2BitwiseBard/rocky/README.md

# PROJECT ROCKY — Pebble

A 1:3-scale, radially symmetric **pentapod walking robot** (five legs, three
servos each, transforming hands) built from parametric 3D-printed parts and
Feetech bus servos, with a MuJoCo simulation that walks, gestures and gets
itself back up, and a tool harness that lets a person or a language model
drive it by text, voice or MCP.

<p align="center">
  shove → tumble → self-right → walk away (MuJoCo)<br>
  <em>The D048 shove: 40 N at the shell rim (10 N·s, 1.5× bodyweight), a tumble, the <code>recover1</code> righter and the planted ramp stand it up, and the analytic gait walks away.</em>
</p>
<p align="center">
  the wave gait<br>
  <em>The five-phase wave gait, closed-form IK, no learning: 2.0 s cycle, 24 mm step, and since D063 a soft-landing swing: walking at up to 34.2 mm/s and turning at 0.185 rad/s, both inside the servo's budget.</em>
</p>

The physical robot is not assembled yet. Everything "green" below is green
in simulation or in CAD checks, which this project treats as a different
claim from "it works on hardware".

## Status (2026-10-09)

| area | state | evidence |
|---|---|---|
| **CAD** | print-clean, rebuilt around a **measured STEP of the real ST3215** (D047). The body layout is **built** from the owner's 15 picks (D064, 2026-10-07/08): a keel tub 8 mm under the deck holds the 380 g battery sled, with the XT60 mate and the loop key in its nose and a door on one I3 latch; the hub shelf under the deck's north half carries the bus adapter, buck and UBEC face-down beside the 12 V node and the star board; the tray holds the Pi on 11 mm standoffs and comes out only with the carapace off; the stand is a cradle for the tub; the I1 leg port docks on cone seats (`check_dock.py`). A FreeCAD / CalculiX stress check loads the leg parts with what the servos can push (D061): 4 of 5 pass, and **`coxa_yaw_base` fails at SF 1.10** in the servo-stall case on the real I1 support, an owner decision still to come (B139) | `cad/run_all_checks.py` **31/31** (29 modules, `check_printability` 61 parts 0 hard, `check_sim_mirror`), [docs/PRINT_PLAN.md](docs/PRINT_PLAN.md) |
| **Physical build** | nothing printed, nothing ordered, nothing assembled; the first prints (pre-D047) did not fit and are retired. The order of buying and printing is [docs/BUY_AND_PRINT_ORDER.md](docs/BUY_AND_PRINT_ORDER.md): the port coupons (the deck patch and four plates) print first; print one `coxa_yaw_base` for the bench, not five, until B139 is decided. The assembly guide walks the build step by step from the CAD. The bench kit (one leg: 4 × ST3215, bus adapter, adjustable supply, fasteners) is ~$282, the core robot ~$1,265 (`bom/totals.py`, 2026-10-08) | [docs/ASSEMBLY_GUIDE.md](docs/ASSEMBLY_GUIDE.md), [bom/BOM.csv](bom/BOM.csv), [bom/README.md](bom/README.md), `media/2026-09-22_first_prints.jpg` |
| **Sim + control** | the sim stops flattering the servo (D052/D052a): a peak-torque clip plus a thermal budget, every motion through one feasibility checker and the gait envelope (34.2 mm/s, 0.185 rad/s). Since D064 it carries the **belly** (the keel tub, the hub shelf's plate and posts as contact geoms) and the torso's real mass, CoM and inertia from a CAD pose table: torso 1555.0 g, robot 2843.0 g, fingerprint `965f4f70e5d1`. Wave gait: 189 of ~198 mm in 6 s, 0.42° max tilt; standing shove floor 30 N (1.08 BW). An always-on void guard stops walks at an edge; in a lip band of approach angles (8 of 364) the robot no longer falls off but tips 20–24° onto the keel and hangs there. A **body leveler** (D065) raises feet from the IMU tilt (standing on 8° 8.06 → 2.96–3.22°, on a 20 mm stone 3.88 → 0.36°), but lands **off**: its terrain bench (`sim/terrain_bench.py`) first failed on the plane a noisy IMU or a turn, a stop or a shove leaves on flat ground, the 5 % slower walk on a levelled slope (the derate alone is 94.97 % of the bare envelope), belly clearance on rubble and two false voids that are the probe's (B161); after B162 wip 1 (a 1.0 s tilt filter, a rough-ground sink cap, three rules restated where they measured something else) it failed on R1 alone, but a review found that cap's belly clearance in-sample (21.7 mm on held-out rubble); re-picked on train seeds and checked on held-out ones (a 3 mm sink, latched, failing closed without the probe), the rubble clears (≥ 25.1 mm) and the stairs fail instead: one row 24.4 mm under the belly, two walk under 95 % of the shipped stack, and the stairs keep little of their levelling (B162) | [docs/SIM_GUIDE.md](docs/SIM_GUIDE.md) |
| **RL / self-righting** | a **hybrid**: RL rights the body, an analytic ramp stands it, and since D064 the supervisor holds the righter's hip command on legs 1–4 at ≥ −51.05° so no leg folds under the keel. The first retrain on the D064 model, `recover8_d064` (2026-10-08, 12 M steps, the `recover7` recipe), is the first policy to earn hand-offs under the supervisor: 3 of 12 falls with the latency-carrying servo model (12/20 raw; `recover1` 0), none with the latency-free nominal servo (it stands up tilted and the 3 s stall ramp finishes), 0 belly contacts; it is the shipped righter (`sim/righter.py`, `recover1` the fallback). The system (supervisor + righter + stall ramp) stands 20/20 vs 12/20 with no righter on the nominal servo, 18/20 vs 8/20 randomised. The walkers predate D052 and are zeroed. The walkers predate D052 and are zeroed | [docs/RL_GUIDE.md](docs/RL_GUIDE.md) |
| **Tests** | 1,190 fast tests pass (`./rocky.sh test`: `sim/tests` 854, driver + gait + harness 336; `sim/tests` gives the same counts with the leveler forced on, `ROCKY_LEVEL=1`, though only 17 of its tests ever raise a foot) + 2 strict xfail (the void guard's lip band; 5 with the slow tests); `sim/tests` takes about 5 min since D065 stopped a per-step deep copy of params (about 10 before), with 8 skipped on the reference setup (the brain-install checks, which need local model files); URDF ≡ MJCF ≡ analytic FK; CI also runs `ruff check .`, the slow tests and `run_sim`, and fails if the regenerated MJCF / URDF or `docs/TOOLS.md` differ from the committed ones | `.github/workflows/ci.yml`, `./rocky.sh test` |
| **Harness** | one tool registry (`harness/capabilities.py`, 23 tools, D056) generates every surface: the MCP server's live list (8 tools on the mock or in-process sim, 15 over a running cockpit, 19 with place recognition), the local brains' schema and the tools page; any OpenAI-compatible model server or Claude drives it | `harness/`, [docs/TOOLS.md](docs/TOOLS.md) |
| **Cockpit** | one running sim in the browser (D049–D057): cameras, map, switchable brains behind a stop gate (installed and benched, D055), ~1 s speech, `look` / `find_object` and a scene memory (D054), world editor, recordings, RL panel, gesture studio; the phone over HTTPS. Place recognition (D057, off by default): 21/21 verdicts, changes 3/6 | [docs/COCKPIT_GUIDE.md](docs/COCKPIT_GUIDE.md), [docs/BRAINS.md](docs/BRAINS.md), [docs/PLACES.md](docs/PLACES.md) |
| **Hardware bridge** | `rocky_driver` + the cockpit's bridge, made safe before any servo touched it (D052): standstill-only mirror, a soft first move (parked goal, 40 % torque, 200 c/s), then a per-servo goal speed every tick (D063), whole-leg fault cuts, EEPROM angle limits. **Mock-verified only: no real servo has been on the bus** | `sim/hw_bridge.py`, [bench/BENCH_RUNBOOK.md](bench/BENCH_RUNBOOK.md), B32 |
| **Design changes** | `cad/params.yaml` is the one source of truth and the robot's shape is data (D053): params `robot:` is validated by `rocky_model.robot()`, and the MJCF / URDF read their stations and actuator order from it; servo, length, foot, material and body-part changes follow one documented loop; a 4th joint or a 6th leg validates but does not run yet (B36) | [docs/DESIGN_CHANGE_GUIDE.md](docs/DESIGN_CHANGE_GUIDE.md) |

## Layout

```
rocky/
├── README.md, BUILD_LOG.md, NOTES_INBOX.md   this file · the notebook (newest first) · the raw inbox
├── rocky.sh             launcher: `./rocky.sh help` lists every command
├── rocky.env.example    every machine setting (ROCKY_*) with its default; copy to rocky.env (git-ignored)
├── pyproject.toml       pip-installable core (gait modules + bus driver) and the extras
├── cad/                 build123d parametric parts; params.yaml is the single source of truth
│   ├── run_all_checks.py   the CAD CI: 29 modules (the joint suite, the I1 dock path) + printability + the
│   │                    sim-mirror check (--derived: +6 generators, --fem: the stress check)
│   ├── fem_check.py     will a leg part break? CalculiX stress check under servo-limited loads (D061)
│   ├── ref/             the measured ST3215 STEP every leg part is derived from (+ its Apache-2.0 license);
│   │                    rpi5_envelope.json, the Pi 5's boxes from the official STEP (+ its MIT license)
│   ├── out/             exported STL/STEP/PNG (git-lfs) and PRINT_PREP_PACK.pdf, the print pack;
│   │                    fem/FEM_REPORT.md + a stress picture per leg part; drawings/ (A4 sheet per leg part)
│   ├── pebble_viewer.html  self-contained WebGL viewer (git-lfs)
│   └── leg_frame.py, servo_st3215.py, servo_mount.py, iface.py (the interfaces), part_*.py
│                        (part_bay.py: the keel tub, lid and door; part_busboard.py: the hub shelf;
│                        part_stand.py: the cradle), check_*.py (check_dock.py: the I1 dock path;
│                        check_sim_mirror.py: the sim's copies of the CAD, held to the parts)
├── gait/                pure-numpy control: params loader (rocky_model.py), wave gait + IK, feasibility
│                        checker, reflex supervisor, watchdog, gestures + keyframe player (gestures/*.json)
├── sim/                 MuJoCo: build_mjcf.py (from params + mass_audit.py's CAD pose table), playground.py,
│   │                    cockpit.py + cockpit_ui.html, world_builder.py, scenes.py (shared scene helpers),
│   │                    envfile.py (reads rocky.env), rocky_env.py + rocky_recover_env.py (gymnasium), train_ppo.py,
│   │                    eval_*.py, runs/ (checkpoints), brain_install.py + brain_bench.py,
│   │                    place_memory.py + place_bench.py, run_sim.py (the CI smoke run)
│   └── experiments/     one-off experiments, run from the repo root; results/ (pre_d052/ = older records)
├── harness/             tool registry (capabilities.py → docs/TOOLS.md), MCP server, mock / sim / cockpit
│                        backends, local_brain.py (LLM), intent.py (regex brain + voice pipe)
├── driver/              rocky_driver: dual-protocol Feetech bus driver + a byte-faithful mock
├── bench/               bench-day scripts (all runnable --mock) + BENCH_RUNBOOK.md
├── perception/          legged-odometry EKF, ICP scan matching, cliff detector, foot contacts
├── ros2/                ROS 2 packages (scaffold; URDF generated from params, parity-checked)
├── audio/               chord-speak voice + samples
├── bom/                 BOM.csv, the one bill of materials, + README.md + totals.py
├── docs/                guides, decisions, backlog, interfaces, the code map, the buy-and-print order;
│                        archive/ = superseded plans and proposals, old logs, dated reviews
└── media/               photos, GIFs
```

## Setup

Python ≥ 3.10 (the reference venv runs 3.12) on Linux or WSL2. Everything runs
from the repo root, and `rocky.sh` expects the venv at `.venv`.

```bash
git clone https://github.com/2BitwiseBard/rocky && cd rocky
python3 -m venv .venv && . .venv/bin/activate        # or: uv venv && . .venv/bin/activate
pip install -e ".[sim,harness,cockpit,rl,dev]"       # editable: the core reads ../cad and ../sim
cp rocky.env.example rocky.env                       # this machine's settings: uncomment what differs
./rocky.sh help                                      # every launcher command and the env it reads
```

- **Extras:** `sim` (MuJoCo, gymnasium, video), `harness` (MCP server, the
  OpenAI-compatible client), `cockpit` (the browser playground; `anthropic` for
  the Claude brain), `rl` (torch), `dev` (pytest, ruff); on demand `cad`
  (build123d, pinned, and the print pack), `hw` (pyserial, for a real servo bus),
  `ollama` (`harness.local_brain` without `--base-url`), `viewer` (playwright,
  for `cad/test_viewer.py`).
- **GPU torch:** install torch from pytorch.org's index for your CUDA *before*
  the `rl` extra so pip keeps it; CPU torch is fine for evaluation.
- **Sound and video:** chord-speak plays through `aplay` (alsa-utils) or
  `ffplay`; videos need ffmpeg.
- **Brains and voice:** any OpenAI-compatible model server (llama-swap,
  llama-server, Ollama, LM Studio, vLLM) and a whisper server with
  `/v1/audio/transcriptions`. Endpoints and model ids are `ROCKY_*` settings in
  `rocky.env`; the defaults are the reference setup measured in D055 (one 16 GB
  GPU running llama-swap), see [docs/BRAINS.md](docs/BRAINS.md).
- **Phone:** `./rocky.sh tailnet` publishes the cockpit over HTTPS on your
  tailnet (`https://<machine>.<tailnet>.ts.net:9445`); the cockpit itself binds
  127.0.0.1.
- **Claude Code over MCP:** `cp .mcp.json.example .mcp.json`, then
  `./rocky.sh chat` (the example documents `ROCKY_BACKEND`).
- **Windows:** WSL2 + Ubuntu runs everything verbatim (`wsl --install`; WSLg
  shows the MuJoCo window on Windows 11). Native Windows runs the sim with the
  same pip line, but `rocky.sh` is bash, so call the Python entry points the
  guides name; chord-speak then needs `ffplay` (ffmpeg).

## Quickstart

```bash
./rocky.sh test                                      # the fast ladder: driver, harness, gait, sim/tests (~9 min)
MUJOCO_GL=egl python sim/run_sim.py                  # the wave gait walks, headless; video in sim/out/run_sim/; exits 1 on a fall
MUJOCO_GL=glfw python sim/playground.py --viewer     # live window + REPL + arrow-key teleop (or ./rocky.sh play)
./rocky.sh cockpit                                   # browser playground: http://127.0.0.1:8765
./rocky.sh cad-check                                 # the CAD CI (needs the cad extra)
./rocky.sh cad-check --fem                           # + the leg stress check (needs gmsh + CalculiX: FreeCAD has both)
./rocky.sh cad-open coxa_fork                        # a part (or --fem PART, its stress result) in FreeCAD
./rocky.sh cad-drawings                              # A4 TechDraw sheets of the leg parts (FreeCAD, no window)
```

## Driving it

- **Simulation** — [docs/SIM_GUIDE.md](docs/SIM_GUIDE.md): how the sim is built
  from the CAD, the playground, the experiments, worlds, videos, and the MCP /
  LLM driving loop.
- **Cockpit** — [docs/COCKPIT_GUIDE.md](docs/COCKPIT_GUIDE.md): tabs, brains,
  saying stop, remote mode, the phone.
- **Tools** — [docs/TOOLS.md](docs/TOOLS.md) (generated from
  `harness/capabilities.py`): every tool a brain or an MCP client can call.
- **Brains** — [docs/BRAINS.md](docs/BRAINS.md): which models drive the robot,
  how to install and bench one.
- **Places** — [docs/PLACES.md](docs/PLACES.md): place recognition from the
  senses (D057, off by default).
- **Perception on the robot** — not built yet: the plan is
  [docs/SIM_GUIDE.md](docs/SIM_GUIDE.md) §9.
- **Reinforcement learning** — [docs/RL_GUIDE.md](docs/RL_GUIDE.md): the two
  environments, training and evaluation step by step, the honest results table.
- **Servos** — [docs/SERVO_NOTES.md](docs/SERVO_NOTES.md): is the ST3215
  good enough, what limits fluid motion, and the upgrade ladder.
- **Design changes** — [docs/DESIGN_CHANGE_GUIDE.md](docs/DESIGN_CHANGE_GUIDE.md):
  a part, a fit, a servo, a size; the robot-as-data steps and their status;
  what survives a scale-up to full Rocky.
- **The code** — [docs/CODE_MAP.md](docs/CODE_MAP.md): where each piece lives
  and what calls what.
- **Hardware** — [docs/BUY_AND_PRINT_ORDER.md](docs/BUY_AND_PRINT_ORDER.md) (what
  to buy and print, in order), [docs/ASSEMBLY_GUIDE.md](docs/ASSEMBLY_GUIDE.md) (the
  build, step by step, with pictures), [bench/BENCH_RUNBOOK.md](bench/BENCH_RUNBOOK.md)
  (bench day), [docs/WIRING_HARNESS.md](docs/WIRING_HARNESS.md),
  [docs/INTERFACES.md](docs/INTERFACES.md), [docs/PRINT_PLAN.md](docs/PRINT_PLAN.md),
  [bom/BOM.csv](bom/BOM.csv).

## Ground rules

These are the ones that have actually cost something when broken.

- **`cad/params.yaml` is the single source of truth** for dimensions. Parts,
  the MJCF and the URDF are regenerated from it, never edited downstream.
- **Checks green before anything ships.** `cad/run_all_checks.py` 31/31 and
  the fast test suites; CI runs them on every push.
- **Sim honesty.** A negative result is a result and gets written down.
  Seven recovery retrains (`recover2` → `recover7_d063_curriculum`) failed to
  beat the policy they were meant to replace, and every one is recorded
  rather than buried. Shoves are quoted in N·s and bodyweights, and the demo
  shove is a shove, not a strike (D048).
- **The SCS0009 hand servo never sees 12 V.** It has its own 6 V rail (D016).

## Where the record lives

- [BUILD_LOG.md](BUILD_LOG.md) — the engineering notebook, newest entry first.
- [docs/decisions.md](docs/decisions.md) — numbered decisions D001–D064 (with
  the amendments D052a and D055a), cited everywhere.
- [docs/DESIGN_BACKLOG.md](docs/DESIGN_BACKLOG.md) — ideas and follow-ups with
  verdicts (B1–B155).
- Reviews: [docs/archive/REVIEW_2026-09-22.md](docs/archive/REVIEW_2026-09-22.md)
  (mechanical, electronics, repo), BUILD_LOG sessions 9f (2026-09-24, sim
  honesty, D052) and 9i (2026-09-26, the whole-repo audit; both archived), and
  the two 9q reviews of the D064 build.
- [NOTES_INBOX.md](NOTES_INBOX.md) — raw measurements and results, filed later.
- [docs/archive/](docs/archive/README.md) — the founding plan, the build log
  before session 9l, full-length decision text, the body-layout proposal, the
  perception plan and superseded reports.

## License

MIT (see `LICENSE`). The ST3215 reference STEP in `cad/ref/` is from
TheRobotStudio/SO-ARM100, Apache-2.0 (license text in
`cad/ref/LICENSE-Apache-2.0.txt`); the Pi 5 envelope `cad/ref/rpi5_envelope.json`
is derived from Raspberry Pi Ltd's STEP, MIT (`cad/ref/LICENSE-MIT-RaspberryPi.txt`).
