2BitwiseBard/rocky/docs/DESIGN_BACKLOG.md

# Design backlog

*Ideas and follow-ups with verdicts (B1–B163, started 2026-07-30). Each got a bounded look: a sim
test where physics could answer, CAD where the part was cheap, spec-and-defer where it depends on
hardware not yet in hand. Statuses: work to do — OPEN, PROPOSED, PROPOSAL (measured, the owner
picks), BLOCKING, RECOMMENDED, OPTION, MEASURED (an option measured, the owner decides), COUPON (a print answers it), QUEUED, RERUN PENDING; waiting on
hardware — SPEC'D, DEFERRED; partly done — HALF / MOSTLY / MECHANICAL / STEP 1 / PARTLY SHIPPED;
done — SHIPPED, NEGATIVE (tested, don't build), MERGED.
B42–B65 are the follow-ups of the 2026-09-26 review (BUILD_LOG 9i), B66–B73 those of its final pass (2026-09-27), B74–B75 from the first FEM run (D061), B76–B79 from the servo research ([SERVO_NOTES.md](SERVO_NOTES.md)), B80–B96 from the assembly-guide geometry check ([ASSEMBLY_GUIDE.md](ASSEMBLY_GUIDE.md), 2026-09-28), B97–B115 from D063's reviews, regen and follow-ups (BUILD_LOG 9m), B116 from the 2026-09-30 batch (BUILD_LOG 9n), B117–B138 from the two read-only prep rounds ahead of the body-layout build (2026-10-01/02, BUILD_LOG 9p; records in [archive/prep-2026-10-01/](archive/prep-2026-10-01/)), B139–B155 from the body-layout build (D064, 2026-10-07/08, BUILD_LOG 9q), B156–B162 from the body leveler and its terrain bench (D065, 2026-10-09, BUILD_LOG 9r), B163 from its review.*

## Open

| # | idea | verdict | evidence / where |
|---|---|---|---|
| B6 | Palm magnets + shell tool docks | **HALF-SHIPPED (session 5)** | Shell side DONE: vertical I6 male bars at ±27° on every carapace sector (`part_shell.py`) — any dovetail shoe (B11 whisker, future docks) slides on today. Palm side still waits for hand v0.3. |
| B7 | Fingernail lip + TPU tip caps | **DEFERRED to hand v0.3** | Fingertip geometry changes ride the post-caliper rebuild; TPU foot pad (shipped, `part_footpad.py`) covers the walking-wear case meanwhile. |
| B12 | Lidar mount on the hatch cap | **SPEC'D, unblocked (D058: the LDRobot D500)** | Cap variant with a puck seat + bolt-circle bosses + a wire drop into the cavity; build it from calipered dimensions of the unit in hand. The D500's numbers and the params block: B46. |
| B14 | Charging dock | **MECHANICAL SHIPPED (5c); electrical OPEN (phase B)** | `part_dock.py`: walk-on plate + funnel rails (±8 mm capture → ±0.8, the XT60 float's own tolerance), shin bumper, plug tower with a VERIFY-height XT60 carrier. The robot-side port waits for the harness (`bom/BOM.csv` B-12: XT60E-M panel mounts). Since D064 it reads the keel tub (`iface.bay_tub_extent()`): the belly is 62.6 mm over the ground at stance and 42.6 in the 20 mm crouch, so the plug face came down (`PLUG_H` 52 → 39.6, 1.0 over the crouched belly, VERIFY against the printed tub). The funnel rails still top out 30 mm over the ground, 12.6 under the crouched belly: the funnel never touches the tub. |
| B15 | Fingertip grip serrations (hand v0.3) | **QUEUED with the caliper rebuild** | Transverse V-grooves on the inner cone faces; zero-cost boolean once hand v0.3 regenerates. Deliberately NOT sculpted against nominal geometry — that would be printing guesses. |
| B16 | Camera-behind-gill bracket | **SPEC'D (`docs/archive/PERCEPTION_PLAN_2026-09-30.md`)** | Camera Module 3 Wide (`bom/BOM.csv` C-04), fixed on an internal bracket, lens through a gill-slot aperture: vision without breaking the eyeless canon face; no pan turret. Prints with the shell regen once a camera is in hand (dims VERIFY). The sim eye vs the real lens: B45. |
| B22 | Servo swap without pulling the femur | **DEFERRED** | The knee cup's two horn-face rim screws sit under plate A's beam; a knee/hip servo swap = plate B (4) + coupler clamps (4) + plate A off, then the cup's 4 screws. `check_assembly` models the screws as driven before the femur goes on. Revisit only if swaps turn out frequent. |
| B23 | Horn hole radius + thread | **COUPON (batch 1)** | The STEP reads 14.0–15.6 BCD and RobotShop's kit list says M3 × 6; SO-ARM100 lore says M2. `coupon_yaw_hub` + `horn_coupler` carry radial slots and M3/M2+washer counterbores; one screw on the real horn settles `params.servo_st3215.horn_bcd` / `horn_screw_m`. |
| B25 | Plain foot before the iris hand | **RECOMMENDED** | The hand-as-foot (D005) is the most complex, least-tested subsystem and takes every ground strike. The I2 bayonet already accepts a plain TPU foot on the SEA stub; walk on that first, fit the hand as a tool later. |
| B26 | Heat-set inserts where screws are opened often | **OPTION** | D047 uses thread-forming M3 in PETG for plate B's four bosses and the tube pinch bolt. If plate B comes off more than twice, the Ø8 bosses take the Ø4.6 × 5.7 insert pocket already in `params.print`. |
| B27 | `deck_t` 4.0 in params vs 6.0 hard-coded in `iface.py` / `part_deck.py` | **OPEN** | One number, two values; the params one is dead (a note in params since 2026-09-26, value unchanged). Deck v0.5 (D064) leans on the 6 in two more places, the blind shelf-post holes (5 deep from below, 1.0 of skin) and the tray strike (`latch_strike` wants a frame ≥ 6.0), besides `iface.hook_geometry`'s hook gaps. Unify before the deck reprint. |
| B28 | Fit ladder → params | **BLOCKING** | The ladder was printed weeks ago and nothing consumes it: `params.print` still holds the initial guesses. First item of `docs/PRINT_PLAN.md`. |
| B31 | Cockpit follow-ups | **MOSTLY SHIPPED** (D050) | Shipped: contact-seeking stance, the map, recording / replay, saved + random worlds, the walker, voice, the phone layout. Open: a websocket transport (only if the LAN case matters; the phone over the tailnet works as is), climbing a step taller than the swing height. |
| B32 | Bench bring-up through the cockpit | **OPEN** (D051 shipped the tooling, mock-verified only) | First real servo on the bus: `rocky.sh cockpit` → Hardware → connect the adapter port → scan → set ID one servo at a time → center each joint at the jig → dir test with jog → `robot → sim` to confirm the IK frame → `sim → robot` with the stream cap at 200 c/s for the first stance. Then: does the real leg track a gesture at the servo model's numbers (turn the model on, compare)? Record the measured no-load slew and latency into `servo_model.DEFAULTS`. The driver's VERIFY-ON-BENCH list (D060): the STS `PRESENT_LOAD` sign bit (10 per LeRobot vs 15: push one servo by hand both ways while `register_dump` runs), the `POSITION_OFFSET` sign bit (11 vs 15: run `pose_check` after any `--burn`), baud codes 5–7, the SCS0009 model number (1284 vs the mock's 1285), `PRESENT_CURRENT`'s sign; from D052: GOAL_SPEED 0, torque-enable toward the last goal, behaviour at an EEPROM angle limit. Later: hands (SCS0009) in the bridge, a per-leg contact switch feeding `Playground._probe` so the real foot probes like the sim foot. From D063: read 85/86, the return delay and Lock off a real servo with `bench/register_dump.py` and pick 85/86 (the bench half of B79); the goal-speed sag test (B98) before the robot stands on the per-tick goal speed; turn a printed latch (B99). |
| B33 | CAD-derived CoM / inertia, an SEA slide joint, ToF floor sensors | **PROPOSED** | Three things the D052 model still guesses. (a) Masses come from CAD volumes, but each link's CoM and inertia are primitive stand-ins (torso = two cylinders split 0.75 / 0.25, shin CoM at 0.46·L3); build123d gives each part's centroid and inertia tensor, so `mass_audit` could write them and `build_mjcf` / `generate_urdf` / the feasibility CoM model (which mirrors `build_mjcf.leg_xml`) read them. Matters most for `manip_adjacent`, whose CoM margin is 17.4 mm. (b) The SEA cartridge (D010: 7 mm travel) is rigid in the sim: a slide joint with the spring rate would make landings, shoves and the foot switch (which closes on spring compression) physical, instead of a force threshold on a rigid sphere. (c) A downward ToF sensor per leg (or on the shell) would see a void *before* a foot probes into it — the lidar plane (~0.18 m) is blind below, and the probe-based void guard, even with the D052 touchdown gate, still falls in a lip band of approach angles (7 of 310 on a 1° grid, D052a; on the D063 model 8 of 364, all at 9–15°, none of them firing the guard, after a held late foot's probe went to a 7 mm lead: 11 before it; on the same grid offset by 0.5°, 9 of 360, and one, 15 mm/s at 15.5°, fires the guard 0.62 s into the hold and still tips, to 22°: measured 2026-09-30 for B103): a foot centred 0–9 mm past the edge sits on the corner, closes its switch and slides off — nothing a foot switch can see, which a look-ahead sensor would. On the D064 model (`deae868522cc`) those approaches stop falling: the keel tub lands on the edge at 20–24° and the robot hangs there (8 of 364 and 16 of 724 tip past 10°, 0 after a fire); a real keel may slide off instead (B140). (a) is software only; (b) needs the spring rate from the bench; (c) needs a mount and pins on the harness; candidates (`bom/BOM.csv` X-02): VL53L4CD (single zone, 1–1200 mm, 18°, 0.5 g, fixed address 0x29, so XSHUT or the mux) or VL53L8CX for an 8 × 8 grid. The spring for (b): B44. |
| B34 | A righter that earns a handoff (was B30 + B34) | **PARTLY MET (2026-10-08): `recover8_d064` earns 3 hand-offs in 12 falls under the supervisor with the randomised (latency-carrying) servo, 0 with the nominal one; shipped as the default righter** | No policy earns a handoff in the system on the D052 contract: `recover1` 0/20 `handoff_ok` (the system stands 20/20 vs 11/20 with no righter, every exit on the stall ramp). Tried: reward v3 with a smoothness cost at 3 rad/s (`recover5_v3` 2/20, `recover5_v3_warm` 4/20 vs `recover1`'s 7/20 then; smoother, 58 % of tick moves pinned vs 73 %) and the first obs-v2 retrain (`recover6_d052`, 3 M steps: 0/20 `handoff_ok`, supervisor 11/20 = no-righter 11/20). **2026-09-30, shipped:** the side → back curriculum (`train_ppo.py --curriculum side-back`, `RecoverEnv(curriculum=...)`): a drop that lands more than 110° from upright is kept with probability *reach* and otherwise drawn again, and reach ramps 0 → 1 between 15 % and 75 % of the run, so landings past 110° go 0 → 46 % (measured, 120 seeds); evaluation never uses it, and at reach 1 the env is the default one draw for draw. `CommandSlew` is in the gait RL env (`cmd_slew`, flag `unslewed cmd` on older walkers; the recover env has no velocity command). **Result, `recover7_d063_curriculum`** = the `recover6_d052` recipe (v2, 4.0 rad/s, servo random, EMA 0.4, `--log-std-max -0.5`, 8 envs) + the curriculum, 12 M steps on CPU on fingerprint `87215110e9c4` (unit `rocky-train-recover7`, CPU quota 8, 2026-09-30 10:46 → 12:28, 1.96 k steps/s averaged; reach 1 from 9.0 M steps, last training return 330). Evaluated as [RL_GUIDE.md §5](RL_GUIDE.md#5-the-experiment-ladder) rung 0 says (header `robot fingerprint match`, `[D052 contract]`): **hw 3/20 `handoff_ok`** (side 3/7, back 0/6, tumble 0/7; end tilt median 0.5°; hold-pose 1/20, random 0/20), the first handoffs on the D052 contract; `--randomize` 4/20 (back 0/9, side 2/9, tumble 2/2); **`--supervisor` 11/20 = no-righter 11/20 with 0 `handoff` exits** (all 9 declared falls exit on the stall ramp; back 0/6, side 5/7, tumble 6/7), where `recover1` stands 20/20; `audit_righter.py --servo nominal` beside `recover5_v3_warm` (40 N, 5 seeds): ctrl 1.9 against 4.5 rev/s and 5 % pinned, but it lands on its back every time and never stands (0/5 upright, FALLEN entered 6× each; `recover5_v3_warm` 5/5 upright, all by the ramp). Against the bar (≥ 1/20 `handoff_ok` with at least one handoff exit, ctrl rev/s no worse than `recover5_v3_warm`'s in the same audit, 4.5 on `87215110e9c4`; 4.4 on a pre-D063 model): the handoffs and the ctrl rate pass, the handoff exit fails, and the back, the curriculum's target, is still 0. All 15 log σ sat at the `--log-std-max -0.5` cap from 6 M steps to the end (entropy 13.78, the cap; `recover6_d052` ended at −0.80 … −0.94). **NEGATIVE; `recover1` stays shipped.** Why the plain eval's side handoffs never become a supervisor `handoff` exit is not diagnosed (a first look: when the policy reaches `handoff_ok` against the 3 s stall rule). Next in order: v3 at 10 M; `thermal_heat0` warm starts (an env argument, no trainer flag yet). Same night if the GPU is free: a D052 walker on the slewed gait env (every walker on disk is pre-D052 and has no envelope). **Re-evaluated on `deae868522cc` (D064, every checkpoint legacy):** `recover7` hw 5/20 (side 4/7, tumble 1/7), `--supervisor` 11/20 with 0 handoff exits; `recover1` system 20/20 (11/20 without), hw 0/20. The next retrain: B146. |
| B35 | The onboard loop | **OPEN** (sim side ready; nothing on the Pi) | What stands between the sim's control loop and the real robot: an **IMU driver** (BNO085 → the same gravity / gyro `sim_imu.SimIMU` produces); **foot switches** (the SEA microswitches → `perception/contacts` semantics, 2.0 / 1.0 N hysteresis to be re-read as switch states); a **50 Hz loop on the Pi** running WaveGait + `budget` + ReflexSupervisor (with `q_meas`, `probe_dz`, `handoff_ok`) + the Playground's guards, writing through `SoftStream`; a **host watchdog** (laptop ↔ Pi heartbeat; loss → planted stop, then limp) — the bridge's 2 s sim heartbeat is the laptop-side half; a **HardwareBackend** (`harness/hw_backend.py`: the registry's tools (D056) on `PebbleRobot`, so `rocky.sh chat` / the brains drive the robot); **`cockpit --remote`** (the cockpit as the UI for the robot's loop, not a second controller — the mirror today streams sim targets, which is the bench tool, not the runtime). Also a numpy / ONNX path for the righter (torch on the Pi is not wanted). **D065 (2026-10-09):** the body leveler is Pi-ready (`gait/pebble_level.py`, numpy, ticks on time inside `ReflexSupervisor.step`), but the stance probe, the touchdown gate and the void guard it holds for still live in `sim/playground.py`, so the Pi loop would get the leveler without them: their move into `gait/` is B157; the IMU it needs calibrated first, B159. The rough-ground sink cap (B162) reads the probe's `probe_dz`; without it a walking leveler fails closed (its sink capped at `sink_max_mm`, 3 mm: a 3° slope then levels only to ~2°). |
| B36 | The robot as data | **STEP 1 SHIPPED (D053), steps 2-10 OPEN** | `docs/DESIGN_CHANGE_GUIDE.md` §9 (the design and the step status) and §0–§8 (how to change the design today). Step 1: params `robot:` + `rocky_model.robot()` / `validate()` / `actuator_order()` / `id_table()` / `topology_hash()`; stations, leg count and actuator order in `build_mjcf` and `generate_urdf`; `pebble.xml` byte-identical, fingerprint unchanged. Remaining, in order, each its own commit with the suite green: **(2)** generators build the chain (bodies / joints / axes / offsets, kp / kv / armature / protocol into `actuators:`, a generated `rocky.ros2_control.xacro`); **(3)** close the fail-open paths (feasibility codes from joint names, `check_urdf_parity` n_lim, mock ids from `id_table()`, the driver's broad `except` into 3-joint limits, a bridge that refuses an uncovered id, no silent hand-budget fallback); **(4)** actuators by name (`sim/model_index.py`) instead of `ctrl[:15]` / `ctrl[15:20]` in the playground, both RL envs, `rl_common`, `sim_lidar`, `servo_model` — BEFORE any topology change; the cockpit / harness slices are handed to that workflow; **(5)** checkpoint safety: topology hash stamped, refuse on mismatch, `ROCKY_STRICT_FP`, `eval_recover --accept-robot`, fingerprint extended (a D-number); **(6)** `gait/leg_kin.py`: generic FK / IK, analytic fast path by chain shape, numeric IK with a redundancy rule and a measured Pi budget, replacing four FK copies; **(7)** materials / part_material / part_fill in params + one `sim/body_layout.py` (a D-number: fixes the PETG parts weighed as PLA); **(8)** `cad/check_params_parity.py` (tibia stack + tube cut length BEFORE the first leg is assembled, foot literals, deck station count, sweeps from `joints.pos_deg`); **(9)** `rocky.sh regen` + SIM_GUIDE / RL_GUIDE; **(10)** only with an actual topology change: driver / bridge per-joint table, reflex / gestures / keyframes beyond (N, 3), duty = 1 - 1/n, a generated RL obs builder, per-leg overrides, the deck and shell as an n-gon. |
| B38 | Place recognition: "basement at home" / "somewhere new" / "the bedroom has a new chair" | **STEP 1 SHIPPED (D057), OPEN beyond it** | Shipped: `sim/place_memory.py` recognises a place from the senses (a scan signature, a look-description embedding, a radio slot), one confidence per place, known / new / ambiguous, no single sense says known, a change needs two looks; the cockpit runs it behind `--recognize` with four place tools; `sim/place_bench.py` scores the three verdicts (both runs in `docs/PLACES.md`; second run 21/21 verdicts, changes 3/6). Remaining, in order: **(a)** the hierarchy home → room → spot (`parent` is reserved; a spot is a scan sample, a home a radio cluster); **(b)** the radio fingerprint on the real robot (its Wi-Fi scan; the sim never makes one); **(c)** a recognition switch and the place on the cockpit page (`sim/cockpit_ui.html` has neither); **(d)** the real camera and puck (every number so far is clean MuJoCo, an upper bound), with a translation between session map frames (`scan_align` gives the yaw only); **(h)** an ADDED object is never confirmed: the eye names the planted chair a box and, asked again from the same spot after the 30° turn, denies it; fix = the confirming look from a sidestep and name folding (chair ~ box ~ cube) in `checked_objects`; **(i)** the never-seen room is new by only 0.01–0.06 over its runner-up: widen the margin (a second description model, or the radio); **(j)** a room that shares another's walls is ambiguous until named: say so on the situation line. See also B59. |
| B39 | Who is speaking: speaker embedding, people memory, trusted-voice rule | **OPEN** | A speaker-embedding model (~20 MB, ~50 ms CPU) on the same clip whisper-fast gets; enrol from the cockpit; each utterance gets a name + confidence; known operators may command motion, unknown voices get chords and conversation (stop works for anyone); a people collection in the memory (name, voice vector, preferences, last seen, a bounded chat summary) and a situation-line clause ("Sam is here; last time they asked me to find the ball"); everything local, explicit enrolment, `forget` applies. |
| B40 | Sensors as data: lidar / ToF / depth camera in params `sensing`, an occupancy + height map in the memory | **OPEN** | `sim/sim_lidar.py` already fakes a 360° 2D puck with mj_ray fans, a legged-odom EKF and the LaserScan contract. Promote it to a first-class sensor in `cad/params.yaml` (mount height, rays, rate, range, min range, noise, the legs' occlusion), add a downward ToF per foot (VL53L4CD, or a VL53L8CX 8 × 8 grid: sees the edge before the foot does; B33c) and a depth-camera model on the eye (a depth render, free in MuJoCo); feed all three into a per-place occupancy/height map. The lidar block is B46. Real-robot order: 2D lidar on top + ToF at the feet, a depth camera with onboard compute, 3D lidar only on a bigger platform. |
| B42 | ESP32 Servo Driver: a robot role? | **OPEN** (decide at B35) | A bench tool today (D058): its web UI scans the bus, sets IDs and moves a servo with no code. A robot role needs firmware that does not exist: a Feetech passthrough for `rocky_driver` plus a heartbeat watchdog that turns torque off. Its input is rated 6–12 V against a full 3S at 12.6 V: check the regulator first. Until then the Pi + adapter is the bus path. |
| B43 | Pi 5 pin map | **OPEN** (goes in `docs/WIRING_HARNESS.md`) | BNO085 on SPI0 (GPIO 8/9/10/11 + INT + RST; P0/P1 set for SPI, VERIFY in the Adafruit guide); I²S out on GPIO 18/19/21 for the MAX98357A; I²C1 on GPIO 2/3 (INA228 0x40, TCA9548A 0x70, ToF behind the mux); five foot switches + two whiskers on GPIOs with internal pull-ups; UART0 (14/15) carries the bus adapter since D064 (B128: H2 RXD → pin 10, TXD → pin 8, GND pin 9 or 14; the D500 has its own USB adapter); 5 V into the header pins with EEPROM `PSU_MAX_CURRENT=5000` or `usb_max_current_enable=1`. Conflicts: the Pi has one I²S; the ReSpeaker HAT also takes SPI0 MOSI/SCLK (its APA102 LEDs, which an SPI0 IMU would clock), GPIO17 and the whole header; trig/echo sonar needs 10 GPIO with ~20 of 26 already spoken for. |
| B44 | SEA spring spec | **OPEN** (feeds B33b) | Work out installed and solid length from the SEA stack (13.2 mm bore, ~12 mm beside the slider flange, 7 mm travel) and write `leg.sea_spring {od_max 12.5, free_len, rate, preload}`. Stance load ~7.0 N per foot (2.84 kg on 4 feet, D064): a 1 N/mm spring bottoms out standing, ≥ 2 N/mm keeps half the travel for landings. Reconcile the preload with `foot_switch.close_n` 2.0 N. |
| B45 | The sim eye = the real camera | **OPEN** | The sim eye is fovy 70 at 4:3 (~86° wide); the Camera Module 3 Wide is 120° diagonal (~102 × 67°) at 16:9. Put the camera in `sensing.camera` (B40), then re-run `sim/vision_bench.py` and the `find_object` floor geometry. |
| B46 | D500 lidar block + mount | **OPEN** (B12 unblocked) | The part: 54.0 × 46.3 × 35.0 mm by the STL-19P datasheet (VERIFY with calipers; an earlier 38.6 × 38.6 × 33.5 was wrong), 45 g, 0.03–12 m, 10 Hz (6–13), ≤ 0.72°, UART 230400 on ZH1.5T-4P, 5 V 0.29 A. Make `sim_lidar.py` / `laserscan_spec.json` read a `sensing.lidar` block (today: 360 rays at 8 Hz over 0.12–6 m); build the hatch-cap mount from calipered dimensions; once it is weighed, lower `mass_hw.electronics_pod` and re-run the mass and torque audits. The sim's scan plane sits 60 mm over the torso origin (`sim_lidar.PUCK_DZ`) while `mass_audit` (D064) seats the D500 on the cap top (z 63–98): one of them moves when B12's mount exists. |
| B47 | INA228 on the servo feed | **OPTION** (`bom/BOM.csv` X-01) | Pack voltage under load, a coulomb-counting battery gauge, and a check on the servos' own `PRESENT_CURRENT` that the thermal model rests on. Needs a mount, I²C wiring and a read in B35; the onboard shunt reads to ~10.9 A. |
| B48 | Remote kill + Wi-Fi inside the shell | **OPTION** (`bom/BOM.csv` X-03, X-04) | (a) A latching 433 MHz 12 V 30 A relay after the fuse: a remote off switch, not a dead-man; check its DC rating; ~25 g, needs a mount. (b) Measure the Pi's RSSI with the shell closed (the Pi 5 has a PCB antenna, no u.FL); if it drops, a USB adapter with an external antenna (MT7921AU class). |
| B49 | Harness channel flex | **OPEN** (first bench torque test) | D059's channel leaves the −Y cup side wall bridging the 11 mm channel over 10 of its 24.5 mm footing. Watch that wall for flex in the first bench torque test (`bench/torque_step.py`). |
| B54 | Retry ladder vs terrain | **OPEN** | D060 derives the watchdog's stages inside the D052 envelope (24 → 34.8 → 42 mm step, slower cycles); D063's soft swing re-derived them: 34.8 mm at T 2.5 s / 21.4 mm/s and 42 mm at T 3.5 s / 28.1 mm/s (were T 3.0 / 40.6 and T 4.0 / 30.4). `run_stuck` on them (2026-09-30, B111: 34.2 mm/s for 32.9 s) with the watchdog: 4/4, 4/4, 2/4, 1/4 at 30/35/40/45 mm (bare 2/4, 2/4, 1/4, 1/4); on the D060 model: 4/4, 4/4, 2/4, 2/4; the old over-budget ladder did 3/4 at 40 and 45 mm. Redesign the ladder against the terrain (`run_stuck_voiced` defaults to rubble seed 1, which crosses 40 mm at 32.5 s; seed 0 does not). On `deae868522cc` (D064; the mass, not the belly: byte-identical with its contacts off): with the watchdog 4/4, 4/4, 3/4, 1/4 (bare 3/4, 1/4, 1/4, 1/4), 0 falls. |
| B55 | Gait stance flags at phase boundaries | **OPEN** | With a shifted phase, a floating-point knife edge can flag two legs as swinging at one sample instant; `gait/test_watchdog.py` checks each stage on a fresh gait instead. Make the stance flags robust at the boundaries. |
| B56 | ROS 2 plugin serial I/O | **OPEN** | `ros2/rocky_driver/src/rocky_system.cpp` takes servo ids from joint names and exports the xacro's interfaces, but is a skeleton: open / soft-enable, SYNC_READ and SYNC_WRITE are TODOs (the Python bridge node is the working path). |
| B57 | `gait_node` body lean / roll / pitch / yaw | **OPEN** | `BodyPoseCommand` applies `height_m` only; lean, roll, pitch and yaw are reserved fields, not applied yet. |
| B58 | `hw_bridge_node` claw state | **OPEN** | `ros2/rocky_driver/scripts/hw_bridge_node.py` sends claw commands and publishes real fault bits, but reports the five claw positions as zeros (a TODO): read the SCS0009 positions back. |
| B59 | `where_am_i`: bound place vs best candidate | **OPEN** (a decision) | On an ambiguous verdict the answer's `place_id` / name is the place the memory is bound to, while `confidence` belongs to the best candidate: they can name different places. |
| B60 | `SimBackend` on the Playground loop | **OPEN** | The harness's in-process sim backend still runs its own loop. Plan: wrap a headless `CockpitSim` running `run_forever` in a thread at speed 8 and delegate each tool to its `tool_*`; the viewer needs a sync hook. Touches the MCP, local-brain and intent paths and their tests. |
| B61 | Two private foot-contact copies | **OPEN** | `sim_lidar.py` and `run_push_reflex_v2.py` still sum self-contacts instead of `sim/scenes.foot_contacts`; changing them moves the lidar fixture and historical numbers, so do it with a rerun. |
| B65 | A non-editable install | **OPEN** | `rocky_model` reads `../cad/params.yaml` and `pebble_feasibility` `../sim/mass_budget.json`, so only `pip install -e .` works (documented in `pyproject.toml`). Package the data or pass the paths. |
| B67 | The tray's bus trunk: route and length | **OPEN** (the length) | Built in D064 (B51, B122): the bulkhead faces north (outer face y 35.0), the trunk and the tray XT30 run 11.25 mm over the deck to the (0, 50) slot and drop to the hub shelf, where `part_busboard` models the bundle (Ø9.42) round the plate's NW notch to the bus adapter's west plug side (0.25 to the node). No cut length is computed from it; the proposal's option A figures (trunk 129 mm, tray XT30 143, 14 AWG 159; [the proposal](archive/BODY_LAYOUT_PROPOSAL_2026-09-28.md) §6) predate the built shelf (the 14 AWG is 145 mm from the tub's exit, B133). Measure on the printed parts ([WIRING_HARNESS](WIRING_HARNESS.md#cut-lengths)). |
| B68 | Evaluations not rerun on the current model | **RERUN PENDING** | The 2026-09-26 rerun did not repeat `recover5_v3_warm`'s servo-nominal, randomised and pure-RL cells (still labelled `5a32f772ca99` in RL_GUIDE §4) or the `robust_fwd2` / `cmd_sample3` walker evaluations (pre-D052 walkers with no envelope, zeroed in the cockpit). Rerun them with `eval_recover` / `eval_ppo`, or retire the checkpoints. |
| B75 | Allowables from your own printer | **COUPON** | `params.fem.petg` holds datasheet-derived allowables with a knock-down (35 MPa von Mises, 20 MPa across layers, VERIFY). Pull one dog-bone printed flat and one printed standing, same settings as the leg parts, and file the two breaking stresses; every SF in `cad/out/fem/FEM_REPORT.md` scales with them. |
| B76 | Fluid motion on position servos | **PARTLY SHIPPED (D063: fixes 1, 2, 3, 8; 4–7, 9, 10 OPEN)** | The ranked fixes are in [SERVO_NOTES.md](SERVO_NOTES.md#fluid-motion-what-limits-it). Shipped in D063, measured in the sim and on the mock servo: **(1)** a command slew (`pebble_gait.CommandSlew`: 25 mm/s² on the fastest foot, then a 0.2 s lag) in the supervisor's normal and recover states, the playground, the harness sim and `gait_node`: a start moves a joint 3.38° per 20 ms tick (was up to 28.4°), standing → 34.2 mm/s takes 2.36 s, a stop still lands in the same tick; the gait RL env slews too since B34 (`cmd_slew`), no walker retrained on it yet. **(2)** A soft-landing swing (`pebble_gait.swing_profile`): the lift-off / touchdown velocity step 3.05 → 0.003 rad/s, and the checker's `KINK` verdict fails a step over 0.5. **(3)** A per-tick goal speed (`bus.goal_speeds`: 1.3 × the goal step, floor 50 counts/s, cap 3063): on the mock the servo moves 63–77 % of each tick instead of 21 %; the sag under load is B98. **(8)** A minimum-jerk keyframe ease (peak 1.875× the mean, so hand-timed moves need ~25 % more time). **The cost:** the soft swing lifts fastest 12 mm up, inside the 15 mm band held to the loaded 3.0 rad/s, so at `cycle_time` 2.0 the walking envelope fell 45.5 → 34.2 mm/s and the turn 0.246 → 0.185 rad/s (`run_sim` walk 247 → 189 mm); T 2.2 buys back 39.8 mm/s (B103). Open: (4) splined keyframes with per-joint offsets, (5) an idle layer, (6) 100 Hz, (7) runtime P/D, (9) ACC for gestures only, (10) a 12 V servo-model fit. 4 and 5 need no hardware. Found on the way: B101, B102. |
| B77 | The servo's sustained budget is a guess twice the datasheet | **OPEN** (bench) | `actuators.st3215.continuous_frac: 0.65` vs the C018 datasheet's rated 10 kg·cm (0.33 × stall); the 3.0 rad/s loaded speed budget (and so the walking envelope, 34.2 mm/s since D063) derives from it. The firmware's overload rule is 80 % for 2 s → 20 % output, not the model's 85 % for 180 s; the torque audit is at 12 V only (the knee push is ~62 % of stall at the 9.9 V floor if stall scales with voltage). Runbook §7 thermal soak + §8 torque step settle `continuous_frac`, the trip model and the voltage scaling; then re-derive `joints.vel_rad_s` and the envelope. |
| B78 | Feetech HL-series constant-current servo as a drop-in | **OPTION** | HL-3930 / HL-3950: same 45.2 × 24.7 × 35 body, 25T spline, bus and 9–12.6 V, plus a constant-current mode (soft holds, torque ceilings). Evidence is thin (one datasheet line, no HLS memory table, torque units undocumented), so buy ONE and bench it first. **Driver trap:** `bus.py` writes 0 to addr 44 in every goal block (goal time on STS); on an HL servo addr 44 is goal torque, so an HL needs its own register family before it goes on the bus. HL-3930's rated torque (8.7 kg·cm) is below the ST3215's; +15.5–19.5 g each. |
| B91 | The hand's leg lead: length and mating half | **OPEN** | The hand's 6 V exists only on XH-5 pin 3 at the deck cutout (WIRING_HARNESS, INTERFACES I1), so it runs the whole leg: coxa channel 132 mm (`part_coxa.harness_path` centreline) + yaw → hip ~90 + hip → knee ~125 (plug span 82–105 mm over the sweeps) + knee → hand ~110 on the shortest tube, about 0.45 m (0.55 m on a 120 mm tube). BOM B-17 is a 100 mm board-to-board cable (JST SH plug on both ends, Adafruit 6404): too short, and two plugs do not mate. Its red wire is the middle pin, against red = 12 V in the harness colours. On the 29 mm tube none of the tube is exposed for the lead or a `tube_clip` to follow. Decide the construction (where data and GND join: with the 6 V from XH-5 pins 1-2, or from the knee's spare port with its V+ pin pulled, D016; which SH header or wire-to-wire pair the hand carries), list the run in B-15 and the mating half in the BOM, and replace the estimate in WIRING_HARNESS in-leg routing with the length measured on the first leg. |
| B95 | The hand-as-foot overshoots l3 | **OPEN** (before cutting five tubes) | Knee axis → sole = tube + 136.2 mm with the hand (16.7 carrier + tube − 11 + 45.6 SEA at the slider's lowest pose + 81.9 stub face → cone tip + 3.0 pad; build123d), so `l3_tibia` 135 needs a −1.2 mm tube; the shortest tube (29 mm, none exposed) gives 165.2 (+30.2). The old rule's `HUB_H` + `CONE_LEN` was 12.5 mm short (the closed finger spans hub z 13.3–82.5, `part_hand.py:24-32`, `:188-196`) and its carrier term (`BOSS_H` + `SOCKET_DEPTH` = 40) is really 16.7; DESIGN_CHANGE_GUIDE §6 and §9 (CAD sync rules) carry the corrected stack (2026-09-28). Either raise l3 for the hand (params: gait, MJCF, URDF, feasibility), shorten the SEA / hand stack, or size B25's plain foot for 135 and treat the hand as a tool. Cut one tube first and log its length and the measured knee-to-sole in BUILD_LOG. The check itself is B36 step 8. |
| B96 | Pi 5 bring-up doc | **OPEN** (with B35) | Nothing in the repo takes the Pi from a blank microSD (B-04) to running the driver: the image (`ros2/README.md` implies Ubuntu 24.04 for Jazzy), flashing, headless Wi-Fi + SSH, the 5 A setting (EEPROM `PSU_MAX_CURRENT=5000` via `rpi-eeprom-config`, or `usb_max_current_enable=1` in `config.txt`; the B43 pin map), SPI enabled for the BNO085, `dialout` for `/dev/ttyACM0`, `pip install -e ".[hw]"`, and ROS 2 Jazzy. Only fragments exist today (`ros2/README.md`, `bench/BENCH_RUNBOOK.md` §0, `driver/README.md`), all written for a bench host. Write it as a section of `bench/BENCH_RUNBOOK.md` or a `docs/PI_SETUP.md` before B-03 is bought. |
| B97 | The belly in the sim and the feasibility checker | **MOSTLY SHIPPED (D064)** | The MJCF carries the belly, massless, from params (`rocky_model.belly_boxes()` / `belly_posts()`): the tub box x −97.5 … 99.9, y −47.4 … 7.4, z −55.4 … −18.0; the shelf plate box x −56.2 … 53.95, y 12.2 … 64.3, z −54.4 … −10; three Ø14 post columns; and the torso `<inertial>` from `sim/mass_budget.json`. `pebble_feasibility` reports a leg in the belly as `SELF_CONTACT` naming the box, so the gesture audit, the studio and keyframe saves refuse it unchanged (`sim/tests/test_belly.py`); the gesture audit has 0 self-contact samples. Leg 0 against the plate: its census fold (hip −65, knee −100) is clean, at hip −70 it enters by 9.1 mm. Still open: legs 1–4 still fold into the tub inside their soft limits (the 9p census), the live probes and the supervisor are not gated by the checker (B132), the tub's protrusions are not in the sim (B142), and every verdict assumes the 135 mm foot (B131). |
| B98 | Goal speed under load: the sag test | **OPEN** (bench, before the robot stands on it) | D063's per-tick goal speed (`driver/rocky_driver/bus.py` `goal_speeds`, `TRACK_K` 1.3, floor 50 counts/s) is set from how far the goal moves each tick, not from how far the servo still is from it. A servo that falls behind (under load, or at the cap) catches up only at the next ticks' speed, 50 counts/s once the target stops; firmware that replans each goal from the present position may let a loaded joint sag again every tick at slow speeds. The mock has no sag, so it cannot show this. Test one servo with a hanging load on a slow ramp, per-tick speed against speed 0, before trusting `TRACK_K` (VERIFY-ON-BENCH notes in `bus.py` and `sim/hw_bridge.py`). |
| B99 | The latch's 0.2 mm cam bite in PLA | **COUPON** (`frame_coupon` + one cartridge) | `iface.LATCH_BITE` 0.2 preloads the lugs at LOCKED. Hand calc (D063 panels review): the stack is ~860 N/mm, so the bite puts ~170 N through the lugs and ~108 MPa at their roots, against PLA's ~50 MPa yield: expect the first turn to set the lugs. The cam ceiling is a bridge printed on the underside; sag and 0.2 mm layers will turn its 0.8 mm ramp into steps. `LATCH_BITE` cannot drop alone: `LATCH_REACH` depends on it, and `latch_strike` asserts a frame ≥ `LATCH_REACH` + 0.2 (6.0 mm, the deck's thickness, B27); retune it with `LATCH_LAND`. Print `frame_coupon`, the demo and a cartridge, turn it, and try the I6 wedge (B83) on the same night. D064's tray strike is slotted along the slide (bite 2.63 mm³); its slot end (the 16.5 stop, on a 3 × 2 lug face), its 5.51 mm web to `sector_strike_2` and the housing's bearing on the two crescents beside the 6.6 slot at LOCKED are not stress-checked: try them the same night on a deck strike patch. |
| B101 | Stance feet scrub during a command ramp | **OPEN** | The gait has no memory: while D063's slew ramps a command, each tick places the planted feet for that tick's command, so they disagree by up to 20 mm/s (the ramp adds up to accel × T_stance / 2). The total slide is what an unslewed change did at once, spread over the ramp (D063 gait review). Not fixed. |
| B102 | Slow walking lifts less | **OPEN** | D063's lift fades in with the command (`pebble_gait.LIFT_FULL_MM_S` 15), so a zero command is exactly the standing pose (it used to march in place) and a slewed start does not pop the swing foot up. Below 15 mm/s the foot lifts less: 6 mm at 5 mm/s. A stub risk on rubble when walking slowly. |
| B103 | `cycle_time` 2.2: buy back walking speed | **MEASURED (2026-09-30), the owner's call; recommended: keep 2.0** | D063 kept the verified cadence (T 2.0 s). T 2.2 / h 26 gives 35.2 mm/s and T 2.4 / h 28 35.7 (the `params.yaml` gait comments). **Measured T 2.0 → T 2.2** (same 24 mm lift) on `87215110e9c4`, `cycle_time` set at run time (params still 2.0), both cadences on the same tree with D063's tools; the T 2.0 column reproduced every D063 number. **Envelope** 34.2 → 39.8 mm/s, 0.185 → 0.215 rad/s (+16 %; stride 55 → 70 mm; the lift ceiling still binds: coxa 60.9 → 55.3, tangential 44.8). **Kinematics** (`pebble_feasibility`): the walk / strafe demo passes at both, KINK 0.00; the steady gait at the envelope (24 headings and both turns) peaks 2.978 → 2.954 rad/s loaded and **2.96 → 3.44 free** (the swing yaw, 86 % of the 4.0 budget), CoM margin 41.4 → 37.0 mm. **Slew ramps against the loaded 3.0** (`check_ramp`; a 1440 grid of start, stop, reversal, 90° turn of heading and walk ↔ turn over 24 headings × 10 gait phases, 2400 finely phased at the grid's 4 worst, 280 retargets mid-ramp): 0 of 4120 fail at either, worst 2.992 → 2.972. **Gesture audit:** 19 rows, 0 FAIL at both; gait rows peak 2.91–2.98 → 3.38–3.44 rad/s, **tracking p95 12.9–14.8 → 15.5–17.5°** (warn 10, fail 20; `beckon`, not a gait, is 17.6 at both), RMS load 0.10–0.12 × stall at both; the gestures that are not gaits are identical. **`run_sim`:** walk 189 of ~198 → 221 of ~231 mm; turn 41.8° of ~40 → 38.6° of ~47, a phase artifact of its unslewed strafe → turn switch (over 8 start phases 33.7–42.0 → 38.5–49.7°; turning from standing 37.1–37.5 → 43.2–44.0°, +17 %). **Shove** (`shove_envelope`): standing 30 N min, 1.18 BW mean, at both; walking, shoved at its 5.0 s, 30 N in every direction → **20–35 N (min 0.75 BW)**; over 5 gait phases × 6 directions **min 25 → 20 N (0.93 → 0.75 BW)**, mean 30.2 → 30.8 N. **Cliff lip band** (D063's 364 approaches, whole degrees): **8 → 12 falls, 0 → 2 after a fired void guard** (25 @ 17°, 35 @ 20°: the void fired 0.56 s into the hold, then the robot tipped to ~27°); the band moved to 15 @ 10, 12; 25 @ 17–18; 35 @ 17–20, 60; 45 @ 2–4, so the five strict-xfail cases no longer fall. At T 2.0, `walk 35` and `walk 45` both clip to 34.2 mm/s, so each fall at those speeds is one run counted twice. **The same grid offset by 0.5°** (360 approaches, re-measured in review): **9 → 10 falls, 1 → 3 after a fire**. At T 2.0 too, 15 @ 15.5° fires 0.62 s into the hold and tips to 22°, so "no fall after a fire" held only on D063's whole-degree grid. **Both grids, 724 approaches: 17 → 22 falls, 1 → 5 after a fire**; the worst tilt after a fire that stopped safely is 5.3 → 6.4° (whole degrees) and 5.0 → 5.5° (offset). Walks at 15 mm/s from 47–48° up never reach the edge in the 20 s window at either cadence: not counted, as in D063. `recover1` system 20/20 at both (no righter 11/20 at both: a zero command, so T does not enter). Knee self-right 1.397 N·m since B106 (1.496 before; the audit had counted the hands twice): a static audit, independent of T. Derived: the ease-in 2.36 → 2.58 s, goto's cap 55 → 48 s (a 1.5 m goto ~46 → ~40 s), the scan turn 10.6 → 12.3°/s. **Recommendation: keep T 2.0.** Walking gets 16 % faster, but no safety number improves and three get worse: at the cliff, more falls after a fired void guard (1 → 5 of 724) and more falls overall (17 → 22); the lowest walking shove drops 25 → 20 N; the gait's tracking p95 rises to 2.5° from its fail line. Worth measuring again once the lip band has its own fix (B33 c). Adopting it is the params line, then a cliff-hold re-tune for the new band first, and re-pinning the envelope, `run_sim` and lip-band tests and the harness literals (`backend.SPEED`, `capabilities.GOTO_*`, TOOLS.md). **D064 (`deae868522cc`, the belly) at T 2.0:** CoM margin 41.4 → 38.5 mm; the 724-approach cliff grid 17 → 0 falls (16 tips onto the keel), 1 → 0 after a fire; walking over 5 phases min 25 N, 0.93 → 0.90 BW (mean 31.2 N). T 2.2 is not re-measured on it. |
| B109 | The leg drops meet the body under the deck | **OPEN** (the lengths) | Measured for the D063 proposal: the coxa plate covers the I1 cable cutout (leg x −29, body r 75.5–86.5). A loom arriving on the deck top meets 697 mm³ of plate; the column under the cutout is clear (0 mm³). So every leg drop is reached from under the deck, and WIRING_HARNESS's ring lane (r ≈ 62) cannot be on the deck top (the plates start at r 60.5). Built in D064: `part_busboard` runs the five Ø7 looms (7 conductors, 14.17 mm², 9p) from each drop in params' lanes (`hub_shelf.lanes`, 8 × 7, z −17 … −10, routes A / B / C) to the star board, 0 mm³ against hooks, bases, tub and node (tightest 1.20, leg 1 to the node); ties: B135. Still to do: the cut lengths (the proposal's 113 / 116 / 191 / 235 / 166 mm predate the built shelf) on the printed parts; the routes are written up in [WIRING_HARNESS](WIRING_HARNESS.md#leg-looms). |
| B118 | Stance load runs through the thumbscrews, not the hook | **OPEN (COUPON: insert pull-out + hand preload; the fix is B139)** | In stance the foot lifts the plate's outboard end (sim My +241.5 N·mm per leg); the plate pivots on its most inboard deck contact, so the hook carries 0. The two thumbscrews and their heat-set inserts carried 972 N per pair before the seats fix (3 legs × 3, μ 0.5 ESTIMATE; 660 without friction) on a 4.9 mm lever, 568 with it (built in D064). INTERFACES I1's "the thumbscrews only clamp" is false. **D064's FEM on the real support agrees** (`fem_check`: the inboard pads, the seat flanks and the screw heads in tension, each case holding what bears in it): in the stall push-up V the seats lift +0.04 … +0.36 mm and the pads and the two screws carry it, SF 1.10 (B139). Insert pull-out (ESTIMATE 400–900 N) and hand preload are still unmeasured. Go: ≥ 300 N per insert and ≥ 285 N preload; otherwise an outboard hold-down (B139). |
| B119 | The coxa plate is over-stressed at the screw line | **OPEN (not fixed at servo stall: B139)** | Section of the pre-D064 `coxa_yaw_base` at x −41 (two M3 holes): A 146.4 mm², I 195.2 mm⁴, 47.4 MPa at M 4629 N·mm (3 legs × 3 + foot friction), SF 0.74 against 35 MPa. The seats fix's spine rib (x −46 … −38, \|y\| ≤ 8, z 0 … 6, built in D064) takes the section to A 235.1 mm², I 1819 mm⁴, 15.0 MPa, SF 2.33 at that moment. But the servo-stall push-up (`fem_check` case V, 60.3 N at the foot) is 6994 N·mm at the screw line, and the FEM on the real support reads **SF 1.10** (30.4 MPa p99.9 at the vee socket's flank): the rib covers the 3 × 3 design case only. |
| B120 | The documented leg-plug sequence cannot pass the deck cutout | **PROPOSAL: a cross arm 7 × 16 r1 on the 11 × 11 cutout** | INTERFACES I1 / ASSEMBLY_GUIDE 2.9 mate the XT30 + XH-5 at the cutout with the plate hooked, then the mated pairs go down the cutout. The mated XH pair needs ≥ 13.63 rigid (end-on 14.60) in an 11 × 11: no motion passes it; an inline B5B-XH-A needs 11.65. The XT30 (either half or mated) passes at 0.40/side. The XHP-5 crimp housing alone passes long side first with the 5 leads folded in one layer in a set order (0.65/side at 26 AWG, 0.42 at 22; a two-layer stack fails at 22). Smallest fix: an arm 7.0 radial × 16 tangential, r 1, on the cutout: every half and both mated pairs pass at ≥ 0.41/side; 10.49 to other deck cuts, 7.69 to the pentagon edge, inside the ±10.5 drop keep-out. Without it: mate under the deck with the XHP-5 on the leg side, the single-layer fold written into the guide. The coxa channel is open below with the leg off the deck, so it is never threaded. Wire ODs ESTIMATE. |
| B121 | Leg-side XH-5 pins 1–2 carry two or three wires each | **OPEN (unverified, one agent)** | ASSEMBLY_GUIDE 2.7 steps 3, 5, 6 put the entry lead's data + GND, the hand's data + GND and the foot-switch return on pins 1–2. One SXH-001T-P0.6 contact takes one insulation Ø0.9–1.9, AWG 28–22; three 26 AWG wires are about 0.39 mm². A splice before the housing is needed and undocumented. Seven d1.3 leads still fold through 11 × 11 (+0.64/side); seven d1.6 do not. |
| B123 | The tray bulkhead has no connector for the foot-switch lines | **OPEN** (confirmed in D064's `part_avionics`) | The five J6 lines (star board XH-6 → Pi GPIO) cross the deck at (0, 50) and end on the tray. The rear bulkhead (`part_avionics`: XT30, XH-5, 2 × SH, Qwiic, USB-C) has nothing for them, so "one latch, one pull, everything out" tray removal is blocked. Add a bulkhead connector or move the lines into the trunk. D064: they pass the deck's (0, 50) slot (B122); `part_avionics` prints that the tray does not come out with them on. |
| B125 | A leg swap needs its carapace sector off, which needs a tool | **OPEN (design; the docs say so since D064)** | With its own sector on, the leg module meets the sector by 634–1011 mm³ along any dock path (all three I1 designs, both verifiers); the docked base already overlaps by 42.8 (B124). The I3 sector latch is turned with a flat screwdriver from under the deck, so "no tools, under two minutes" fails on an assembled robot. The four other sectors and the cap can stay on. ASSEMBLY_GUIDE 6.1 and INTERFACES I1 describe the swap with its own sector off (D064); a tool-free sector release is the open design. |
| B129 | The cliff guard sets a ceiling on any hip limit | **OPEN** | `playground.py` declares `probe_out` only when the measured foot is 26.5 deep (PROBE_MAX − PROBE_LEAD). At h 118 that needs the measured hip ≤ −47.91; it moves 0.9° per mm of body height (−49.74 at h 120). Any hip stop at −47.5 or higher: 0/12 voids, the robot walks off the table. With a driver clamp at −48 the reading clears the threshold by 0.11–0.18 mm. A hip limit or clamp in NORMAL must stay below the ceiling, or the probe depth must change (PROBE_MAX 28 → −46.14). The live probe is not gated by `pebble_feasibility`. D064's righter clamp acts only in FALLEN and at the RIGHTED ramp's start (NORMAL, BRACE and the probes keep −70, `gait/test_reflex_fallen.py`), so it stays clear of this ceiling. |
| B131 | Every leg-reach verdict assumes a 135 mm foot | **OPEN (with B95; unverified, one agent)** | With the hand as `part_hand` builds it on the shortest tube (sole 165.2 below the knee axis): at hip −51.05 legs 1–4 pass 17.5–18.7 through the tub, leg 0 is 6.3 into the shelf PDB, leg 1 7.5 into the adapter. Clearing needs ≥ −24 … −20 (legs 1/4), ≥ −32 (legs 2/3) for the tub and ≥ −40 for the shelf. The tub, the shelf and the clamp value depend on B95's outcome; `pebble_feasibility` and the limits must know which end effector is fitted. D064 built the clamp at −51.05 and the shelf as a plate box with post columns: with the 135 mm foot leg 0's zero-margin hip against the plate and pads is −62.5 (−57.55 against the first hull box), and a −62.5 floor clears the shove demo (B141). |
| B132 | The supervisor and playground ignore the params joint limits | **OPEN** | BRACE (hip to −58.6), the stance probe (−60.84) and the cliff probe (−51.58) command poses that are stopped only by the MJCF range in the sim or the driver clamp on hardware; neither clamps to `joints.pos_deg`. Any limit change in params does not reach them. |
| B135 | The loom lanes have no retention and a fixed turn | **PARTLY SHIPPED (D064)** | Built: the lanes are params (`hub_shelf.lanes`: 8 × 7, z −17 … −10, routes A / B / C; `part_busboard` models Ø7 looms in them) and every loom has a tie: legs 1 / 4 at the shelf posts (1.50 off), leg 0 at the deck's (12, 50) anchor, legs 2 / 3 at two tie bars on the lid beside the (±40, 0) bosses (lane A keeps 1.00 to the bosses; +2 × 3.6 mm ties). Leg 2's cross run is 0.16 from the tub's north return (0 mm³, tight). Still as 9p measured: the leg 2 / 3 lanes keep 1.45–1.75 to the docking-hook sweep and 0.60 to the Ø8 bosses, and the A → C jog must sit north of y −38 (south of it: 10.9 mm³ into the hook envelope, 4.2 into the coxa base; about 2 mm of slack). |
| B136 | Legs reach their own drop keep-out box even with the hip cut | **OPEN** | Sim capsules on a 2.5° grid: legs 2/3 enter their own drop box (the mated XT30 + XH-5 under the cutout) in 828 poses at −10.28 with hip ≥ −51.05 (3828 at about −20 uncut); contacts up to hip −42.5. Not counted by round 1's census. 176–198 of the lane-contact poses are covered only by it. Gate or model it. |
| B137 | The port coupon and fit-ladder row D cannot rehearse a dock | **COUPON (unblocked in D064): the first print** | `part_port_coupon` cuts the plate coupons to the real plate (x −46 … −11): four plates, `relief46` (the repo value), `relief42` (the designer's), `fit10` and `fit20` (the sockets 0.1 / 0.2 bigger radially: the seat-fit test, which also checks for light under the pads), each docking on `port_coupon_deck` at 0.000 mm³ with the pads bearing (`check_dock`). Fit-ladder row D is 5.8 / 6.2 / 6.6 at the slot's 24.6 length; the ladder has no seat row (the deck coupon's second post lands on the ladder at any angle). Print the deck patch and the four plates first, file the fit in `print.seat_fit` (0.0 now), then row D. |
| B139 | `coxa_yaw_base` fails at servo stall on the real I1 support | **OPEN (the owner decides, after a measured option round)** | `fem_check` with the docked support (D064: the inboard pads, the seat flanks and the thumbscrew heads in tension, each case holding only what bears in it): **SF 1.10 in V** (the foot pushed up at knee stall, 60.3 N; 6994 N·mm at the screw line), von Mises 30.4 MPa p99.9 at the vee socket's flank (−33.1, −16.1, −1.4), the cup deflecting 2.29 mm; R+ 5.75, R− 4.90, L+ 2.41, L− 2.40. The seats lift +0.04 … +0.36 mm, so the pads and the two screws carry it. For comparison 3.32 on the old whole-underside grip (2.93 recorded at D061), 1.59 with the seats pinned as well. B119's rib covers the 3 × 3 design moment (4629 N·mm) only. Options to measure, each with `check_dock` and the FEM re-run: an outboard hold-down, a deeper or wider rib past the sockets, a thicker plate, screw preload as a design load (B118). Until then print ONE `coxa_yaw_base` for the bench if wanted, not five. The model's limits: B148. |
| B140 | `run_cliff`'s control hangs on the tub | **OPEN** | On `deae868522cc` the no-guard control walks off the edge, tips 22.1° onto `belly_tub` at 8.78 s and hangs there (torso 239 mm), so the script's fall test (tilt > 50° or the torso under the platform − 0.02) never fires and the verdict reads CLIFF DETECTION INCONCLUSIVE (exit 0); with the belly's contacts off it falls at 9.04 s and passes. Give it the guard tests' tip criterion (tilt > 10° or a belly geom on the platform, `test_playground_guards._approach_falls`). Whether a real keel catches on a table edge or slides off (the sim's friction 0.8 at the corner) is unmeasured (B33 c). |
| B141 | Leg 0 touches the shelf plate in the shove demo | **OPEN (the owner's call: pick 13 named legs 1–4)** | `audit_righter`, `recover1`, 200 seeds on `deae868522cc`: leg 0 lies on the shelf plate in 2/200 falls, in FALLEN, at most 1.40 mm (hip −67.4°, knee −101.5°). A separate leg-0 hip floor of −62.5 (or −66) gives 0/200 with every outcome identical; leg 0 in `reflex.righter_clamp_legs` at −51.05 is unmeasured. `recover7` lies on it in 4/5 shove episodes (≤ 2.12 mm). |
| B142 | The tub's protrusions are not in the sim belly | **OPEN** | `belly_tub` is `iface.bay_tub_extent()`'s box; the latch boss and door ear (to y −64.45), the pilasters at (±70, −50.6), the keeper, the north return (to z −17) and the riser clip (x 55.5 … 62.8, y to 13.29) stand outside it (`iface.BAY_TUB_OUTSIDE`, checked against the STL by `check_sim_mirror`; the shelf's corner fillets pass the plate box by 0.60, gate 1.0). Model them if righting or rubble runs show contacts there, then re-run mass audit → MJCF → URDF → parity → fingerprint. |
| B143 | The tray comes out only with the carapace off | **OPEN (docs + design)** | With the carapace on, the slide south meets sector 2's latch pad from 14 mm (4.04 mm³) and its I3 cartridge at 16 (5.34), and the lift at 16 meets sector 3 from 10 mm (0.34), sector 4 by 14, the cap by 18 and sector 1 by 42 (`part_avionics`' reported row; the gated row is carapace off). With the robot off the stand and the sled out (the strike's column runs through it, B100), the order is: carapace off, unplug the bulkhead, latch to OPEN, slide 16 south (the slot stops it at 16.5), lift. D020's "tray out with one latch" holds only that way. Moving sector 2's pad out of the slide path, or a sideways exit with only sectors 2–4 and the cap off, is unmeasured. |
| B144 | The door latch is turned from +x with a long driver | **OPEN** | The door's I3 slot faces +x at x −85.7, so a flat driver (blade ≤ 5) is worked along the south wall: free for 260 mm on the stand (2.65 to the cradle's south wall, 0.55 under legs 2 / 3's drops), but it has to clear the carapace skirt at x 87.3, so the shaft must be ≥ 183 mm (200 recommended). A slot in the rotor's head (`iface.latch_insert_rotor`) would let it turn from the door side. |
| B145 | Pick 4 gave 2 mm, not ~10 | **OPEN (the owner)** | Printing the carrier into the nose saved 2.0 mm (`bay_l` 194 → 192, nose x 101.9 → 99.9), not the ~10 the proposal estimated: the mated XT60 pair is about 25 mm long and the carrier (22) only 4 shorter than `dock_block` (26). So pick 10's chamfer does not bring the nose inside the carapace skirt: its south corner goes r 110.57 → 106.67, still 7.76 outside. About 184 would need the female XT60 to stand out of the carrier into the sled's nose pocket, with the lead-in moved onto the sled (ESTIMATE, not built). |
| B146 | Retrain the righter on the D064 model | **DONE (2026-10-08): `recover8_d064`, 12 M steps, the `recover7` recipe; RL_GUIDE §4; shipped (`righter.default_ckpt`); the nominal-servo tilt and the back landings stay open under B34** | Every RL checkpoint is legacy on `965f4f70e5d1`: none has `hip_floor_deg`, so each replays the uncut action map and the supervisor clamps it. A new run (`recover6_d052`'s recipe) gets the hips of legs 1–4 over [−51.05, 90] (`train_ppo --hip-clamp params`, the default), drop poses clear of the belly (`RecoverEnv(drop_clear_of_belly=True)`, the default: the old stream started 15 of 400 seeds inside it, 3.75 %; `--belly-drops` keeps it for an A/B) and the torso inertial in the randomiser's bases; `--resume` refuses a changed hip map (`rl_common.action_map_mismatch`; `--hip-clamp none` continues a legacy run). Eval belly-contact counts should skip the drop fixture (t < 0.2 s). The bar: B34. |
| B147 | The lid-to-tub joint before the lid is on | **OPEN (not analysed)** | The tub hangs by its north wall's top return over the lid's edge and two M3 × 10 from below through the south pilasters; no north screw fits (the shelf, the hook envelopes and the drops leave room only at the wall's very ends). The open U's torsion before the lid is screwed on, and the return's hold in a fall, are not analysed. |
| B148 | What the FEM's I1 support leaves out | **OPEN (notes for B139)** | `fem_check`'s docked support is linear, with no screw preload, and a held node is pinned both ways: R+ pins the seats in every direction (mildly unconservative). The real joint has preload (unmeasured, B118), contact and friction. The option round should say which of these its verdict depends on. |
| B149 | The fuse holder's room in the tub's nose | **SPEC'D (VERIFY with the part)** | No fuse holder is modelled: the nose compartment leaves 16.30 mm over the XT60 carrier (13.85 over its stop window, x 76.5 … 79.5) and 16.90 each side of the loop key's body (x 83.9 … 97.5, y −28.10 … −11.90). Check the holder bought against it. |
| B150 | The XT60 mate's numbers | **SPEC'D (ESTIMATE)** | The tub's carrier assumes the male and female telescope 7.0 mm (`XT60_ENGAGE`), the sled's male glued 8.0 proud of its nose, the sled face 0.50 from the carrier's mouth, 6.0 of lead room behind the female, and an undrawn loop-key flange and screw holes. Caliper the mated pair, then file the door's 0.50 press boss. |
| B151 | The bus adapter's H2 header and connectors | **SPEC'D (VERIFY on the board)** | No Waveshare STEP or layout gives the adapter's connector positions; the shelf reserves 15 mm off both 33 mm ends at full height. Face-down, a straight Dupont on a vertical H2 header would hang to z −59.9, 4.5 under the tub's bottom and into the stand's crown plate: solder the three UART leads to H2, or use a right-angle housing inside the 11.0 parts envelope. |
| B152 | The 12 V PDB's height | **SPEC'D (VERIFY with the part)** | `NODE_LEADS` 6.0 over the 1.6 board is an ESTIMATE for the PDB's parts plus flat-soldered 14 / 16 AWG; leg 1's loom passes 1.20 over it and the tray bundle 0.25. A UBEC tie band runs on the plate under the PDB's footprint, 3.8 below its underside (33.70 mm³ into the board's envelope): fine unless the PDB has bottom-side parts or tails. A taller PDB needs lower node standoffs (`standoff_h` is shared with the star) or the routes re-run. |
| B153 | The bulkhead connectors' rear bodies | **SPEC'D (VERIFY with the parts)** | `part_avionics` cuts the tray bulkhead's openings but models no XT30 / XH-5 panel part behind them: the z 8 row (tray z 7.6 … 14.4) has 4.6 mm from the bulkhead's inner face to the Pi's board edge before it runs under the PCB. Check with the real parts, or lower that row. |
| B154 | The adapter's 2.5 mm spacers | **SPEC'D** | The bus adapter stands on four Ø5 × 2.5 spacers (ID ≥ 2.6) with M2.5 × 8; 2.5 may not be a stock length. Fallback: a DIN 934 M2.5 nut (2.0) + a DIN 125 washer (0.5). A 3.0 spacer would put the adapter 0.5 under the shelf's `bottom_z`, below what the stand margins were measured at. |
| B155 | The tray rails' north tab screws have nothing to bite | **SHIPPED (D064, 2026-10-08)** | `part_deck.DECK_HOLES` `tray_tab_±40_20` were Ø3.4 clearance holes (were 2.8 tapped grid holes), and since correction 10 no shelf hanger, lid boss or insert sits under them, so each rail's north tab (tab 2 + deck 6) had nothing to thread into. A nut under the deck (2.4 tall) would have left about 1.5 over the star board's envelope at (40, 20), 3.9 under the deck. **Done:** the tapped hole. The two are Ø2.8 thread-forming again (`m3_top`, `print.screw_m3_tap`), an ISO 7380 M3 × 10 through each tab, no nut; its tip comes out 2.0 under the deck, 1.90 over the star board at (40, 20) (`part_busboard` measures both tips against the loaded shelf and the tub, ≥ 1.0). BOM B-27 and [ASSEMBLY_GUIDE](ASSEMBLY_GUIDE.md) 4.3 say so; the 8.4 item is gone. |
| B156 | A height loop on FK, and the probe's HOLD re-arming to SEEK | **OPEN (D065: the classical rival to the terrain residual)** | The leveler takes out tilt, not a foot left hanging: D050's probe goes SEEK → HOLD and never seeks again in that stance (`sim/playground.py` `_probe_tick`), so a foot that steps off a stone stays unloaded while the others carry it. A height loop on FK of the measured joints (the body's height over the loaded-foot plane against `stance_torso_z_m`) and a HOLD → SEEK re-arm rule when a held foot's switch opens in stance would close it. D052a's re-seek on an opened switch was rejected for false voids on stairs, rough ground and ice, so the re-arm needs the terrain bench's P6 (no new false void) as its gate. The terrain residual (B160) must beat this to ship. |
| B157 | The probe, the gate and the void guard into `gait/` for the Pi | **OPEN (the B35 gap D065 exposed)** | The leveler holds still for the touchdown gate, the void phase, `probe_out` and a late seek (`Playground._level_holds`), but all four live in `sim/playground.py`; the Pi's loop would run the leveler (it is in `gait/`) without them. Move them behind an API on the supervisor (the gate already reads its private `_last_t`, SIM_GUIDE §8), then add terrain-bench rows with the supervisor called at 50 Hz (a `sup_decimate` option, not built), the rate the Pi runs it at; today the sim calls it at 500 Hz. The leveler's rough-ground sink cap (B162) depends on the probe too: it reads `probe_dz` through the supervisor, and with none (probe off, or a Pi loop before this item) it fails closed, capping the body's sink at `sink_max_mm` while walking (B162 review round; before it a missing probe read as smooth ground and the full 16.6 mm sink came back: 14.8 mm of belly clearance on 30 mm rubble). No Pi loop builds a supervisor yet (`ros2/rocky_gait/gait_node.py` runs WaveGait + `budget`); when one runs it, it passes `grav=None` (the leveler releases and stays at zero) until `calibration.yaml` has an `imu:` block (B159), and builds the leveler before the loop starts: an enabled `BodyLeveler` primes its derated envelope then (`prime()`, 2.8 s on the workstation, unmeasured on the Pi), since a ceiling computed in the 20 ms tick took 30–77 ms (review 9r). The leveler's tick is on a schedule (one law tick per call on a 50 Hz loop with jitter: 350 of 350 at σ 0.3 ms, where the first rule ticked 62 % of them). |
| B158 | B129's hip ceiling against `probe_out`'s depth | **OPEN** | By IK at the nominal stance (h 118, leg 0) the hip reads −47.89° at 22.2 mm of lowering and −51.0° at 26.5 mm; B129's −47.91° is the hip at which a foot whose knee still follows the 30 mm probe target reads 26.5 mm deep. Which of the two a hip clamp in NORMAL would bind, and whether a seeking foot can reach `probe_out`'s 26.5 mm at the leveled poses (feet raised 0–30 mm, the body down by up to 17.1 mm on the slope stands), is not measured. Reconcile them before any hip clamp outside FALLEN. |
| B159 | IMU calibration before the leveler runs on hardware | **OPEN (blocks `level on` on the robot)** | The leveler levels the body to the sensor: with a 1.5° mount error (`SimIMU(mount_deg=1.5)`) the flat stand ends 1.045° off true and the flat walk's tilt RMS goes 0.33 → 1.31° at D065's 0.2 s filter (`sim/out/terrain_bench_d065_off.json`, mount1.5; the 20 mm stone 1.34 / 1.78° under foot 0 / 3, the 5° slope 1.46–1.87°); at B162's 1.0 s filter (`sim/out/terrain_bench.json`) the stand ends 1.34° off, the flat walks 1.40° (rows 1.43 / 1.50 / 1.27), the 20 mm stone 1.31 / 1.38°, the 5° slope 1.00–1.43°, and 30 mm held-out rubble's belly clearance falls to 20.6 mm. Build `bench/calibrate_imu.py`: two planted readings 180° apart in yaw on a level surface give the mount trim (half the difference), written as `imu:` in `calibration.yaml`. The rule for the Pi loop (B157, not built): until that block is there it passes `grav=None`, and the leveler releases to zero. |
| B160 | The terrain residual, and one switch filter for the probe and RL | **PLANNED (RL_GUIDE §5)** | A `contact_filter` so the probe and an RL observation see the same noisy switches; then a residual on foot z through the leveler's composer: modal (k0 common, k1 / k2 the tilt modes), inside the 0–30 mm raise-only window, seed tiers from `terrain_bench` (bench 0–4, held out 100–199, train ≥ 1000), a 1 M-step go / no-go, shipped only on a paired bootstrap over the terrain bench against S2 at τ 0.3 / 0.6 / 1.2 s and against B156. The bench's S3 column is reserved for it. |
| B161 | The shipped stack's false voids: ground deeper than the probe reaches, on worlds with no drop | **OPEN (found by the D065 bench; not the leveler's)** | `W6.stairs20.walk.p2`, S1, ideal IMU: the void guard fires at 5.74 s with ground 4.3 mm under the void foot, 35.1 mm under its un-probed target (6.7 / 37.7 under mount1.5), and the robot stops 51 mm in; S2 is bit-identical up to the fire. Under the noisy IMU S1 walks it (440 mm) and S2 false-voids (11.8 mm under the foot, 42.8 under the target, the void foot raised 0.3 mm by the leveler; 51 mm in): the probe's timing decides it. S1's other two phases tip to 10.2° and 12.4°. On rubble: S1 `W4.rubble20.s0` noisy (9.5 / 37.8 mm) and, since the review round, S2 `W4.rubble30.s1` noisy (2.9 / 38.3 mm, the void foot raised 0.1 mm). Every one has the ground 35–43 mm under the un-probed target: a step down deeper than `PROBE_MAX` (30) on a world with no cliff, so by the probe's own rule a void. B162 classes them `probe_reach` (reported, not gated). In wip 1's record S2 walked noisy `stairs20.p2` to 508 mm and tipped; in the review round's (`sim/out/terrain_bench.json`) it stops there at 203 mm on a `probe_reach` void with no ground found under the foot (P4's 46.5 %), and on the held-out rubble seeds S2 adds four S1 did not have (`W4.rubble20.s100` noisy, `s101` both modes, `W4.rubble30.s104` noisy; ground 33–46 mm under the target), S1 has its own (`W4.rubble20.s0` noisy, `s100` ideal, `s106` both, `W4.rubble30.s105` ideal, where it stops at 51.7 mm). Decide what a 35–43 mm step down should be (a void, or a deeper seek where the body is low over the loaded feet), then find what the probe reads on the stair's riser. |
| B162 | Flipping `level.enabled`: what failed and the next round | **OPEN (the D065 verdict: fail; after wip 1, 10-09: fail on R1 alone; after its review round, 10-09: fail on the stairs, P4 and P7; `level.enabled` stays false)** | The bench failed five rules (decisions D065; the record after the review fixes, `sim/out/terrain_bench.json`). (a) **P1:** OBS_NOISE drifts the plane on a straight flat walk (max offset 1.19 / 1.68 / 1.38 mm against 0.5; tilt RMS +0.016…+0.037°, progress −0.3 %), and the review's flat-motion rows fail in the ideal IMU too: a turn in place leaves 0.47 mm, a rim shove 0.92 / 0.36 mm, and a walk + turn's stop 11.65 mm (the leveler cancelling the probe's HOLD, B163), none bit-identical to S1 because the transient passes the deadband and the deadband never unwinds the plane. A scratch probe on `e174f22` with `level.filter_s` 1.0 read 0.00 mm on the three noisy flat walks and the flat stand and kept P2 / P3 (the 20 mm stone 0.23° noisy / 0.425 ideal, 5° 0.21 / 0.19, 8° 3.21), at a slower settle (the stone's tilt RMS 0.37 → 0.88°): re-bench it, the flat-motion rows included. (b) **P7:** raising only sinks the body (13.4–16.6 mm on a full window by the slope's heading; the slope stands' height error −14.3 to −17.1 mm), so on rubble the belly came within 23.5 mm (`W4.rubble20.s1`, ideal) and 24.2 mm (`W4.rubble30.s3`, noisy) against 25 (S1 ≥ 31.3), and the stairs clear it by 0.3–1.3 mm (25.3 noisy, 26.3 ideal): a window that knows the belly clearance (cap the sink on rough ground) is unmeasured. (c) **P4:** the derate alone puts a saturated plane under the line: 32.48 / 34.20 mm/s = 94.97 % (94.86 % for a slope along y), so the rule as written cannot pass a saturated slope row before creep is counted. MuJoCo's stance creep (SIM_GUIDE §8) then skews W2: S1 walks 689–691 / 544–545 mm down / up a 5° slope and 766–769 / 449–450 on 10°, 618–620 on flat; per row (ideal and noisy) S2 is 91.6–92.3 % downhill, 99.3–102.7 % uphill, 94.2–95.8 % across (the phase-1 across rows, 94.2 at 5° and 94.4–94.5 at 10°, miss). Five rubble rows miss 95 % in some gated mode while the family is 100.6 % (ideal) and 100.9 % (noisy); rubble rows are chaotic (S2 per row 59.6–149.2 % of S1, and S1 itself 341–398 mm across IMU modes on one seed). Judge W2 against S1 × the derate ratio, by its up + down mean or against flat, and rubble by the family, if the owner agrees. (d) **P6 and R1, noisy:** B161 (two false voids, the stairs and `W4.rubble30.s1`, whose stop is R1's +0.42°). **wip 1 (BUILD_LOG 9s, D065's amendment; the first record kept as `sim/out/terrain_bench_d065_off.json`):** (a) `filter_s` 1.0: every noisy flat row 0.00 mm (0.6 left 0.33, 0.8 0.03), +0.4 s to settle a stone, +0.16–0.32 s a slope stand, an underdamped loop (0.24–0.28° past level on a 3° kinematic plant, inside the deadband), more tilt on rough ground; the turn and the shoves stay inside the deadband now, the walk + turn's 14.71 mm is B163's. (b) a walking-gated sink cap on the probe's roughness (r0 12 mm, 6 mm): rubble clearance 25.3 / 25.8 mm, stairs 26.2 / 25.2 (thin), slopes and stones bit-identical to no cap; costs the 10° ramp (3.62 → 4.13°) and the stairs (2.08 → 2.49°), one noisy stairs tip (S1 tips it too). (c) P4 judged against S1 × the row's derate, rubble by family, stairs per row with the trade reported; (d) P6's `probe_reach` voids reported, not gated; P1's flat-motion rows gated on tilt and the walk's progress at `stop`. Left: **R1 on two ideal rubble rows** (`W4.rubble10.s0` 0.84 → 1.02°, the slower filter's; `W4.rubble20.s3` 2.12 → 2.25°, the cap's; the family 2.20 → 1.73°). Next: the owner's word on R1 per row on chaotic rubble seeds (P4 is judged by family for the same reason; this round left R1 unchanged), or a filter that lags less on rubble while it holds the noisy flat rows at zero; the ramp's kinks read as rough (a twist / plane-residual signal would tell them from rubble, unmeasured); the thin stairs and rubble clearance margins (0.2–1.2 mm). **wip 2, the review round (BUILD_LOG 9t, D065's second amendment):** a reviewer found wip 1's P7 in-sample (held-out rubble 100–111: 21.7 mm, 3 of 12 rows under 25), the cap failing open without a probe, its stairs cost under-reported and its rubble gain half gone out of sample. Done: the cap fails closed (walking blind it caps at `sink_max_mm`); it latches (`rough_off_mm`, ≤ 2 engages per row, was up to 20); it was re-picked on train seeds ≥ 1000 (12 candidates; `rough_r0_mm` 8, `sink_max_mm` 3, `rough_off_mm` 4, `rough_hold_s` 4: worst-case clearance 26.6 mm over train rubble and stairs) and checked once on held-out seeds (25.1 / 25.7 mm, none under 25); the bench now carries 12 held-out rubble seeds per height (`heldout_rows`, `--heldout`), judges P4's rubble per height and R1's rubble by family (S1 against S1 with only the IMU noise stream changed moves 23 of 51 rubble rows past 0.1°); stands are signed (the 20 mm stone overshoots 0.72°, 0.96 noisy). Held-out rubble tilt RMS: S1 2.07 / 1.97, D065's S2 1.60 / 1.57, wip 1 1.82 / 1.70, wip 2 1.90 / 1.75. **Verdict: fail** on the stairs: P4 (`W6.stairs15.p1` ideal 92.2 %; `W6.stairs20.p2` noisy 46.5 %, a `probe_reach` stop, B161) and P7 (`W6.stairs20.p1` noisy 24.4 mm). Stairs at the same filter, tilt RMS / tips / min clearance (ideal; noisy): S1 4.72 / 2 / 45.1; 5.83 / 3 / 45.5 — no cap 2.08 / 0 / 27.0; 2.48 / 0 / **23.0** — wip 1's cap 2.49 / 0 / 26.2; 3.05 / 1 / 25.2 — wip 2's 3.77 / 2 / 28.0; 4.16 / 1 / **24.4**. **What it would take:** (a) a roughness signal that tells rubble from stairs and ramps (the residual of a plane through the loaded feet's ground points, or the probe's history along the walk): unmeasured; (b) levelling without the sink on rough ground, i.e. lowering the low side's feet, which spends the probe's 30 mm of reach and moves the void verdict (a design change against D065's raise-only rule, with B158's hip ceiling); or (c) the owner's word on P7's 25 mm line on stairs, where the body is level over a rising step rather than sunk onto a stone. Then, before any flip: regenerate the level-on lip grid (`sim/experiments/run_lip_grid.py --level`; its record carries D065's parameters; the review's re-run at wip 1's found no outcome change), update the default-off asserts (`gait/test_level.py` `test_level_defaults_come_from_params_with_their_types`, `sim/tests/test_playground_guards.py` `test_level_is_off_by_default_and_a_flat_walk_never_levels`), run the brain, place and vision benches with it on (they build a Playground and none has run levelled), and fix or accept B163's mirror block after a turning stop. |
| B163 | A turning walk's stop leaves the shipped stack tilted on flat ground | **OPEN (found by the D065 review; S1's, not the leveler's)** | `W1.flat.walkturn` (walk 45 mm/s with wz 0.2 for 8 s, `stop`, 3 s), S1, ideal IMU: after the stop's BRACE / RECOVER the body ends at 2.44° with leg 4's probe HOLDing 15.0 mm down and feet 0 and 3 off their switches (the same in a copy of main, `6044c5e`, before D065). D050's HOLD never re-seeks (B156), so nothing undoes it. With the leveler on (S2) the plane raises feet up to 11.65 mm against the probe's push and the body ends at 0.75°, feet 0 and 3 still unloaded, and the offsets keep `level_held_reason` from letting sim → robot start until `level off` (14.71 mm at B162's 1.0 s filter; a flip cost, listed in D065: with the leveler on by default every turning stop would block the mirror until `level off`). The deadband never unwinds a plane it integrated during a transient, so P1's flat rows include this one. Fix the residue at the probe (B156's re-arm, or release a HOLD on a stop), not by leaking the leveler's plane: a leak inside the deadband would walk a levelled slope's residual out to the deadband's edge. |

## Closed

| # | idea | verdict | where |
|---|---|---|---|
| B138 | `pebble_feasibility` and `mass_budget` miss the belly's mass | **SHIPPED (D064)** | `sim/mass_audit.py` weighs every torso item from its STL in a body-frame pose table: `sim/mass_budget.json` holds the torso at 1555.0 g, CoM (−2.21, −4.63, −3.18) mm, with its full inertia, not provisional; `build_mjcf` writes it as the torso `<inertial>`, `pebble_feasibility` reads `M_TORSO` / `TORSO_COM` from it (a WARNING fallback to the old literals), and RecoverEnv's randomiser bases carry it (read back after reset). The CoM margin at the envelope 41.4 → 38.5 mm. `cad/check_sim_mirror.py` checks the pose table's copies of part geometry against the part modules (review 9q). |
| B134 | The hub on the stand: thin margins, no service | **SHIPPED (D064): margins measured; hub service is off the stand** | The cradle's crown plate is lowered 3 mm outside its floor: the shelf's boards keep 4.00 to it (3.00 at +1.0 of either plate). The cradle walls stop every roll before the shelf meets the crown: 1.25° in place, 2.37° slid by the x-stop pin's 0.45 of play, 2.49° with no pin, against 6.06° north and 2.04° south for the shelf; the nearest stand margin is the north wall, 1.30 (0.85 slid, 0.77 after a knock). 3 of the bus adapter's 4 screws are still blocked from below on the stand, so the hub is serviced with the robot off it. `part_busboard` and `part_stand` check the real shelf against the real crown. |
| B133 | The 14 AWG feed from the tub nose has no route at bay_w 53 | **SHIPPED (D064, at bay_w 50)** | Pick 8 (b) keeps bay_w 50, where a route exists. As built (`part_bay`, `part_busboard.awg_route`): out of a Ø5.5 exit through the middle of the tub's NE nose chamfer (centre (94.90, 2.40, −50.50), 1.2 of wall round it), west under leg 4's drop at z −52.7, up a riser snapped into a clip on the tub's north wall at (59.15, 10.3), west at z −23.7 to the 12 V node: 145 mm, 0.20 to the floor of leg 4's drop + 5 box, 5.34 to drops + 0, 0.40 off the north wall. It spans 26.5 mm unsupported under the drop (the 5.4 mm window has no room for a tie); a real bend of about R 8 may come within 0–0.3 of the drop + 5 floor (ESTIMATE); the clip's snap (1.0 jaws, 1.8 % strain) is VERIFY on a print. |
| B130 | The righter folds legs under the keel | **SHIPPED (D064, pick 13)** | `ReflexSupervisor` clamps the hip of legs 1–4 at −51.05 in FALLEN, and the RIGHTED ramp starts from the clamped pose (params `reflex.righter_hip_min_deg`, `righter_clamp_legs` [1, 2, 3, 4], the one copy); NORMAL, BRACE and the probes keep −70 (B129). RecoverEnv maps those hips over [−51.05, 90] for new runs (`hip_floor_deg` in the contract); the checkpoints on disk replay their uncut map and the supervisor clamps it. Measured on `deae868522cc`, 200 seeds: system 198/200 (197 before), the clamp clips 41.3 % of FALLEN ticks, every drop-eval belly contact is in NORMAL at t ≤ 0.18 s (the drop fixture, the same with no righter); the shove demo: no tub contact, leg 0 on the shelf plate in 2/200 (B141). The value still assumes the 135 mm foot (B131). |
| B128 | One usable USB-A port for four loads | **SHIPPED (D064, pick 14): the bus adapter on UART** | The adapter sits face-down on the hub shelf and talks over its H2 UART: H2 RXD → Pi pin 10, TXD → pin 8 (crossed), GND from pin 9 or 14 (pin 6 is the buck's), jumper H4 to A, its logic powered only from its 12 V input in UART mode; `SerialTransport` needs only the port path. The one usable USB-A, the lower middle port (USB end +x, Pi on 11 mm), takes the D500 lidar's adapter: a right-angle plug ≤ 20 long from the port face, overmold ≤ 14 × 7, cable down or south (21.59 mm of room at the worst float, gate 20). The optional mic (D-02) and Wi-Fi (X-04) still have no port. |
| B127 | The Pi's part height is missing from the carapace check | **SHIPPED (D064)** | `cad/ref/rpi5_envelope.json`: 33 boxes in 13 groups from the official Pi 5 STEP (MIT, `cad/ref/LICENSE-MIT-RaspberryPi.txt`; the 77.6 MB STEP is not committed, the JSON regenerates from it exactly). `part_avionics` gates the 3D gap to the carapace with the tray's ±0.3 float: USB end +x 6.82 centred, 6.54–7.10 (gate 3.0); −x, record only, 3.31 (2.99–3.65). The Active Cooler, HATs and the GPIO Dupont housings (ESTIMATE, 10.52 to the carapace) are unmodelled. |
| B126 | Two more under-deck turn points sit inside the tub's plan | **SHIPPED (D064), with B100** | The tub carries a driver column for each (B100). |
| B124 | Each docked coxa base meets its carapace sector | **SHIPPED (review 9q)** | `part_shell.cup_back_relief()`: a box over the yaw cup's back wall (body x 71.2 … 73, \|y\| ≤ 9.8, z −0.3 … 45.5) relieves each sector: 42.80 → 0.00 mm³ at all five stations, the sector 0.30 off the docked base and 2.8 off the yaw servo, −69.3 mm³ a sector. `part_shell.keepouts()` now poses the real `coxa_yaw_base` and yaw servo at the stations, gated at 1e-6 mm³ (the unrelieved sector fails it). The reviewer's local choice; moving the arch to x 71.2 (it would also cut the latch pad and the feet) or trimming the cup wall's top (a leg part, FEM-checked) stay the owner's alternatives. The 0.2 g it removed moved the fingerprint `deae868522cc` → `c3e82f13b671`. |
| B122 | The Ø10 deck grommet at (0, 50) passes no plug | **SHIPPED (D064, deck v0.5)** | The grommet is a 12.5 (E–W) × 7.5 r 1 slot (`part_deck.DECK_HOLES` `trunk_slot`, 92.89 mm² open, 4.05 to the nearest hole) with zip anchors at (±12, 50): the XT30 passes at 1.15 a side, an XHP-5 with 22 AWG two-layer at 0.36. The bulkhead cannot sit over it (its outer face is 11.25 south of the slot), so the mated plugs' leads run north over the deck and drop; under the deck the bundle goes round the shelf plate's NW notch (`part_busboard`, 0.25 to the node), not straight down through the PDB's halo (787.2 mm³). The J6 lines pass it too; their bulkhead connector is B123. |
| B117 | The I1 leg port cannot dock or undock | **SHIPPED (D064, decision 15): the seats fix; COUPON first** | Ported into `part_coxa`, `iface` and `part_deck`: two 30° cone posts at (−32, ±17.3) (`seat_xy`, was `dowel_xy`), a cone and a V socket, slot 6.2 at x −50.1 … −43.9 (`hook_slot_x` −47, `hook_slot_w` 6.2), the spine rib (B119), the 0.2 relief outboard of x −46; the dowels are gone (D020's I1 revised 2026-10-07). `cad/check_dock.py`, a CI module, proves it on the real solids: docked 0.0000 mm³ with the pads bearing and the cones at zero play; four stored hand paths walked in 145 sections at 0.305 (HAND) … 0.469 mm (WIDE) and replayed in 3D at 0 mm³ (0.30 at the lip ends); the hook sweeps z −13.30 on the paths and −13.76 at any free pose (`iface.HOOK_ENVELOPE`, r 56.88–66.61); a 4.2 slot fails it. A second agent re-measured every grade. The coupons (B137) are the first print; `print.seat_fit` takes their result. The plate's stall case: B139. |
| B108 | Tray boards with no envelope | **SHIPPED (D064, pick 14)** | The three boards sit face-down on the hub shelf (`part_busboard`), not on the tray: the bus adapter at (−20.2, 28.8) on four 2.5 mm spacers with M2.5 × 8 (B154), the 5 V buck at (35.8, 26.2) turned 90°, the 6 V UBEC at (−1.8, 55.8), the last two zip-tied; pairwise 1.85–3.00 mm, 0 mm³ to the deck, tub, posts, hooks and drops. The tray carries the Pi on 11 mm standoffs and the IMU only; `part_avionics.BOARDS` keeps the envelopes (holes 37 × 28, the buck's capacitor `cap_l` 10 ESTIMATE) for the shelf to import. VERIFY with the parts bought: the buck's 1000 µF can, the adapter's H2 (B151). |
| B100 | One carapace latch sits over the battery bay | **SHIPPED (D064), with B126** | The tub leaves a Ø6 driver column through floor and lid at each of the three under-deck turn points inside its plan: carapace latches 162 (−73.48, −12.30) and 306 (66.67, −33.24) and the tray strike (0, −43) (a notch in the south wall's inner face, 1.40 of wall left). With the sled OUT a Ø5 driver from z −60 to −10 meets 0 mm³ at all three (0.50 radial to tub and lid); with it in, the sled and pack block them. On the stand, 162 and 306 turn once the sled is out; the tray strike's column is closed by the cradle floor and crown plate (117.81 / 61.62 mm³), so the tray latch is turned off the stand. |
| B93 | Sled strap slots take only ~5 mm straps | **SHIPPED (D064, pick 8 b): no strap** | No strap inside the robot: `bay_w` stays 50 (the sled's 48.8 keeps 0.60 a side), a 2 mm foam pad over the pack (stack 2.10 + 3.0 + 25.0 + 2.0 = 32.10 of bay_h 33), the door's boss presses the sled's tail lip by 0.50, and the sled's strap slots are gone (`part_battery`). |
| B92 | The 12 V power node: no BOM part, no mount | **SHIPPED (D064, pick 9)** | A 30.5 × 30.5 FPV-style PDB, face-up on the hub shelf at (−20.8, 36.2) on 5 mm printed standoffs (M3 × 6 thread-forming), fed by the 14 AWG from the tub's nose (B133); the deck's (52, −6) grommet is gone. Its part height is VERIFY (B152). |
| B86 | `dock_block` cannot be bolted down | **SHIPPED (D064, pick 4): retired** | No `dock_block`: the female XT60's carrier is printed into the tub's nose wall on four 14 × 1.2 × 1.2 flexure webs inside a stop window (0 mm³ at ±0.8 float in y and z, the stop at ±0.85; 23.4 MPa at the stop against 35, gated), its pocket at dz 0.000 / dy 0.000 against the sled's male. The mate's own numbers are ESTIMATE (B150). |
| B85 | The stand crown fills the belly | **SHIPPED (D064, pick 1)** | `part_stand.stand_crown` is a U-cradle that holds the robot by its tub: a 6 mm floor at x ±45 under the tub bottom, two 25 mm walls 0.5 off the tub's sides (2 mm lead-ins; the south wall x ±40.5 to clear legs 2 / 3's drops), a Ø5.4 pin into the tub's Ø6.3 × 1.5 hole at (0, −20) (0.45 of play), the crown plate lowered 3 mm outside the floor (B134). 0 mm³ against everything but the tub (nearest 0.516, the drops + 5), carapace on (29.8 clear), deck-bottom heights 89.4 / 169.4 / 249.4 (the old crown had no seat and sat 3 mm low: its 47 / 127 / 207 were 44 / 124 / 204); checked against the real tub and shelf. The robot goes in one way (door end −x); print the stand after `part_bay`. |
| B84 | The battery bay is not a part | **SHIPPED (D064, picks 1–8, 10, 12)** | `cad/part_bay.py`, PETG: `bay_tub` (76.8 g: an open-top U, the sled rails printed into its floor, the nose chamfered 10, the XT60 carrier (B86) and the loop key's XT60 pocket in the nose, the driver columns (B100), the stand's x-stop hole, the 14 AWG exit and riser clip (B133)), `bay_lid` (24.4 g: six hanger bosses on deck holes, two pilaster inserts, the leg 2 / 3 loom tie bars) and `bay_door` (6.7 g: a spigot, a 0.50 press boss on the sled's tail lip, one I3 latch in a south-wall boss at x −91.5 … −85.5, a north snap hook tab). Interior 192 × 50 × 33 (`bay_l` 194 → 192: the nose came in 2.0, not ~10, B145), hung 8 mm under the deck (roof z −18); the tub slides south under the lid's north return and takes two M3 × 10 from below. 0 mm³ against the hooks (closest 3.22), the drops + 0 (3.46), the bases, the deck, the carapace, the cradle and the stance legs; the sled, pack and male XT60 slide out at 0 mm³, on the stand too with leg 1 at yaw ≤ +20 (at +30 / +40 it meets the sled 130 / 110 mm out). Open: B142, B144, B145, B147, B149, B150. History: [the proposal](archive/BODY_LAYOUT_PROPOSAL_2026-09-28.md), BUILD_LOG 9l / 9p. |
| B66 | The I5 dock's spare taps sit ahead of the main fuse | **SHIPPED (D064): no tap ahead of the fuse** | `dock_block` and its bus-bar cavity are retired (B86): the pack's only way out is the nose's XT60, the fuse (B149) and the loop key, then the 14 AWG to the 12 V node, so any spare tap is a pad pair on the node, after both. |
| B51 | I4 tray position | **SHIPPED (D064, picks 7, 11, 14)** | Built at (0, 0) turned 180° (params `avionics_tray`): rails at x ±47.3, six tabs inboard on the deck's (±40, −20 / 0 / 20) holes (0.00 off; ISO 7380 button heads), three 10 mm lugs a side under windowed lips (slide 16 south, then lift), the tongue-end corners cut square to stations 234 / 306 (`corner_cuts`, 0.87 to bases 2 / 3 at slide 16), the Pi + IMU only (B108). Two cross-part fixes: the tongue stood over the strike, so a glued `tray_latch_boss` (5.1 = `TRAY_Z`, wall 1.6) puts the latch's seat on the deck top; the round strike pinned the slide (2.20 mm³ at 0.5), so `iface.latch_strike(frame, slide)` draws the deck's (0, −43) strike into a slot (frame 225, slide 16.5; the five sector strikes byte-identical): bite 2.63 mm³ at LOCKED, free along the slide and the lift at OPEN, south only (slid north the plate covers the trunk slot). Release path 0 mm³ with the carapace off (B143); 6.82 mm to the carapace (B127). |
| B50 | Star-board bracket vs the fallback battery strap | **SHIPPED (D064): both gone** | Deck v0.5 has no strap slots (no strap, pick 8 b) and the bracket is retired: the star board sits on the hub shelf. |
| B116 | A plain goto that detoured ran out of time at 1.2–1.5 m | **SHIPPED** (2026-09-30, BUILD_LOG 9o) | Measured 2026-09-30 on `87215110e9c4` with `sim/experiments/run_goto_detour_cap.py` (record: `sim/experiments/results/goto_detour_cap_results.json`): one goto per headless CockpitSim (the cockpit's own controller, righter off), from standing on the flat floor, straight into a 0.25 m wall or a 25 cm box (both above the lidar plane), seeded jitter (±3 cm along, ±8 cm across, ±15°), bearings 0° and 36°: 136 gotos of 1.0–2.0 m with it 0.45 m out, half way or 0.6 m short of the target, and (added in review) 64 of 1.2 and 1.5 m with the target 0.4 / 0.45 / 0.5 / 0.55 m behind it. Uncapped, 1.0 / 1.2 / 1.5 / 2.0 m detour gotos arrive in 44.5–55.9 / 50.2–68.9 / 57.1–75.0 / 67.5–85.7 s against 30.9 / 36.9 / 46.1 / 61.3 s with nothing in the way; 11 of 200 end `blocked` (10) or `stuck` (1) by themselves at 27.9–51.1 s, 10 of them with the target 0.4–0.5 m behind the obstacle. A detour costs 11.0–32.0 s up to 1.5 m (median 18.0, 174 arrivals): about one `GOTO_DETOUR_S` (15.5 s) for the 120 of the first placements (11.0–25.0 s, median 17.0), up to about two with the target 0.4–0.5 m behind (to 28.9 s at 1.5 m, 32.0 s at 1.2 m); a detour interval can hold both detours (31.0 s measured). Arrived, of 16 / 84 / 84 / 16 at 1.0 / 1.2 / 1.5 / 2.0 m: at the old 55 s 15 / 38 / 0 / 0 (up to 1.5 m every timeout at 55.0 s but one with a detour running, at 59.1 s: 3–45 cm short at 1.2 m, 9–50 cm at 1.5 m); at 71 s 16 / 78 / 77 / 1; at 75 s 16 / 78 / 80 / 4; at 87 s 16 / 78 / 80 / 15. The smallest cap that lands every detour goto up to the 1.5 m reach is 75.0 s: the latest arrival, 74.99 s (1.5 m, the target 0.4 m behind a box at 36°), came in at 74.95 s through `/api/tool/goto` and at 75.14 s when it started 6 ms earlier, so 75 s is a coin toss for it. The first recommendation, `goto_cap_s` with the reach grown by one detour ((1.5 + 0.45 m) × 1.2 / 0.0342 m/s + 2.36 s = 70.8 → 71 s), lands all 120 of the first placements up to 1.5 m, but misses 3 of the 1.5 m gotos with the target 0.4–0.5 m behind it (they arrive uncapped at 71.9–75.0 s; at 71 s they stop 5–16 cm short). **Chosen:** once a goto has entered a detour its cap is `goto_cap_s(speed, ease_in, GOTO_REACH_M + GOTO_DETOURS × GOTO_DETOUR_M)`, the reach grown by the most the detours walk off course before a third block ends the goto `blocked`: (1.5 + 2 × 0.45 m) × 1.2 / 0.0342 m/s + 2.36 s = 86.6 → **87 s**, 12.0 s over the latest arrival (the plain cap has 8.9 s over a clear 1.5 m goto), and it follows the envelope as 55 s does. The cap only ends a goto, so each uncapped run gives its outcome under any cap; `--verify 55 71` re-ran the 128 detour and close-target gotos with that rule (a detour running at the cap still ran out first): 128/128 ended as derived (within 0.05 s, 17 of them timeouts; that first record is in git history). Separately, 18 gotos through the real `/api/tool/goto` path with an independent hook gave the same outcomes, times within 0.3 s. Unaffected: a goto that never detours keeps 55 s (1.0 / 1.2 / 1.5 m arrive in 30.9 / 36.9 / 46.1 s; 2.0 m still times out at 55 s, 23 cm short). The stuck and blocked rules end every goto that cannot arrive long before either cap: a low box across the path `stuck` at 10.6 s; a sidestep into low boxes beside a wall `stuck` at 18.5 s (10.5 s after its first detour); a low box met after the detour cleared the wall `stuck` at 37.1 s; a long wall, a cul-de-sac and a closed pen `blocked` at 24.2 / 17.4 / 7.3 s. **Answer time:** before B116 a detour running at the cap ran out first, and one interval can hold both detours, so a goto could answer 55 + 31.0 + 1.5 = 87.5 s after the call, past the 72 s per leg `GO_BACK_TIMEOUT_S` (300 s, 4 legs) was sized for; at 87 s the same exception would have given 119.5 s, at the MCP proxy's 120 s. So the cap now ends a detoured goto even mid-detour (no arrival here comes after 85.7 s, so no count above changes). **Done:** `harness/capabilities.py` derives `goto_detour_timeout_s` = `goto_detour_cap_s(speed, ease_in)` (in the envelope and `FALLBACK_ENVELOPE`, and `GOTO_DETOUR_CAP_S` for the texts' defaults; `GOTO_DETOURS` / `GOTO_DETOUR_M` mirror the cockpit's, pinned by test), and goto's text says "55 s cap — a detour may extend it to ~87 s —" (`docs/TOOLS.md` regenerated; the tests' golden hashes and snapshot version moved on purpose); `sim/cockpit.py` keeps a sticky `detoured` flag per goto and times it out at `GOTO_DETOUR_CAP_S` (87 s) once it is set, at `GOTO_CAP_S` (55 s) if it never was, a detour running or not, so a goto answers by 88.5 s; `go_back_to` legs are ordinary gotos and get the detour cap too, so `harness/cockpit_backend.py`'s `GO_BACK_TIMEOUT_S` grew from 300 to 4 × (87 + 1.5) + 12 = 366 s, derived from the registry's cap (the proxy keeps a copy of `GO_BACK_MAX_LEGS`, pinned by test); the proxy's 120 s per call (now `TOOL_TIMEOUT_S`) keeps 31.5 s over a goto's 88.5 s, and no other wait on the goto path is shorter (the cockpit's HTTP route, the browser UI and the brains' tool loop have none; the place bench waits 180 s); `harness/sim_backend.py`'s goto has no detours and keeps 55 s. **Verified (2026-09-30):** `run_goto_detour_cap.py --verify` re-ran all 214 scenarios on the cockpit's shipped rule, untouched: 214/214 ended as derived from the uncapped runs (within 0.05 s; the uncapped runs reproduced the first record's numbers above exactly). 195 arrived (around an obstacle 16 / 78 / 80 / 15 of 16 / 84 / 84 / 16 at 1.0 / 1.2 / 1.5 / 2.0 m), 13 ended `blocked` and 4 `stuck` by themselves, and 2 timed out: the clear 2.0 m gotos, at 55.0 s, 23 cm short. No detour goto reached 87 s; the latest answer was 87.2 s (a 2.0 m arrival at 85.7 s + 1.5 s). The detour cap's own timeout, measured with the script's single runs (`--one`) and asserted through `/api/tool/goto` by two new tests in `sim/tests/test_cockpit_api.py` (within 0.05 s of the cap): a 2.9 m goto that sidestepped a 0.25 m wall at 0.45 m (detour 3.6–18.8 s) times out at 87.00 s, 58 cm short, with no detour running (the cap is sticky); with the caps shrunk to 5 / 9 s a 1.0 m goto into that wall times out at 9.00 s, its detour (from 3.6 s) still running. `go_back_to` to a ball remembered 2.0 m out behind a 0.25 m wall / box at x = 0.6: 72.6 / 72.1 s, two legs, the first arriving on the detour cap at 56.5 / 56.1 s (it was a 55 s timeout and a re-aim: 72.5 / 71.9 s); 53.2 s with nothing in the way, unchanged. **Review (2026-09-30, independent scripts, headless):** at the real caps a 2.9 m goto past that wall and a second one at x = 2.22 (uncapped, its second detour runs 72.5–88.0 s) ended `timeout` at 87.00 s with that detour still running and answered at 88.50 s; `go_back_to` reproduced 72.6 / 72.1 / 53.2 s, but where the call lands in the gait cycle moves the first leg by a few seconds: three runs behind the wall arrived at 56.5 / 56.6 / 53.0 s (back at the ball in 72.6 / 72.7 / 69.0 s), and with that leg held to 55 s it timed out twice (72.5 s, re-aimed) and arrived once (53.0 s). |
| B110 | One `cad-check --derived --fem` left a stale print pack | **SHIPPED** (2026-09-30, BUILD_LOG 9o) | `run_all_checks.py` built the derived outputs, the print pack among them, before `fem_check` ran, and the pack before `gen_drawings` too, while the pack prints each leg part's FEM verdict and merges its TechDraw sheet: after a change to a leg part one pass left the old verdict (and the old sheet) in the pack (D063 needed a second pass for the fork's SF 2.47). **Done:** with `--fem` the stress check runs right after the checks, before every derived output, and the derived order is preview, estimate, drawings, pack, viewer, assembly pictures (each reads the ones before it); a FEM FAIL still rebuilds them, so the pack shows it. `--jobs N` caps the parallel modules (this run used 6). `gen_drawings` also redraws a sheet when `td_sheet.py` changes (B105). **And a determinism bug the passes found:** pass 1 wrote a femur R+ of von Mises 3.36 MPa, SF 10.42 into `FEM_REPORT.md` / `fem_results.json`, pass 2 the true 2.94 / 11.90 (= R−, its mirror). Multi-threaded SPOOLES in the Flatpak's ccx now and then returns a wrong load step: the femur deck solved 6 times, 3 at once, with 4 solver threads gave 2 corrupt runs (step V: von Mises off by up to 74 MPa at a node, its p99.9 over all nodes 17.0 against 4.05; R+: 0.85); with 1 solver thread 6 of 6 were identical to the good runs. `fem_tools.run_ccx` now solves on one thread (assembly and stresses keep 4); `fem_check` took 66–72 s against 53–64 s. Governing SFs never moved (5/5 pass: coxa_yaw_base 2.93, coxa_fork 2.47, femur 2.18, tibia_knee_carrier 3.92, horn_coupler 7.81). **Measured:** `./rocky.sh cad-check --derived --fem --jobs 6`, five passes, 35/35 modules each (326–398 s); pass 1 rebuilt everything this round changed, fem_check before the drawings and the pack; with the one-thread solver no output moved again but for the sources edited between passes (pass 3 against 2: none; 4 against 3: the pack, for a new note), and pass 5 against pass 4 changed 0 of the 270 files under `cad/`. The FEM files are byte-identical to HEAD's, and the pack's strength table matches `fem_results.json` part for part. |
| B107 | The latch rotor had no keyway index | **SHIPPED** (2026-09-30, BUILD_LOG 9o) | B87's housing was round in a round pocket, glued at any angle, so its keyways could sit anywhere in the rotor's travel. As D063 left it (glued 45° off the entry line, as ASSEMBLY_GUIDE said) the lugs passed them at 42–48°, mid-turn, where a screwdriver pushing up can lift the rotor out; glued with them at OPEN, at −3…3°, the angle every panel comes off at. **Done:** the housing is a D (a flat 6.0 mm from its axis, square to the keyways) and every pocket the same D 0.15 bigger (`iface.latch_pocket`: the demo, the sectors' pads, the belly door, the tray tongue), so it goes in one way, keyways 135° from the entry line (`LATCH_KEYWAY_DEG`). `part_panel.latch_index` (on the demo and on the sector pad): on its index 0.00 mm³ with ±2.5° of play, turned ±10° or a half turn ≥ 1.4 mm³ (demo) / 2.4 (pad) (upside down it seats on its index: the housing is symmetric top to bottom, so either face up is the same part in the same place); the rotor lifted 1 mm into the housing meets ≥ 11.4 mm³ at every degree from −8 to 98 and drops through only at 132–138°, 42° past LOCKED and 42° back past OPEN; the door and tongue pockets seat it the same way (turned ≥ 1.8 / 1.77 mm³). Every D063 latch number unchanged (drop-in 0.00, bite 2.68 mm³ at LOCKED from 40°, stops 2.8 / 2.6, captive 13.9, the D's skin 100 %); the housing's thin-wall warning 9.4 mm². **Not a stop:** off the robot nothing holds the rotor's 3.8 mm of axial play, so turned 45° back past OPEN it still reaches its keyways; no rigid index can stop that (any turn that assembles it undoes it), only something over the head, glued after assembly (not drawn). The door and tongue take their own +x as the strike's until they have strikes (B51, B84). The D fills add 0.10 g of torso print (the five sectors 0.075, the door 0.018, the tray 0.009): regenerated in the final pass, as CI's design-pipeline check needs, `sim/mass_budget.json`'s torso 1439.7 → 1439.8 g and the URDF's 1.4397 → 1.4398 kg; the MJCF is byte-identical (it splits the torso into 1.0798 + 0.3599 kg, rounded to 0.1 g), so the fingerprint is unchanged. |
| B106 | The torque audit counted the hand twice | **SHIPPED** (2026-09-30, BUILD_LOG 9o) | `sim/torque_audit.py` weighed the robot at 2920.7 g against the MJCF's 2727.7 g: the 5 × 38.6 g of hand is already inside the tibia link (so it was at D062, 2887.6 vs 2694.6), and `cantilever_torques` put tibia + hand at mid-shin on an airborne leg. **Done:** the robot sum drops `m["hand"]`; `cantilever_torques` puts tibia − hand at mid-shin and the hand at the tip, where it hangs with the payload; `sim/tests/test_torque_audit.py` pins the audit's robot to the compiled MJCF (± 2 g), the hand to the tip, and the extended airborne leg's hip and knee to the MJCF's subtree moments (± 2 %: 0.1 and 0.2 % now; the old hip was 14 % over). **Measured** (re-run on `87215110e9c4`, `sim/out/torque_audit.json`; the scratch numbers held to the last digit): robot **2727.7 g** = the MJCF (2727.8 g since B107's 0.10 g of D fill went into `mass_budget.json`; the compiled MJCF still weighs 2727.7, its two torso pieces round to 0.1 g; no torque moved), every stance case × 0.934 (knee: stand 0.279 → 0.261 N·m, walk 0.349 → 0.326, 3-leg 0.466 → 0.435); self-right knee 1.496 → **1.397 N·m**, 50.9 → **47.5 %** of ST3215 stall, **HOT → WARM** by the audit's own flags (STS3250 30.5 → 28.5 %); carry hip 0.516 → 0.480 N·m, untucked-arm hip 0.290 → 0.254; both airborne knees unchanged (0.245, 0.112: about the knee, the hand twice at mid-shin is the hand once at the tip). Carried into SERVO_NOTES (and its 11.1 / 9.9 V knee figures, ~55 / ~62 → ~51 / ~58 %, computed), DESIGN_CHANGE_GUIDE §1, the runbook's soak loads and §8 load table (3-leg knee 0.47 → 0.43 N·m; masses at 100 mm 355 / 475 / 525 / 1525 → 330 / 445 / 490 / 1425 g; the torque-step and §8b mass 475 → 445 g), `bench/thermal_soak.py`'s docstring and D044's rerun trail. Fingerprint unchanged. |
| B105 | The fork drawing lost its pocket callouts | **SHIPPED** (2026-09-30, BUILD_LOG 9o) | D063 redrew `coxa_fork` at scale 0.5; its hole table listed only Ø2.4 × 4, because the hole finder (`cad/td_sheet.py`) counted only concave cylinders that close a circle, and the Ø6.4 relief, the Ø7 head relief and the Ø20.3 idler pocket are half circles open to the mouth, the same 180° as the ends of its Ø3.4 / Ø5.8 slots. **Done:** `td_sheet.features()` sorts the half circles: one with a partner facing it (same Ø, parallel axis, offset toward its open side, open back toward it) is a slot end, one without is an open channel, listed with its Ø and its depth along its axis in an OPEN CHANNELS table beside the hole table (the two tables moved to x 50 / 108 to clear each other and the title block), in `drawings.json`, a column of `drawings/INDEX.md` and the pack's drawing line. `gen_drawings` redraws a sheet when its STEP or `td_sheet.py` changes (`sheet_rev`), so all 10 were redrawn once. **Measured** on the 10 leg sheets: the fork lists Ø6.4 × 1.3, Ø7 × 0.6 and Ø20.3 × 1.8 along Z, one each (as the row measured), holes unchanged; the other nine list none and keep their hole tables; all 32 slot-end half circles (16 on the fork, 16 on the horn coupler) found their partners. Still not listed (re-measured in review, not new): concave arcs that are neither a full nor a half circle, i.e. holes or pockets cut into by another feature: coxa_yaw_base Ø2.4 (302°), femur_link Ø25.4 (172°), femur_plate_b Ø20.3 (319°), horn_coupler Ø14 (160°), tibia_knee_carrier Ø3.4 (299°), Ø6.5 (202°), Ø10.3 (342°): caliper those against the model. |
| B115 | `fem_check` printed 2.10 as "2.1" | **SHIPPED** (2026-09-30, BUILD_LOG 9n) | The per-part case tables printed bare floats. **Done:** `write_report` prints SF and both stresses `:.2f` and deflection `:.3f` (the summary table already did). Regenerated with `cad/fem_check.py` (the step `cad-check --fem` runs last, run alone): 5/5 parts pass with the same SF to 2 dp — coxa_yaw_base 2.93, coxa_fork 2.47 (R−), femur 2.18, tibia_knee_carrier 3.92, horn_coupler 7.81. FEM_REPORT.md changed on 12 lines, every number in them equal as a float ("2.1" → "2.10", "0.15" → "0.150"; the yaw base's R+ and R− von Mises both read 2.10); `fem_results.json` and the five pictures are byte-identical to HEAD, and a second run reproduced all seven files byte for byte. The print pack reads `fem_results.json`, so it is not stale (B110). `cad/test_fem.py` pins the row format. |
| B114 | The in-process goto stopped at 20 s | **SHIPPED** (2026-09-30, BUILD_LOG 9n) | `harness/sim_backend.py`'s goto capped at a fixed 20 s (its 1 s settle included) while the tool text it serves says 55 s. **Done:** `sim_backend.goto_cap_for(gait)` derives it the cockpit's way (`capabilities.goto_cap_s` at `V_GOTO` fitted into the gait's envelope, plus `gait_ease_in_s`): 55 s on the params gait, 57 s on `ArmedGait`'s 33.2 mm/s. It counts walking time, as the cockpit does, and a goto still walking at the cap ends `timeout` through the supervisor's stop and the 1.5 s linger (the loop used to end mid-stride and leave the mode `idle`; `safe_stop` now, as in the cockpit). Measured on the flat floor: a 1.5 m goto arrives (x 1.473 m); with a 20 s cap the same goto ends `timeout` at 0.622 m. `harness/test_harness.py`: the cap is the one the goto text quotes; a slow physics test times a 1 s cap out into a safe-stop. |
| B113 | `ArmedGait`'s envelope was above `WaveGait`'s | **SHIPPED** (2026-09-30, BUILD_LOG 9n) | It read 44.6 mm/s against `WaveGait`'s 34.2 because it inherited `WaveGait`'s ceilings, worked out at the un-leaned foothold on each leg's axis (75 mm from the coxa, strides 0–180°): 44.6 is that foothold's lift ceiling at duty 0.78 (a 0.44 s swing). No ceiling was skipped; all three were judged at the wrong foot. The 16 mm lean away from the arm puts the two legs opposite it 62.8 mm from their coxa and 8.6° off its axis, and at 44.6 the checker failed there: SPEED_LOADED (yaw 3.78 rad/s inside the 15 mm band: the lift ceiling), SPEED_FREE (4.11: the tangential one) and LIMIT_YAW (the coxa reached 42.7°, past the 40° soft limit); KINK held (0.003 rad/s). **Done:** `ArmedGait.vf_limit` takes each ceiling at every active leg's leaned foothold with the stride in any direction (the lift simulation over 24 directions; `WaveGait._swing_speeds` / `_lift_limit` take the foothold as data, `WaveGait`'s numbers unchanged): coxa 33.2 (the half-stride inside the ±33° wedge from the leaned foot, x sin 33° − \|y\| cos 33°), tangential 41.9, lift 37.3 → **33.2 mm/s, 0.174 rad/s in place** (the farthest leaned foot is 190.5 mm out). `_vf_max` and `foot_targets` use the leaned footholds too: a turn used to slide the stance feet by wz × the lean, 3.9 mm/s at the old envelope. Measured: 98 commands at the new envelope (72 headings, turns both ways, 24 arcs) pass every speed, limit and KINK check (peak 3.08 rad/s, KINK 0.003), max coxa 33.3°; the tangential-stride form of the coxa rule would have given 37.3 mm/s (lift-bound) and 36.5°. `run_sim_manip`'s 30 mm/s armed walk is inside it (unchanged); the in-process goto's cap on this gait is 57 s (B114). `gait/test_gait_motion.py`. **Found, not fixed:** (a) the checker's MARGIN fails `ArmedGait` at every command: while either leg beside the arm swings (44 % of the cycle) the CoM is outside the other three feet's triangle, −67.6 mm walking, a gait-design matter no speed budget fixes (it also reads −52.6 mm at a zero command, where no foot lifts: there only the checker's phase-based stance has 3 feet); (b) `WaveGait`'s coxa closed form, r_leg tan 33°, is the tangential stride only: a diagonal stride at its 60.9 mm/s ceiling reaches 40.9°, the any-direction rule gives 51.1. It does not bind (lift, 34.2). |
| B112 | The cliff safe-stop experiment still expected a march in place | **SHIPPED** (2026-09-30, BUILD_LOG 9n) | Since D063 a zero command is the standing pose, so the bare v = 0 halt no longer marches and the old verdict (fewer post-halt contact breaks than the bare halt) could not pass: 0 against 0, INCONCLUSIVE. **Done:** `run_cliff_safestop.judge()` checks the supervisor run on its own: the detector fires, no fall, five feet down with each foot's far side short of the edge, the stop goes through BRACE and ends in NORMAL, no foot leaves the ground after the halt, the torso < 1 mm/s over the last second; the bare halt is the reference, judged by the same checks but not required; the exit code carries the verdict. The void retreat now reaches the gait unslewed (`direct=True`), as in the harness's goto: slewed, the supervisor path stopped 43 mm nearer the edge (185.4 against 228.8 mm). Measured on `87215110e9c4`: **PASS**, stop margin 228.8 mm, the leading foot 46.2 mm short of the edge, 5/5 feet, 0 breaks, 0.0 mm/s, max tilt 0.48°, BRACE → RECOVER → NORMAL in 0.65 s; the bare halt passes the same checks (213.5 mm, foot 34.5 mm, 0 breaks). The negative control `--retreat-cycles 0` FAILS: a foot 11.5 mm over the edge, 4/5 feet down, 7 breaks, 1.34 mm/s. `sim/tests/test_experiment_limits.py`: each check can fail a clean stop; a slow test runs the pass and the control in physics. |
| B111 | The experiments' time limits were sized for 45 mm/s | **SHIPPED** (2026-09-30, BUILD_LOG 9n) | D063 moved the walks to the envelope ask (`scenes.walk_ask`, 34.2 mm/s) and left the limits at the 45 mm/s time, so many rubble trials ended at 350–390 mm, short of the 400 mm goal. **Done:** `run_stuck`'s `T_WALK` is the distance 25 s at `scenes.V_X` commanded (1125 mm) over `walk_ask`: 32.9 s today; `run_fairing` runs `run_stuck`'s trials and `run_stuck_voiced` its walk (the clip now runs 4 s past the crossing, so it still ends on amaze). `sim/sim_lidar.py`'s lap asks `scenes.V_X` on its 0.55 m ring through `WaveGait.budget` (26.6 mm/s + 0.048 rad/s, the ring kept) for the time that covers the arc 39 s at 45 mm/s covered (66.1 s), and re-recorded the `sim/lidar_scans.npz` fixture (528 scans, was 310). Measured on `87215110e9c4`: rubble 30 / 35 / 40 / 45 mm, bare → watchdog, 2/4 → 4/4, 2/4 → 4/4, 1/4 → 2/4, 1/4 → 1/4, 0 falls, tilt ≤ 12.6°, 10 of the 17 crossings after 25 s (D060 ladder, 2026-09-26: 2 → 4, 0 → 4, 0 → 2, 1 → 2); the shin fairing 1/4, 0/4, 0/4, 0/4 without the watchdog and 1/4, 0/4 with it at 40 / 45 mm: it hurts at every height; the voiced clip's seed 1 crosses at 32.5 s. SLAM-lite on the new lap: ATE 59.2 → 9.2 mm, end yaw 0.13°, map IoU 0.187 → 0.692 (the 2026-07-31 lap at a raw 45 mm/s: 55.6 → 8.2 mm, 0.06°, 0.255 → 0.716). The archived PERCEPTION_PLAN (`docs/archive/PERCEPTION_PLAN_2026-09-30.md`, the D063-model ladder), the experiments README and D023 / D027 carry the numbers; `sim/tests/test_experiment_limits.py`. |
| B104 | The walking shove floor was not like for like | **SHIPPED (D063)** | After the regen `sim/shove_envelope.py` still asked a raw 45 mm/s (`scenes.V_X`) with no budget, and with the command slew on the 3.0 s shove landed on a 43.2 mm/s command, still rising and above the 34.2 envelope, where D062 shoved a steady 45: that run's walking floor (min 30 N, mean 1.18 BW) mixed the new swing with a ramp in progress. **Done:** the walk asks the envelope-fitted speed (`scenes.walk_ask()`, 34.2 mm/s) and the shove lands at 5.0 s, 1.64 s after the 2.36 s ease-in; the script refuses a shove before the slew has settled and records the command at the shove (`t_shove_s`, `walk_ask_mm_s` in `sim/out/shove_envelope.json`). Walking at a steady 34.2 mm/s: 30 N in all six directions (min and mean 1.12 BW; at 35 N the 180 / 240 / 300° shoves tip past 60° and come back, which the criterion counts as falls); standing unchanged, 30 N (1.12 BW, mean 1.18). That walking floor is one gait phase: over 5 phases × 6 directions (measured 2026-09-30 for B103) the minimum is **25 N (0.93 BW)**, mean 30.2 N (0° shoved at 5.8 s holds 25 N and falls at 30 N); `sim/out/shove_envelope.json` records the single phase. D062's record disagreed with itself (BUILD_LOG 9k and D062 said walking 24 N; its committed JSON, min 20 N = 0.76 BW, is the record). **On `deae868522cc` (D064):** walking 30–35 N, min 1.08 BW, mean 1.14; over 5 phases min 25 N (0.90 BW), mean 31.2 N; standing 30 N (1.08 BW). |
| B79 | Dump the registers the motion depends on | **SHIPPED (D063)** | `bench/register_dump.py` archived addr 0–73 and never saw 85/86 (a hidden acceleration ramp). **Done:** it reads STS 0–87 and SCS 0–83 (0–73 with a warning when a servo refuses the long read), prints firmware, return delay, Lock, ACC, 85 and 86 per servo, and `--diff` takes pre-D063 dumps; the registers are in `registers.py` (EEPROM, VERIFY-ON-BENCH, addresses as LeRobot's tables), and a locked mock refuses EEPROM writes. Reading them off a real servo and picking 85/86 is bench work: B32. |
| B80 | Coxa fork cannot go onto the yaw servo | **SHIPPED (D063)** | The horn's centre head caught the hub's rear lip (1.0 mm) and the idler the upper plate (1.5): the slide-on path read 45.98 mm³ against the blank, 50.41 against the servo. **Done:** the idler pocket, its Ø7 head relief and a 6.4 mm horn-head channel open out through the C's mouth (`part_coxa._to_mouth`): both paths 0.00, +X is the bolted direction (the four horn screws, 47.48 mm³), new slide-on checks in `check_assembly` J1. The review found the open mouth lost the inward push (R−: SF 0.49 on the horn face alone): two 3 mm side cheeks, fork 14.07 → 19.60 g (+27.6 g a robot); `fem_check` runs R− on its own grips; SF V / R+ / R− / L+ / L− 5.71 / 8.47 / **2.47** / 5.95 / 4.85 (R− governs). |
| B81 | Yaw hub seat: the horn never sits in its pocket | **SHIPPED (D063)** | The hub rode 0.3 mm up on the horn's centre head, so the horn face never reached its Ø20.3 pocket. **Done:** option (b): no pocket (`HORN_POCKET_DEPTH` gone), the horn face bears on the flat hub top (35.76 mm³ under a 0.2 mm pull), the centre head sits clear in its Ø6.4 relief (0.3 mm of air), the four slotted screws locate it; `fem_check` holds the horn face (r ≤ 10.35, z 7.3 ± 0.35). |
| B82 | I1 thumbscrews: length (M3 × 16), hex head, not captive | **SHIPPED (D063)** | An M3 × 10 in the 8 mm knob ended 0.5 mm short of the insert, and its hex pocket was 1.5 deep. **Done:** knob 8.6 tall, hex pocket 2.1 (5.6 A/F), `THUMBSCREW_L` 16: the M3 × 16 hex head sits 0.1 below the knob top (was 0.5 proud) and engages 5.5 mm, the tip 0.5 inside the deck's underside; a turned knob keys the head (2.03 mm³ at 15°); a `thumbscrew_reach()` check. No retainer: the screw is not captive, and nothing models one. |
| B83 | The I6 set-knob bore misses the dovetail | **SHIPPED (D063)** | The bore passed 2.0 mm above the male, and the male was a key (its wide face at the root), so a shoe lifted straight off it (0 mm³ at any lift). **Done:** the I6 ring's male is an undercut dovetail (`iface.dovetail_male(undercut=True)`; `part_stand` keeps the key, byte-identical) and the shoe's tapped bore aims 45° at its flank: lifted 1 mm the shoe clashes 27.61 mm³ (held), both flanks load (1.19 F, 0.40 F); M3 × 12 is the shortest that reaches, A-19's M3 × 16 clamps with 6.1 mm of travel; the shell bars stand square to the wall chord and the knob faces the arch side. The frozen D020 widths read backwards on the ring (a params note). The wedge in PLA: B99's bench. |
| B87 | The I3 latch cartridge cannot assemble or bite | **SHIPPED (D063)** | The rotor could not enter its housing (≥ 17.8 mm³ at any angle), never reached its strike, and no coin reached its head with a sector down. **Done:** a bayonet (`iface.py`): the rotor drops through two keyways in the Ø14 housing and is captive once turned (13.9 mm³); the deck strike has entry slots, a 0.8 mm cam ramp over 0–50°, a dwell to 90° and a stop. Rotor into housing 17.78 → 0 mm³, housing skin 73 → 100 %, bite at LOCKED 0 → 2.68 mm³, a locked panel lifted 0.2 holds (5.5 mm³), stops at ±8° (2.8 / 2.6). Turned from under the deck (r 74.5) with a flat screwdriver ≤ 5 mm wide, not a coin (it gets ~0.5 of the 1.5 mm slot). `frame_coupon` (60 × 34 × 6) carries the deck's own strike. Open: the bite in PLA (B99), the latch over the bay (B100), no strike on the tray tongue or the belly door yet (the body layout, B51 / B84). The keyway index shipped as B107 (2026-09-30, BUILD_LOG 9o). |
| B88 | Hatch magnets have no seat to sit in | **SHIPPED (D063)** | The seat ledge was a 0.2 mm skin, the seat pockets had no floor, and the cap's plug pockets broke out (cap + magnets × sectors 50.96 mm³). **Done:** the pair at r 42.5 on a seat boss (2.0 walls, 1.0 floor, fused to the roof; at az 0 it reaches 7.3 mm into the opening as a tab): 0.000 mm³, seat and plug pockets walled 100 %, `hatch_magnet_checks`. The demo's pockets sit on bosses to the bed. |
| B89 | Pi standoffs are 58 × 44.1, not 58 × 49 | **SHIPPED (D063)** | A 0.9 scale on y since the first import put each Pi hole 2.45 mm off its standoff. **Done:** 58 × 49 from `PI_HOLES` unscaled, 11 mm tall (B90; an M2.5 × 6 engages 4.4 mm, an × 8 no longer bottoms), zip slots at y ±14; a pin down each hole axis 14.76 → 0.00 mm³; a check derives the holes from the Pi 5 drawing (58 × 44.1 would fail by 2.45 mm). |
| B90 | The IMU pad fits neither the BNO085 nor the space under the Pi | **SHIPPED (D063)** | The grommet holes missed the board's by 3.61 mm and the board stood 0.6 mm into the Pi. **Done:** holes 20.32 × 17.78 about the board centre (0, 13.5); the Pi raised on 11 mm standoffs rather than the pad moved; each seat lifted 1.2 mm over a Ø9 recess for the grommet's bottom flange. IMU top to the Pi's keep-out −2.60 → 1.20 mm; an M2.5 × 10 + DIN 934 nut, tail to the deck −0.30 → 0.90 mm (only × 10 works: × 12 reaches the deck); grommets vs the tray 101.52 → 0.00 mm³; a posed IMU + Pi check. Unchecked boards: B108. |
| B94 | `link_clip` on the D062 femur | **SHIPPED (D063)** | The clip met the bridge walls and couplers, and on the free span its 2.4 mm inner jaw grazed the swinging knee carrier. **Done:** inner jaw 1.2 mm, jaw depth 8.2 (the nubs clear the slot edge by the 0.3 fit), posed over plate A's slot at link x 60–68 (`link_clip_posed`): vs the carrier, knee servo and its plug keep-out 14.67 → 0.00 mm³, running clearance 1.0 mm (0.7 with the jaw's play), lifted 1 mm still hooked (2.24 mm³), and it snaps home. A light hook: the nubs reach 0.2 past the plate faces. |
| B72 | The battery sled is wider than its bay | **SHIPPED (D062)** | `part_battery.battery_sled` is the pack width plus two 2.4 mm walls: 50.8 mm (46 + 4.8, the STL measures 50.80), but `interfaces.battery_sled.bay_w` is 50, and `part_dock` sizes its funnel from `bay_w / 2` as the sled's half-width. Decide which moves (a 45.2 mm pack limit, 2.0 mm walls, or a 51 mm bay) and add the sled-in-bay check that `part_battery` only prints today; the pack itself is VERIFY on purchase (I5). **Done:** `pack_w` 46 → 44 (sled 48.8 mm; the BOM's pack is 43), and `part_battery` fails when sled + pack exceed the bay. D064: the fit check lives in `part_bay` (the sled 48.8 in bay_w 50, 0.60 a side). |
| B74 | The femur twists under a sideways foot load | **SHIPPED (D062)** | `cad/fem_check.py`: `femur` (plate A + plate B joined at the four bosses) **FAILS at SF 1.22** in the lateral cases (39 N at the foot, the yaw servo at stall; 4.9 N·m of twist about the femur's own axis) and deflects 4.5 mm at the knee; 1.16 on a 6× finer mesh, so it is the part, not the mesh. Hot spots: plate B's rails at the knee tower and the boss joints. The open twin-plate section is soft in torsion. What-ifs on the same loads: rails 6 → 9 mm SF 1.64 (+10.7 g); bridge walls 3 → 5 mm 1.29; a plate-B deck closing the box between the rails over the bridge (x 21–52, \|z\| < 11) 1.71 (+5.2 g, deflection 1.37 mm); **deck + 8 mm rails 2.16, PASS (+14.1 g, deflection 1.05 mm)**, deck + 9 mm 2.32. Found on the way (the drawings' hole table has no M3 hole for plate B): **plate B's four Ø3.4 screw holes break out of the rails' inner edge** (centre \|z\| 11.5, radius 1.7, rails from \|z\| 11: a 1.2 mm notch, 57 % of a 1 mm ring round each hole is material, the M3 head half on air); the deck puts them in solid plastic. The deck + 8 mm rails clears both servos, both plug keep-outs, the knee carrier's sweep and the fork over hip −90…90 (checked 2026-09-27); the femur-to-knee cable route is not modelled, so check it on a print. Changing the femur moves the mass and the fingerprint (B53). **Done:** deck + 8 mm rails in `part_femur` (SF 2.18 in the re-run), a hole-ring check, M3 × 12 (A-18). |
| B1 | Ramped TPU shin fairing | **NEGATIVE** (rerun 2026-09-30) | `sim/experiments/run_fairing.py` (D023) on the same rubble fields as its baseline (`run_stuck`), on the D063 model with `run_stuck`'s 32.9 s walk (B111): faired 1/4, 0/4, 0/4, 0/4 at 30/35/40/45 mm vs bare 2/4, 2/4, 1/4, 1/4; faired + watchdog 1/4 and 0/4 at 40 and 45 mm vs bare + watchdog 2/4 and 1/4. The rejection stands: it loses at every height, with and without the watchdog (the fat shin closes the gaps the high-step retry threads through). The 2026-09-26 run (D060 model, 25 s: faired 3/4, 1/4, 0/4, 0/4 vs bare 2/4, 0/4, 0/4, 1/4) showed a small gain at 30–35 mm without the watchdog; this one does not. The first A/B (helped only at 45 mm) ran on different fields: a builder bug, fixed 2026-09-26. |
| B2 | Belly skid rails | **SHIPPED, then RETIRED (D064)** | `part_smallwins.belly_skid` is retired: the keel tub's PETG floor (z −55.4, the robot's lowest point) is the skid (`part_bay`). |
| B3 | Trim-mass bosses | **SHIPPED** | `part_smallwins.trim_cup` + lid (M3-washer ballast on the deck grid) |
| B4 | IMU TPU grommets | **SHIPPED** | `part_smallwins.imu_grommet` ×4 |
| B5 | Calibration comb | **SHIPPED (as 2 gauges)** | `part_smallwins.calib_gauge_hip` + `calib_gauge_knee`; `bench/calibrate_centers.py --knee-at -90` |
| B8 | LED ring channel | **SHIPPED** | `part_shell.py` (wall-following groove, tier 2) |
| B9 | Shell vent gills | **SHIPPED** | `part_shell.py` |
| B10 | Per-leg numbering | **SHIPPED** | the deck's engraved station dots + north arrow |
| B11 | Whisker mounts | **SHIPPED** | `part_smallwins.whisker_shoe` |
| B13 | Femur / tube cable clips | **SHIPPED** | `part_clips.py` |
| B17 | Printed ST3215 servo blanks | **SHIPPED** | `part_servo_blank.py` (retire when the servos arrive) |
| B18 | Beckon gesture | **SHIPPED** | `pebble_gestures.beckon`, `sim/experiments/run_beckon.py`; D035 |
| B19 | Two-sided hip / knee brackets (rear idler) | **SHIPPED (D047)** | femur plate B rides the idler at hip and knee, the fork at the yaw |
| B20 | Case-screw servo retention | **SHIPPED (D047)** | `servo_mount.servo_cup` (four rim self-tappers) |
| B21 | Printability: cantilever rule | **SHIPPED** | `check_printability.py`; BUILD_LOG 8f |
| B24 | URDF masses from the CAD budget | **SHIPPED** | `generate_urdf.py` reads `sim/mass_budget.json` |
| B29 | Shove model: half-sine at the shell rim | **SHIPPED (D048)** | `sim/shove.py`, `sim/shove_envelope.py` |
| B30 | Righter without the staircase | **MERGED into B34** | — |
| B37 | One capability registry | **SHIPPED (D056)** | `harness/capabilities.py` → the local-brain schema, cockpit `/api/capabilities`, a live MCP list, `docs/TOOLS.md` (CI-checked) |
| B41 | Gemma as a brain (thinking on, a Gemma-style prompt) | **SHIPPED (D055a)** | per-family prompt notes: Gemma 12B 20/20, Qwen 9B 19/20; thinking on measured worse |
| B52 | Part checks that fail the exit code | **SHIPPED** (2026-09-27, D060 follow-up) | `part_panel`, `part_battery`, `part_avionics`, `part_bench_jig`, `part_footpad` and `part_smallwins` exit nonzero on a failed check, and so does `part_shell`'s bed-fit check, so `run_all_checks` enforces them (the D036 rule) |
| B53 | `params_rev` after a mass change | **SHIPPED** (2026-09-27, D060 follow-up) | a mass change bumps it: `params_rev` D052 → D059 for D059's torso change (fingerprint `7d376178fe27`); DESIGN_CHANGE_GUIDE says so |
| B62 | Benches force their own cockpit conf | **SHIPPED** (2026-09-27, D060 follow-up) | `vision_bench.start_cockpit` (also `brain_bench`'s) and `place_bench`'s own cockpit force the bench's scratch `ROCKY_COCKPIT_CONF`, `ROCKY_MEMORY_DIR` and `ROCKY_GESTURE_DIR` over the environment, never `setdefault`, so neither an exported variable nor a `rocky.env` can point a bench cockpit at the user's conf, memory or gestures |
| B63 | Tests on the reference setup | **SHIPPED** (2026-09-27, D060 follow-up) | the repo-root `conftest.py` (and `./rocky.sh test`) sets `ROCKY_ENV_FILE=/dev/null` unless it is already set, so every test, and every subprocess a test starts, runs on the reference setup whatever `rocky.env` says |
| B64 | Ruff in CI | **SHIPPED** (2026-09-27, D060 follow-up) | the pyflakes findings fixed; `[tool.ruff.lint]` in `pyproject.toml` selects F + E9 (F403 / F405 ignored for the CAD modules' `from build123d import *`), and CI runs `ruff check .` before the tests; `constraints.txt` pins ruff (0.16.9) as it pins MuJoCo, so a new release cannot fail CI unannounced |
| B69 | A tracked record for the gesture audit | **SHIPPED** (2026-09-27, D060 follow-up) | `sim/audit_gestures.py --json F` always wrote a record, but none was committed, so no tracked file held the numbers the docs quote. `sim/out/audit_gestures.json` is that record now (robot `7d376178fe27`, params D059; a second run is byte-identical): 20 rows, 0 FAIL, 15 warn TRACK (gait p95 16.5–18.5°), `manip_adjacent` MARGIN_WARN at a 17.4 mm CoM margin. Re-run it with the SIM_GUIDE §4 command when the model changes |
| B70 | `pose_check` on a partial bus | **SHIPPED** (2026-09-27, D060 follow-up) | it checks the servos that answer (the one-leg bench is ids 1–3; `--ids` narrows it, `--mock-ids` rehearses it) instead of stopping with `NoResponse` ([BENCH_RUNBOOK](../bench/BENCH_RUNBOOK.md) §5) |
| B71 | Mock rehearsals out of the robot's calibration | **SHIPPED** (2026-09-27, D060 follow-up) | a `--mock` run writes and reads `bench/out/mock/` (its `calibration.yaml` too), so a rehearsal can never leave made-up offsets for a real `calibrate_centers` run to merge into |
| B73 | The MCP server finds the cockpit on its port | **SHIPPED** (2026-09-27, D060 follow-up) | `harness.cockpit_backend` defaulted to :8765 whatever `ROCKY_COCKPIT_PORT` said, and a server an MCP client started directly never read `rocky.env`, so on a machine with another cockpit port `ROCKY_BACKEND=auto` silently drove the in-process sim and a stop never reached the cockpit (the D052 failure mode). The default is now `ROCKY_COCKPIT_URL`, else 127.0.0.1 on `ROCKY_COCKPIT_PORT`, else :8765, and `python -m harness.server` applies `rocky.env` first (`sim/envfile.py`; a variable already set wins); both are tested |
