2BitwiseBard/rocky/cad/out/fem/FEM_REPORT.md

# FEM report (D061)

Generated by `cad/fem_check.py` (`rocky.sh cad-check --fem`). Do not edit by hand.

Material **PETG**: E 1500.0 MPa, von Mises allowable 35.0 MPa, across-layer tension allowable 20.0 MPa (VERIFY: coupon pulls). Pass at SF >= 2.0, warn at >= 1.5.

Stance (leg frame, mm): hip (45.0, 61.0), knee (123.8, 7.9), foot (75.0, -118.0). Servo stall 2.94 N.m.

| case | foot force (N, leg frame) | limited by |
|---|---|---|
| V | (0.0, 0.0, 60.3) | knee servo at stall |
| R+ | (16.4, 0.0, 0.0) | hip servo at stall |
| R- | (-16.4, 0.0, 0.0) | hip servo at stall |
| L+ | (0.0, 39.2, 0.0) | yaw servo at stall |
| L- | (0.0, -39.2, 0.0) | yaw servo at stall |
| T+/T- | coupler only: stall torque about the horn axis | - |

| part | verdict | SF | case | governs | peak util (raw) | deflection (mm) | mesh |
|---|---|---|---|---|---|---|---|
| coxa_yaw_base | **FAIL** | 1.10 | V | von Mises | 1.04 at (-33.1, -16.1, -1.4) | 2.294 | 19613 el |
| coxa_fork | **PASS** | 2.47 | R- | layers | 0.50 at (2.0, 16.6, 7.3) | 1.763 | 23667 el |
| femur | **PASS** | 2.18 | L- | von Mises | 0.66 at (52.0, 35.6, -11.0) | 1.058 | 43446 el |
| tibia_knee_carrier | **PASS** | 3.92 | L- | layers | 0.36 at (139.2, 9.4, 35.6) | 0.068 | 12468 el |
| horn_coupler | **PASS** | 7.81 | T+ | von Mises | 0.13 at (-11.0, 0.5, 2.9) | 0.015 | 39190 el |

SF is the 99.9th-percentile utilisation over surface nodes more than 1.5 mm from a grip. When the raw peak is well above 1/SF, look at that spot in the picture: it is either a sharp modelled corner (a real print rounds it) or a real hot spot.

## coxa_yaw_base

coxa_yaw_base

Held: the docked I1 support (B118): the inboard pads (x <= seat_relief_x0, over the deck), the two seat flanks, the two thumbscrew heads in tension; V: pads + screws (the seats lift), R-: seats + screws (the pads lift), L+/L-: the pressing side's pads, both seats, the lifting side's screw (599 nodes). Loaded: yaw servo case in the cup (3990 nodes). Build direction (part frame): (0.0, 0.0, 1.0).

| case | F (N) | M (N.mm) | von Mises p99.9 | layer tension p99.9 | SF | deflection |
|---|---|---|---|---|---|---|
| V | (0.0, 0.0, 60.29) | (0.0, -4521.8, 0.0) | 30.44 | 16.90 | 1.10 | 2.294 |
| R+ | (16.42, 0.0, 0.0) | (0.0, -2365.1, 0.0) | 4.65 | 3.48 | 5.75 | 0.284 |
| R- | (-16.42, 0.0, 0.0) | (0.0, 2365.1, 0.0) | 4.91 | 4.07 | 4.90 | 0.310 |
| L+ | (0.0, 39.2, 0.0) | (5644.8, -0.0, 2940.0) | 11.27 | 8.09 | 2.41 | 0.226 |
| L- | (0.0, -39.2, 0.0) | (-5644.8, -0.0, -2940.0) | 9.58 | 8.32 | 2.40 | 0.205 |

## coxa_fork

coxa_fork

Held: yaw horn face on the flat hub top + yaw idler pocket (open to the mouth); R-: the horn face alone (1143 nodes). Loaded: hip servo case in the cup (3866 nodes). Build direction (part frame): (0.0, 0.0, 1.0).

| case | F (N) | M (N.mm) | von Mises p99.9 | layer tension p99.9 | SF | deflection |
|---|---|---|---|---|---|---|
| V | (0.0, 0.0, 60.29) | (0.0, -1808.7, 0.0) | 4.81 | 3.49 | 5.71 | 0.196 |
| R+ | (16.42, 0.0, 0.0) | (0.0, -2940.0, 0.0) | 3.15 | 2.37 | 8.47 | 0.131 |
| R- | (-16.42, 0.0, 0.0) | (0.0, 2940.0, 0.0) | 10.90 | 8.10 | 2.47 | 1.763 |
| L+ | (0.0, 39.2, 0.0) | (7016.8, -0.0, 1176.0) | 4.57 | 3.21 | 5.95 | 0.122 |
| L- | (0.0, -39.2, 0.0) | (-7016.8, -0.0, -1176.0) | 4.57 | 4.13 | 4.85 | 0.122 |

## femur

femur

Held: hip coupler recess (plate A) + hip idler pocket (plate B); plates joined at the 4 bosses only (3246 nodes). Loaded: knee coupler recess + knee idler pocket (3302 nodes). Build direction (part frame): (0.0, 1.0, 0.0).

| case | F (N) | M (N.mm) | von Mises p99.9 | layer tension p99.9 | SF | deflection |
|---|---|---|---|---|---|---|
| V | (-33.71, 0.0, 49.99) | (-287.4, 2940.0, -193.8) | 4.23 | 1.19 | 8.26 | 0.281 |
| R+ | (13.62, 0.0, 9.18) | (-52.8, -2067.6, 78.3) | 2.94 | 0.64 | 11.90 | 0.370 |
| R- | (-13.62, 0.0, -9.18) | (52.8, 2067.6, -78.3) | 2.94 | 0.64 | 11.90 | 0.370 |
| L+ | (0.0, 39.2, 0.0) | (5160.1, -0.0, 1174.1) | 15.48 | 6.66 | 2.20 | 1.058 |
| L- | (0.0, -39.2, 0.0) | (-5160.1, -0.0, -1174.1) | 15.48 | 5.71 | 2.18 | 1.058 |

## tibia_knee_carrier

tibia_knee_carrier

Held: knee servo case in the cup (4494 nodes). Loaded: tibia tube in the clamp socket (893 nodes). Build direction (part frame): (0.0, 0.0, 1.0).

| case | F (N) | M (N.mm) | von Mises p99.9 | layer tension p99.9 | SF | deflection |
|---|---|---|---|---|---|---|
| V | (-21.78, 0.0, 56.22) | (0.0, 2380.3, 0.0) | 2.66 | 2.41 | 8.33 | 0.032 |
| R+ | (15.32, 0.0, 5.93) | (0.0, -1674.0, 0.0) | 1.80 | 1.88 | 10.64 | 0.023 |
| R- | (-15.32, 0.0, -5.93) | (0.0, 1674.0, 0.0) | 1.80 | 1.76 | 11.36 | 0.023 |
| L+ | (0.0, 39.2, 0.0) | (4284.6, -0.0, 0.0) | 5.53 | 4.20 | 4.76 | 0.068 |
| L- | (0.0, -39.2, 0.0) | (-4284.6, -0.0, -0.0) | 5.53 | 5.10 | 3.92 | 0.068 |

## horn_coupler

horn_coupler

Held: horn screw slots + disc face (13283 nodes). Loaded: upper half of the shear lobes (8414 nodes). Build direction (part frame): (0.0, 0.0, 1.0).

| case | F (N) | M (N.mm) | von Mises p99.9 | layer tension p99.9 | SF | deflection |
|---|---|---|---|---|---|---|
| T+ | (0.0, 0.0, 0.0) | (0.0, 0.0, 2940.0) | 4.48 | 1.22 | 7.81 | 0.015 |
| T- | (0.0, 0.0, 0.0) | (0.0, 0.0, -2940.0) | 4.48 | 1.31 | 7.81 | 0.015 |
