2BitwiseBard/rocky/NOTES_INBOX.md

# Notes inbox — raw measurements and results

*Dump anything here: measurements, print results, arrivals, ideas, questions; no structure
needed. Each entry is filed into its home (`cad/params.yaml`, `docs/decisions.md`, a guide,
`BUILD_LOG.md`) and then cleared from this file. Last cleared 2026-09-26: every entry up to
2026-09-22 is filed (BUILD_LOG sessions 8e, 8f and 9).*

---
