2BitwiseBard/rocky/docs/decisions.md

# Decision Log (ADR-lite)

*One line of context, the decision, and why. Revisit only with new evidence.*
*D001–D065, plus the amendments D052a and D055a (and B162 wip 1's and its review round's inside D065). A bold AMENDED / SUPERSEDED marker names
the later decision that overrides part of a row; a bold RERUN note gives what the experiment
rerun measured where a row's number moved (RERUN 2026-09-26 on fingerprint `7d376178fe27`;
a later RERUN names its own model), and the row keeps its dated number, true for the model it was measured on
([sim/experiments/README.md](../sim/experiments/README.md#the-current-record)). Rows D036–D057
are condensed; their full-length text is in
[docs/archive/decisions_D036-D057_full.md](archive/decisions_D036-D057_full.md).*

| # | Date | Decision | Why / consequence |
|---|---|---|---|
| D001 | 07-27 | **Subscale first** ("Pebble", 1:3) before GSD-scale Rocky | Torque scales ~L⁴; mistakes cost $17/joint not $500. Software transfers. |
| D002 | 07-27 | **ST3215 12 V (30 kg·cm) only**, 3S pack | 7.4 V variant fails the 3-leg-stance torque budget. Order carefully — listings mix variants. |
| D003 | 07-27 | **One serial bus, no per-leg MCUs** at subscale | 1 Mbps handles 20 servos at 50–100 Hz; five ESP32s = complexity with no payoff. Full-scale Rocky revisits (CAN + leg nodes). |
| D004 | 07-28 | **Code-CAD (build123d), `params.yaml` = single source of truth** | The owner has no CAD background; parts as Python + one param file shared with the future URDF. Claude iterates, the owner reviews renders/viewer. |
| D005 | 07-28 | **True radial symmetry + transforming 3-finger hands** | Rocky-canon. Closed fingers form the cone foot → grasp servo carries no walking load. |
| D006 | 07-28 | **Creature look = bolt-on shells over a pure-mechanism skeleton** | Iterate aesthetics freely without touching working joints. Rock texture is a late cosmetic pass. |
| D007 | 07-28 | **Interactive deliverables: self-contained HTML, browser-verified before delivery** | Chat preview sandbox blocks CDNs (three.js failure). Hand-rolled WebGL viewer; Playwright/Chromium screenshot check mandatory. |
| D008 | 07-28 | **Gait defaults respect CAD joint sweeps** (1.6 s cycle, R0 185, 45 mm/s → coxa ≤ 22°, validated ±40°) | Software limits mirror verified mechanical limits; enforce in firmware + URDF later. **AMENDED by D052**: cycle 2.0 s, step 24 mm, every command budgeted to 45.5 mm/s / 0.246 rad/s (params `gait:`). **D063**: 34.2 mm/s / 0.185 rad/s (the soft-landing swing, same cycle and step). |
| D009 | 07-27 | **ROS 2 Jazzy + MuJoCo sim-first**; gait core stays dependency-free Python | Walk in sim before hardware exists; same module drives sim, then ros2_control. |
| D010 | 07-28 | **SEA cartridge sits between tube and hand hub**; slider stub = tube-OD | Hand hub needs no redesign; spring travel 7 mm; microswitch = free contact sensor. |
| D011 | 07-28 | **First prints in PLA**, even parts that end up PETG | Material is sunk-cost-free iteration; dial fit before spending the purple. |
| D012 | 07-28 | **Deck = R100 one-piece + 25 mm coxa cantilever**, not a split plate | 289 mm plate can't fit the Prusa bed; cantilever moment is negligible. |
| D013 | 07-28 | **Default manipulation stance uses NON-ADJACENT arms** (0 & 2) | From nominal stance, adjacent-arm CoM sits ~57 mm outside support. AMENDED by D018. |
| D014 | 07-28 | **Cross-section slices are a standard CAD verification** alongside renders + booleans | Caught hand v0.1 wedges that were near-full cones (fingers could never nest). |
| D015 | 07-29 | **Batch 1 servos stay ST3215 12 V; STS3250 (50 kg·cm, same case) is the sanctioned upgrade path**, optional 2× trial via AliExpress for Batch-2 femurs | Walking margins fine on ST3215 (22–33% stall); STS3250 takes untucked 3-leg manip from 43–65% (thermal no-go) to 28–42%. ST3235 rejected: 30 kg·cm despite the name, 2.3× price, durability-only. Hiwonder (proprietary bus, pot sensors) and Dynamixel (½ the torque/$) rejected. Caveats to bench: STS3250 spec 6–12 V vs 12.6 V full 3S; 4.2 A stall. **Buy SUPERSEDED by D058**: all-ST3215, no STS3250. |
| D016 | 07-29 | **Hand micro-servos get their own 5–6 V power domain** (BEC in Batch 2); TTL data + GND shared with the 12 V leg bus | SCS0009 is a 4.8–6 V device — the master-plan diagram had it on the 12 V rail, which would cook it. Also: SCS speaks protocol 0, STS protocol 1 — driver must handle both on one bus. |
| D017 | 07-29 | **Sim robustness baselines recorded** (blind gait, zero reflexes): rubble ≤30 mm crossed reliably, snag-not-fall to 40 mm (step height 32 mm is the binding limit); push envelope 35–53 N walking / 46–53 N stance (0.15 s shove; ≥1.3× bodyweight) | Phase-3 terrain adaptation should trigger on progress/contact-timing, not tilt (it never falls, it stalls); raising step height is the cheap terrain lever; stabilization is for grace, not survival. **Push numbers SUPERSEDED by D048/D052a** (rim half-sine: standing floor 29 N = 1.11 BW, walking min 0.76 BW); the rubble / snag baselines predate D052's 24 mm step. **RERUN 2026-09-26** (`7d376178fe27`): rubble crossed reliably ≤ 25 mm (30 mm 2/3, 35–40 mm 0/3), still snag-not-fall; the rectangular CoM pulse on the bare gait (`run_push_reflex`'s ladder to 90 N) holds walk 27–90 N / stand 57–90 N (`run_push`'s 27 N ladder saturates). |
| D018 | 07-29 | **Adjacent-arm manipulation is feasible via foot repositioning** (amends D013): crouch 30 mm → step flanks to R280 at ±22° (coxa ≤39.8°) → lean 12 mm → FOLDED carry pose | Sim-verified: tilt ≤5.1°, work margin +10 mm (control case falls at arms-up, as D013 predicted). Raised-limb mass shifts CoM ~20–35 mm — reach-out arm pose tips the robot; carry pose is mandatory. Margin is thin: hardware version wants contact confirmation before trusting it. |
| D019 | 07-29 | **Two-arm mode selection: NON-ADJACENT (0&2, leg between) is the default for all two-handed work; ADJACENT (D018 recipe) is reserved for cooperative bimanual** | Workspace math at coxa ±40°: non-adjacent hands can never close within ~252 mm (disjoint reachable sets — independent tasks only); adjacent hands close to ~94 mm — the only cooperative config. Middle planted leg never obstructs (both hands ≥32° off the bisector). Bimanual levers if wanted later: coxa range (clevis v2), finger length, wrist DOF at full scale. |
| D020 | 07-30 | **Six standard interfaces, spec'd + frozen** (`docs/INTERFACES.md`, dims in params.yaml `interfaces:`): I1 leg port (dowels + hook-pivot + captive thumbscrews; XT30 + JST-XH-5), I2 tool socket (quarter-turn bayonet on the SEA stub + JST-SH-3), I3 panel standard (replaceable quarter-turn latch inserts + magnet pockets; belly door + top hatch first), I4 avionics tray (rails + one latch + rear bulkhead), I5 battery sled + XT60 blind-mate dock + XT30 spare taps, I6 accessory dovetail ring. **Rule: loads route through dowels/lips/shoulders, never through latches/screws/magnets.** | Serviceability is a design requirement, not a nicety: leg swap <2 min, tray out with one latch, panels in seconds, tools quarter-turn. Each interface has an explicit Rocky-scale mapping (steel dowels/cam levers, powered tool flange, SB120, rail ring) so Pebble validates the architecture, not just the parts. **AMENDED by D063**: the I3 cartridge is a bayonet turned from under the deck with a flat screwdriver; the I6 ring's male is an undercut dovetail clamped at its flank (the stand keeps the key), so `dovetail.base_w` / `crest_w` read backwards on the ring; **REVISED by D064 (2026-10-07)** for I1, I4 and I5: the dowels become seats (a cone and a V socket, `seat_xy`, slot 6.2; `cad/check_dock.py`), so the rule reads seats / lips / shoulders, and the stance load runs through the thumbscrews anyway (B118, B139); I4 is the tray at (0, 0) turned 180° with lugs and a slotted strike, the Pi + IMU only; I5 is the 192 × 50 × 33 keel tub with the XT60 carrier in its nose, no strap and no dock block. "Tray out with one latch" holds with the carapace off and the robot off the stand (B143). |
| D021 | 07-30 | **Hand v0.2.1: design open = 55° (was 65°), cam slots carved from the true tilted-pin slab footprint, OPEN-ENDED at full travel; pin arm raised 3 mm** | Dense pose sweep (5° steps — the 3-pose check missed it, D014 again) found the residual graze was the PIN leaving its slot: a tilted pin's slab footprint grows ~1/cosθ + T·tanθ; at 65° the needed slot breaches the cam rim AND the skirt clips neighboring lugs. 55° was already the software cap (07-28) — geometry and software now agree. Full-open end stop = servo limit, not the cam. Worst clash across 14 poses: 0.00 mm³. |
| D022 | 07-30 | **Push-recovery reflex (crouch-and-brace on \|gyro\|>1.8 rad/s) adopted for WALKING only; quiet stance stays stiff-planted** | Sim: walking floor rises 33→40 N (≥1.5× bodyweight all directions) and the weak gait phases flatten; in stance the brace transient *costs* ~6% (stiff+planted is already optimal). v1 lessons encoded: never slide loaded feet, ramp the crouch (a step-crouch unloads feet mid-shove), plant the swing leg where it is. `gait/pebble_reflex.py`, results `sim/experiments/results/pre_d052/push_reflex_results.json`. **DEMOTED by D025** (phase-confounded). **RERUN 2026-09-26**: the 33 → 40 N walking floor rise no longer reproduces (27 → 27 N); the stance cost is −1 %. |
| D023 | 07-30 | **Stuck watchdog (progress ratio < 0.4 for 2 checks → escalating retry: step 46→52 mm, slow, +body, reverse) adopted; ramped shin fairing REJECTED by sim** | 40 mm rubble crossings 1/4 → 4/4 with the watchdog (D017's "trigger on progress" was right). Fairing (`sim/experiments/run_fairing.py`): helps only at 45 mm (outside the envelope), *hurts* the watchdog at 40 mm (fat shin closes the gaps high-stepping threads through) — don't print it. 45 mm+ remains out of scope for Pebble. **AMENDED by D060**: the retry ladder is derived inside the D052 envelope (24 → 34.8 → 42 mm). **RERUN 2026-09-26** (that ladder): 40 mm 0/4 → 2/4 with the watchdog (30 mm 2 → 4, 35 mm 0 → 4, 45 mm 1 → 2 of 4). The fairing, now on the same rubble fields as its baseline (the first A/B was not: a bug found 2026-09-26): the rejection stands, but "helps only at 45 mm" is false: it hurts at 45 mm (0/4 vs 1/4 bare; with the watchdog 1/4 vs 2/4 at 40 and 45 mm) and helps slightly at 30–35 mm without the watchdog (3/4 vs 2/4, 1/4 vs 0/4). **RERUN 2026-09-30** (`87215110e9c4`, B111: the walk at the 34.2 mm/s envelope for 32.9 s, the distance the 25 s limit commanded at 45): with the watchdog 30 mm 2 → 4, 35 mm 2 → 4, 40 mm 1 → 2, 45 mm 1 → 1 of 4, no falls; the fairing now hurts at every height (1/4, 0/4, 0/4, 0/4 without the watchdog; 1/4 and 0/4 with it at 40 and 45 mm). |
| D024 | 07-30 | **360° lidar promoted to Phase-3 CORE via a used LDS02RR vacuum pull (~$17, maintained ROS2 driver); scan contract frozen now** (`sim/laserscan_spec.json`, sim-lidar + occupancy demo working) | The $99 optional line is dead: pulls cost 1/6 of it and the SLAM pipeline can be built entirely in sim before the puck exists (it was). Neato XV-11 pulls aged into ~$60 collector stock — wrong pull. No-gamble alt: LD19 new at ~$90 (and 42 g vs 190 g — the mass audit's lever). (pull superseded by D058: the LDRobot D500, 45 g) |
| D025 | 07-31 | **Push reflex DEMOTED to a safe-stop/posture primitive; the bare wave gait is the best single-impulse controller.** v2 (`pebble_reflex.py`: finish-the-step PLANT + tilt-vector contact-seeking BRACE) replaces v1 wherever a brace is wanted; reflex stays OFF for push survival. | The D022 numbers were PHASE-CONFOUNDED: the supervisor's gait clock ran during idle, so every reflex trial was 0.625 cycles offset from its baseline. Phase-aligned re-measurement (`sim/experiments/run_push_reflex_v2.py`): walk envelope mean base 43.5 N > v2 40.9 > v1 37.1; v2 ≥ both at every probe phase in the weakest direction (v1's +0.25T pocket erased); sustained-lean test shows no reflex benefit either (gyro trip barely fires on a slow lean). Mechanism findings that survive: freezing mid-swing leaves a broken polygon at the shove peak, and crouching loaded pivot-side legs during a tip actively pushes the robot over (51° vs 14.7° tilt). PLANT→BRACE (freeze only at swing-low + ≥3 contacts) is the correct EMERGENCY STOP — pairs with the cliff detector. **Numbers predate D052's spawn-pose fix** (a 9.8° spawn tilt, D052a). **RERUN 2026-09-26**: the order flips by one ladder step (in two directions), v2 55.4 ≥ base 54.4 ≥ v1 53.2 N walk mean, floor 27 N in all three; v2 ≥ base at every probe phase and no sustained-lean benefit still hold. Not re-decided. |
| D026 | 07-31 | **EKF yaw observability: standing zero-yaw-rate pseudo-updates via a StillnessGate (1.2 s quiet + full contact); gyro-bias prior opened to (0.01 rad/s)²; mag stub optional-off.** | Yaw drifted at exactly gyro-z-bias rate (~6°/21 s) — nothing in IMU+legs observes yaw. The naive fix fired during the boot settle and learned the WRONG bias: a position-servo robot keeps a decaying real twist (0.3–1.2°/s — bias-scale!) for >1 s after any pose change; calibrate at the END of pauses, never the start. Results: flat walk 6.8°→0.25° end yaw, patrol 15.1°→1.7°, bias estimate lands on truth, translational drift also improves (10.8→5.5 %). |
| D027 | 07-31 | **SLAM front-end owned in-repo: EKF-seeded point-to-line ICP with keyframes** (`perception/scan_matching.py`, `sim/experiments/run_slam_lite.py`); slam_toolbox stays the ROS 2 target but nothing waits on it. | Lap metrics: trajectory ATE 55.6→8.2 mm RMSE, end 75→10 mm, yaw 4.8°→0.06°, map IoU vs truth 0.26→0.72 (17 keyframes, 2.8 mm median scan fit). `sim_lidar.py` now runs the EKF in-loop so the archive carries real odometry. Bonus find: the session-4 lap was physically grinding a pillar at 43 % speed (GT poses mapped fine so nobody noticed; the EKF noticed) — lap routes are now clearance-audited. **RERUN 2026-09-30** on the lap re-recorded inside the envelope (`87215110e9c4`, B111: 26.6 mm/s + 0.048 rad/s, 528 scans): ATE 59.2 → 9.2 mm, end 96 → 10.5 mm, yaw 8.6° → 0.13°, IoU 0.19 → 0.69 (17 keyframes, 2.8 mm fit). |
| D028 | 07-31 | **Chord-speak v0.2 voice spec ("Eridian"): chord-SYLLABLES with speech envelopes; just-intonation stacks with septimal/undecimal intervals on 66–200 Hz roots; one fixed formant throat + band-limited breath; roughness/detune = urgency/uncertainty. NO scale runs, NO cadences.** | The owner's verdict on v0: "too musical, too nice." Measured fix: 12-TET pitch-grid energy 85 %→24–39 % (amaze keeps 72 % deliberately), spectral centroid ~7 kHz→210–360 Hz after band-limiting the breath (the first v2 render was a whisper, not a chest). Event engine (`chordspeak_events.py`) narrates runtime events with priorities/cooldowns/preemption; the 40 mm stuck-retry video now carries its own narration. v0 kept in-repo for A/B (removed 2026-09-26, D060; git keeps it). |
| D029 | 07-31 | **Carapace v0 architecture: five IDENTICAL printable rock sectors + hatch cap** (`part_shell.py`): terraced perturbed-pentagon tiers, leg arches sized from the fork-swing disc (the entire yaw sweep stays within ±14° of the station — arch ±22° covers it), web feet (r 73–82, az 21–36°) with latch pad + magnets, vertical I6 bars at ±27°, B8 LED groove FOLLOWING the rocky wall, B9 gills. All four keep-outs boolean-clean. **D064:** the proxies missed the docked cup's back wall, 42.80 mm³ into every sector; `part_shell` now gates the real base and yaw servo and `cup_back_relief` clears them (B124). | Pentagon math bites: the soft-pentagon factor shrinks mid-edge radii ~11 % — every wall-relative placement must query the outline function (a circular LED groove missed the wall entirely at the webs). Mass flag: 39 cm³/sector ≈ 47 g PETG ×5 — a thinning pass rides the post-caliper regen. Latch inserts (Ø14.3) outgrow the 9 mm foot annulus → local pads, placed where the coxa-plate y-clearance is generous. |
| D030 | 07-31 | **Carapace seams are REAL joints: 72°-periodic outline noise + a chaining tongue-and-groove on the sector edges; deck v0.4 answers the shell (5 latch strikes with tangential peg entries, 5 washer recesses, power grommet); shell amended to ONE magnet per web at r 76.** | Non-periodic rock noise meant five identical sectors met with mismatched wall radii at every seam — invisible in renders (disjoint wedges can't interfere), fatal for any edge joint. Tiling one 8-vertex noise pattern 5× makes seams flush by construction; the vertical tongue/groove then registers neighbors (pair interference 0.00 mm³, engagement check 15.5 mm³ displaced — and the first groove was cut into open air on the wrong side of the edge plane, caught by that check). Deck side: radial peg slots breached the pentagon edge by 0.9 mm (audit caught it) → tangential entries. The 3-magnet web layout died because its washer recesses don't fit on the deck. |
| D031 | 07-31 | **RL kit v1.1: per-episode DR draws from stored base values (v1 friction randomization COMPOUNDED across resets — a random walk, not a draw), + mass/torque/gravity-tilt/action-latency randomization, per-episode command sampling (`--cmd-sample`), yaw-rate tracking in the reward.** First real training run launched in-session. | The compounding-friction bug means session-4's smoke ran on drifting physics. v1.1 draws each episode from clean bases. Command sampling turns the residual policy into one conditioned controller for the whole (vx,vy,wz) envelope — the command was already in obs. In-session run (4 async envs, ~1000 sps on 2 container cores): episodic return 39 → 74+ by ~500k steps under full DR — the kit demonstrably learns; the laptop overnight run is `train_ppo.py --num-envs 8 --cmd-sample`. |
| D032 | 08-07 | **Measured fit numbers have TWO sanctioned application paths: params regen (canonical) and slicer XY-hole compensation (weekend fallback).** The GO/NO-GO table (now in `docs/PRINT_PLAN.md`) maps fit-ladder outcomes to a PrusaSlicer hole-compensation value so a print weekend proceeds without a Claude session; the numbers STILL get filed in NOTES_INBOX and baked into params at the next regen. | Session 6 status: printer fixed, nothing printed, nothing ordered — the constraint is the owner's weekend, not CAD. A +0.05–0.10 mm hole compensation is the same physical correction as a params bump for BORES; it is NOT equivalent for pegs/slots/walls, which is why regen stays canonical and the fallback is explicitly bores-only. |
| D033 | 08-07 | **Plate-layout audits (edge margin + feature-to-feature min-wall) are mandatory module checks for any multi-feature coupon/plate.** `part_fit_ladder.py` now asserts ≥1.5 mm edge margin and ≥1.0 mm wall between all features incl. slots. | The v1 fit ladder SHIPPED with its Ø4.8 heat-set pocket merged into a lip slot (wall broken open → that pocket would read falsely loose). Found in session 6 by a section-slice pass; renders never showed it — the D014 lesson (slices + booleans over renders) applies to flat plates too. |
| D034 | 08-07 | **The cliff detector's stop path IS the safe-stop primitive: `ReflexSupervisor.request_stop()` routes any external halt (VOID, operator stop, watchdog) through PLANT→BRACE→RECOVER-to-idle.** Adopted after `sim/experiments/run_cliff_safestop.py` measured it against the old path. | The old path (retreat → command v=0) leaves the bare WaveGait MARCHING IN PLACE at the cliff edge — 24 post-halt contact breaks in 4 s, feet lifting one at a time next to a void. With request_stop: **0 contact breaks**, same stop margin (185 vs 188 mm), lower peak tilt (0.49° vs 0.68°), and the detector still fires with the supervisor owning ctrl. Same primitive now serves the MCP `stop()` tool. **Since D063** a zero command is the standing pose, so the bare halt no longer marches (0 breaks). **RERUN 2026-09-30** (`87215110e9c4`, B112: the safe-stop judged on its own): PASS, 5/5 feet on the deck (the leading foot 46.2 mm short of the edge), 0 breaks, still, BRACE → RECOVER → NORMAL in 0.65 s, stop margin 228.8 mm (bare halt 213.5); the no-retreat control fails. |
| D035 | 08-07 | **Expressive gesture poses are authored in JOINT space, inside the real joint ranges — never as position waypoints IK'd near the limits.** | The beckon v1 curl (60 mm position-space) IK'd to hip 98–117° against a +90° joint limit: both curl extremes clamped to nearly the same pose and the rendered arm DIDN'T MOVE (caught by comparing extreme frames — the render looked plausible in stills). Bonus find: fist-bump's _CARRY/_EXTEND waypoints also IK past the hip limit — the shipped video rides the clamp benignly, but hand-v0.3-era retuning should re-author them in joint space too. |
| D036 | 08-30 | **Every printable part must be exactly ONE solid (`len(part.solids()) == 1`), with an attachment probe at each joined feature; a module's `__main__` exits nonzero on a failed check, so `run_all_checks.py` enforces it.** | The hand hub shipped two releases with all six hinge lugs floating 4.3 mm above the hub (six 146 mm³ islands in the slicer), found by the owner at the printer. Interference checks cannot see this: a disconnection is the absence of overlap, so "CLEAN" was the bug. Fixed with a knuckle collar (cam × hub 0.00 mm³); tree CI 20/20. |
| D037 | 08-30 | **The single-solid gate lives in `common.export()`: every export raises unless the part is one solid; only assemblies and posed previews pass `multi=True`, explicitly at the call site.** | The first tree-wide audit found six more printables shipping as disconnected bodies (tool_scoop, coxa_fork, shell_sector, stand_section, battery_sled, jig_column), each passing its own interference checks; three were a part placed against another part's envelope instead of its own. One chokepoint means no module can forget the gate, and `multi=True` is greppable. |
| D038 | 08-30 | **Print physics is a CAD CI stage: `cad/check_printability.py` slices every printable STL in its prescribed orientation and fails on an island where the plan says "no support", a part floating above the bed, or a wall < 0.8 mm persisting ≥ 1 mm; support islands, overhangs and < 1.6 mm walls are warnings the print plan must answer.** | The first run over 51 parts found `coxa_fork` floating 2.5 mm above the bed (and its floor covering all four horn screw holes since v0.1), carapace tiers that were sealed chambers with 80–100 mm bridges, a 0.8 mm skin and a plate on a knife-edge; the gate was regression-tested against the pre-fix STLs. The cantilever rule followed in session 8f (B21). |
| D039 | 08-30 | **Sim masses come from the CAD tree: `sim/mass_audit.py` (STL volume × material × fill factor + `params.mass_hw`) writes `sim/mass_budget.json`, which `build_mjcf.py` and the URDF read. Push numbers are quoted in bodyweights from here on.** | The old budget had the legs heavy and the torso light (coxa 140 → 86 g, torso 1350 → 1462 g; robot 3.05 → 2.65 kg est.). In bodyweights the push envelope did not move (walking min 1.17 → 1.19 BW, stance 1.54); only the newtons fell ~13 %. Every `mass_hw` value is VERIFY until a scale weighs it. **Push re-baseline SUPERSEDED by D048/D052a**; the mass pipeline stands. |
| D040 | 08-30 | **Gesture library v2 (`gait/pebble_gestures2.py`: wave, bow, look_around, shake, sit, turn_in_place, sidestep) ships with a static-stability self-test (body origin ≥ 15 mm inside the planted-foot polygon) and a physics harness (`sim/experiments/run_gestures2.py`) that must show each gesture's signature metric happened.** | The D035 rule, mechanised: bow pitches 4.5°, sit drops 54 of 56 mm, turn yaws 80°, sidestep travels 170 mm; all seven 0 unreachable targets, tilt ≤ 4.5°. Found while authoring: body yaw with planted feet costs ~2× at the coxa (16° of body = 33° of coxa). Since D052 every gesture also passes the feasibility checker. **RERUN 2026-09-26** (the D052 envelope): turn 48°, sidestep 140 mm, bow 4.31°, sit 54.6 mm; 7/7 clean. |
| D041 | 09-01 | **Recovery reward v2: success IS the handoff criterion** (`RecoverEnv(reward="v2")`: tilt < 25° and h > 0.09 m held 0.5 s ends the episode with the bonus; feet pay only while upright), one criterion shared by the env, `eval_recover` and the reflex FALLEN branch; v1 stays selectable to reproduce recover1. | v1's success never fired in 2 M steps (ep_len pinned at 300): the policy optimised shaping toward a bar it could not reach and learned to prop on ~1.5 feet because feet paid nothing. Train the criterion you will hand off at. **AMENDED by D052**: the handoff is `handoff_ok` (tilt + ≥ 3 foot switches + joint-angle height). |
| D042 | 09-01 | **ReflexSupervisor grows FALLEN and RIGHTED states** (`gait/pebble_reflex.py`): tilt > 60° held 1.0 s → FALLEN (a pluggable `righter` callable commands joint targets; the supervisor stays torch- and sim-free for the Pi); the handoff criterion held 0.5 s, or a 10 s deadline → RIGHTED (a smoothstep ramp to the planted stance) → NORMAL; a re-fall during the ramp re-enters FALLEN. | First end-to-end run (`sim/experiments/run_reflex_fallen.py`): shove → tumble → righted → walks away, 5/5 seeds. The 1.0 s confirm matters: braces spike tilt past 60° transiently and must not surrender to the righter mid-save. **AMENDED by D048** (+ a 3 s stall ramp) and **D052** (handoff = `handoff_ok`). **RERUN 2026-09-26**: fell 4/5 (seed 4 braced and stayed up); all 4 righted 4.8–4.9 s after FALLEN and walked 0.47 m. |
| D043 | 09-01 | **`scan_summary` is live in every sim world** (`SimBackend`: the sim_lidar ray fan, 8 map-frame sectors + nearest + frontiers), **`ROCKY_WORLD=room` binds the sim_lidar room, and the result carries its own honesty note: a 2D horizontal scan cannot see voids; cliff safety stays the foot-contact guard.** `sim/experiments/run_patrol.py`: the first mission built purely on the tool surface (goto / scan / say), 5/5 waypoints. | A sensor that exists and says what it cannot do beats a refusal: the absent-tool > lying-tool rule, third form. Patrol scans cross-check the geometry (north wall at 0.737 m from y = 0.55, exact). |
| D044 | 09-01 | **Torque re-audit on D039 masses (`sim/torque_audit.py`): the servo-sizing driver is SELF-RIGHTING, not manipulation.** Robot 2840 g. Walking 12–16 % of ST3215 stall; untucked-carry hip 17 %; the one warm number is the recovery knee push (W/2 through one crouched leg): 1.47 N·m = 50 % of ST3215 / 30 % of STS3250. Buy recommendation: 10 × ST3215 + 5 × STS3250 knees + a spare, ≈ $585 (buy line superseded by D058). ST3215-HS rejected (20 kg·cm). | D015's 43–65 % manipulation case evaporated with real masses (the femur is 15.7 g, not 30). Static holding torques only; dynamics ride on top and the bench re-baselines. The torque table stands. **RERUN 2026-09-26** (`7d376178fe27`, 2850 g): knee 1.459 N·m = 49.6 % of ST3215, labelled WARM (the pre-rerun record read 1.488 N·m, 50.6 %, HOT). **D062** (`1f953c89f979`): 1.48 N·m, 50.3 %, HOT by a point. **D063** (`87215110e9c4`, 2727.7 g): 1.496 N·m, 50.9 %. **B106** (2026-09-30): the audit had weighed 2920.7 g, the five hands counted twice; on the MJCF's 2727.7 g the knee is **1.397 N·m, 47.5 %, WARM** (28.5 % of STS3250), every stance case × 0.934. **D064** (2843.0 g, the battery in the keel tub): 1.456 N·m, 49.5 %, WARM. |
| D045 | 09-01 | **`recover1` remains the shipped righter; the v2 retrain (`recover2`) is a recorded NEGATIVE with a diagnosed cause and a shipped fix** (`train_ppo --log-std-max`, a cap on the policy's sigma). | Same 20 seeds: recover1 12/20 vs recover2 2/20 (hold-pose 2/20). With clip(±1) + the rate limit, wide actions are a strategy: sigma kept rising even with ent_coef 0 (13.8 → 22.1 nats) while the deterministic mean decayed. Lessons: training success ≠ a deployable policy when sigma is a controller; evaluate the MEAN early. The capped retrain was negative too (BUILD_LOG 8e). **Numbers re-measured**: 10/20 on the laptop, 7/20 on the D047 model (D048), 5/20 legacy / 0/20 `handoff_ok` (D052a), **RERUN 2026-09-26** 4/20 / 0/20; the decision stands. |
| D046 | 09-17 | **The leg chain is rebuilt around its five JOINTS, and a joint suite (`cad/check_assembly.py`) is a CI module:** for every joint it asserts the assembly order (each part arrives along an open path, driver columns clear of everything present), alignment across both parts, the thread / nut path, and capture (a 2 mm nudge meets material). Parts: a bolt-on crown cap over an M3 axle, couplers on both femur hubs, lips + straps, blank v0.2, four joint coupons. | The owner's first dry-fit: nothing past the first servo connected. No assembly order existed for the coxa stage (every yaw-horn screw under the crown arm) and the femur hubs had no location. D036–D038 checked overlap, solids and print physics, never whether two parts can be brought together. **Leg parts SUPERSEDED by D047**; the joint suite stands. BUILD_LOG 8f. |
| D047 | 09-22 | **The leg chain is rebuilt around the REAL servo, modelled from a measured STEP (`cad/ref/STS3215_03a.step`, SO-ARM100, Apache-2.0) instead of a datasheet box.** The yaw servo sits shaft-down in a cup on the I1 base; one C-fork rides the horn below and the idler above (no bearing, cap or axle); a twin-plate femur (plate A on couplers, plate B on idlers); a knee cup on the tibia; every servo held by four self-tappers in its own rim holes (`servo_mount.servo_cup`); slotted coupler holes; the cable plugs a keep-out; hip axis `params.leg.hip_axis_z` = 61. Deck, shell and I1–I6 untouched. | The 09-22 review found servo model v0.1 wrong in five ways (height, axis, horn height, hole pattern; no idler, rims or plugs), so every D046 leg part fit a servo that does not exist. CI 23/23, mass 2665 g. Follow-ups: D059. `docs/archive/REVIEW_2026-09-22.md`. |
| D048 | 09-23 | **A shove is a hand shove, not a strike: `sim/shove.py` applies a half-sine at the carapace's top rim (the force at the CoM + the lever's torque), reported in N·s and bodyweights; the demo is 40 N × 0.4 s = 10 N·s, 1.5 BW. The supervisor gains a STALL rule: no 10° improvement of the best tilt for 3 s → ramp now.** Also: BRACE holds its feet while airborne, the playground feeds tilt to the supervisor, reward `v3` + a per-checkpoint `--rate-limit`. | The old push was a 30 N·s strike (9–11 m/s, 11–15 m of flight). The jitter was `recover1` (73 % of tick moves pinned at 5 rad/s: a 50 Hz staircase) and BRACE flipping its goal in the air. From the back, where every rim shove lands, the ramp rights 5/5 and no policy does; two v3 retrains negative. **Envelope re-measured in D052a.** **RERUN 2026-09-26**: the demo fell 4/5 (seed 4 braced); all 4 righted. SIM_GUIDE, RL_GUIDE. |
| D049 | 09-23 | **The cockpit: a browser playground on ONE running sim (`sim/cockpit.py` + `cockpit_ui.html`, `./rocky.sh cockpit`).** A sim thread owns physics (the Playground loop + goto + the cliff detector) and renders a chase and a torso-eye camera to MJPEG; the HTTP API, the chat brains and the MCP proxy reach it through a job queue. Brains switch at runtime (talk, any OpenAI-compatible model server with tool calling, Claude); `look` sends the eye frame to a vision model; `sim/world_builder.py` composes worlds at runtime. | The MuJoCo viewer can host neither a UI nor a second camera, and its key bindings fought teleop; a browser does it all with nothing installed. One sim for every driver: `harness/server.py` picks a running cockpit (`ROCKY_BACKEND=auto`). `look` is a model's words about a rendered frame, not a sensor. `docs/COCKPIT_GUIDE.md`. |
| D050 | 09-23 | **Contact-seeking stance: a planted foot without contact feels for the floor (down 30 mm at 120 mm/s, `Playground._probe`), and a void is a foot that ran out of probe (`CliffDetector.update(..., probed_out=)`).** The goto crosses rough terrain, rubble and 4 × 15 mm stairs and still stops at the cliff edge; a 6 cm box ends it `stuck` (no progress for 6 s; 40 s = `timeout`). Same round: recordings + replay, saved and random worlds, the residual walker as a gait, voice, `cockpit-stop`. | Two wrong rules first ("reached below the ground" never fires with position servos; "held above ground" fires on bumps), both caught by re-testing the cliff preset after every change. Probing turns missing information into a measurement the real robot can make with its foot switches. SIM_GUIDE. |
| D051 | 09-24 | **The cockpit becomes the bench-side tool:** gestures as keyframe files (`gait/pebble_keyframes.py`, `gait/gestures/*.json`, a studio), chord words designed in the browser (`audio/custom/`), a servo realism model (`sim/servo_model.py`: bus-rate hold, latency, slew, quantisation; on by default since D052), and a hardware bridge (`sim/hw_bridge.py` over `rocky_driver`) that mirrors the sim to whichever legs answer the bus scan, with jog, limp, calibration into `bench/calibration.yaml` and ID assignment; `rocky.sh tailnet` serves the cockpit over HTTPS. | A leg on the bench needs the sim leg's exact command, the bench scripts' calibration model, a sim that stops flattering the servo, and content as files the bus can play. The mic API refuses an insecure origin, hence HTTPS. Verified on the mock bus only. COCKPIT_GUIDE. |
| D052 | 09-24 | **The sim stops flattering the servo; the studio cannot author what the robot cannot do; the bus gets a safe first move.** One servo identity in params (`gait/rocky_model.py`); damping = stall / no-load, foot μ 0.8; gait T 2.0 s / step 24 mm with `WaveGait.budget()` on every command source (45.5 mm/s, 0.246 rad/s in place); one feasibility checker (`gait/pebble_feasibility.py`) gating gestures, keyframes, the studio and `compose_gesture`; an always-on loop (void guard, touchdown gate, trip latch, NaN hold, 4.7 rad/s clamp); RL obs v2 + `handoff_ok`; the bridge's soft first move and whole-leg fault cuts. Torque and heat: D052a. | A 29-finding review: nothing checked what a command asked of a joint (fist_bump 14.8 rad/s vs 4.7 no-load), the righter was scored on an ideal actuator, the bridge would enable torque toward a stale goal. Numbers: BUILD_LOG 9f, SIM_GUIDE, RL_GUIDE. **Envelope AMENDED by D063**: 34.2 mm/s / 0.185 rad/s. |
| D052a | 09-24 | **D052 amended (the owner's ruling): the MJCF clips at the servo's PEAK torque (stall 2.94 N·m; claws 0.23 N·m with their own DC-line damping) and the continuous 0.65 × stall is a thermal model** (`rl_common.ThermalProxy`: heat from the motor current τ − D·ω, judged as RMS; 3 min at 0.85 × stall trips) in both RL envs, `audit_gestures` (`THERMAL_LOAD`) and the live sim (sim → robot refused past the budget). | The 1.911 N·m clip capped an unloaded joint at 3.05 rad/s, below the 4.7 no-load. Re-measured: nothing moves in normal operation; `recover1` 0/20 `handoff_ok`, system 20/20 vs 11/20 with no righter; the standing shove floor is 29 N (1.11 BW), not D052's 30–35 N. A 1° cliff grid still finds a lip band (7 of 310 falls, strict xfail). BUILD_LOG 9f, SIM_GUIDE. **D063** (the soft swing + the command slew, 364 approaches): 8 fall, all at 9–15°, none after the void fires (11 before a held late foot's probe went to a 7 mm lead). |
| D053 | 09-24 | **The robot's shape is data (step 1 of the robot-as-data plan, `docs/DESIGN_CHANGE_GUIDE.md` §9), zero behaviour change:** params `robot:` (legs, the yaw / hip / knee chain, the foot, the claw as a tool, the IK solver; every number a YAML alias of an existing key) → `rocky_model.robot()` builds a frozen `RobotSpec`, `validate()` refuses what the code cannot honour yet, and `build_mjcf` / `generate_urdf` read stations, leg count and actuator order from it. | `pebble.xml` and the URDF byte-identical; 24 spec tests. A 6-leg params already compiles a 24-actuator MJCF, but RL, the mass audit and the analytic IK still assume five 3-joint legs: steps 2–10 (B36). How to change the design today: `docs/DESIGN_CHANGE_GUIDE.md`. |
| D054 | 09-24 | **Talk to it:** speech 18–20 s → ~1 s per command on a small CPU whisper server (base.en, 8 threads, greedy), hold-or-tap mic, hands-free listening, a fuzzy wake word; Qwen3.5-9B + mmproj as the all-in-one brain (7.2 GB, 57.7 t/s, tool calls 0.2–1.5 s); `find_object` turns a vision model's BOX into bearing and distance through the eye camera's pose (0.7°, 3 cm); a scene memory (`sim/scene_memory.py`) with a situation line per turn; chord reactions; the phone-first front end. | Each fix was measured before it was written down. A 3B vision model plus the known camera pose beats a 26B asked to estimate (10–15° off); a VLM is not a cliff sensor (1–3 of 4). B34's first obs-v2 retrain: negative. `docs/BRAINS.md`, `docs/COCKPIT_GUIDE.md`. |
| D055 | 09-25 | **Brains are installed and measured, not assumed; stop never waits for a model; relative moves are a tool.** `rocky.sh brain-install` files a downloaded GGUF + projector under the models dir (`ROCKY_MODELS_DIR`) and registers it unmeasured; `rocky.sh brain-bench` scores one model at a time (20 spoken lines, describe turns, the vision cases) in its own cockpit. Reference-setup picks: `qwen3.5-9b` default (17/20), `qwen3.5-4b` small (16/20), `gemma-4-12b` the Gemma option (box order per model); the 26B and the 3B eye are not brains. Every operator line meets the stop words before any model; `move(forward_m, left_m)`. | A model's own stop handling cannot be trusted (both Gemmas answered "stop" with a chord), and a 3B asked for trigonometry went 96° off. Numbers: `docs/BRAINS.md`. |
| D055a | 09-25 | **A per-family prompt note is worth more than a bigger model: explicit numbered rules (stop = stop only; ONE tool, called before any text; one sentence after; chords for greetings and feelings) lift Gemma 12B from 17/20 to 20/20 and Qwen3.5-9B from 17/20 to 19/20 on the brain bench, with no missed stop and lower latency; thinking ON drops the 12B to 16/20 at 13 s median.** | `FAMILY_NOTES` in `sim/cockpit_brains.py` (prefix-matched on the model id, on by default for `gemma` and `qwen3.5`, `ROCKY_FAMILY_NOTES=0` off; `ROCKY_THINKING_MODELS` lists ids that get `enable_thinking`). The system message is rebuilt per model in the fallback chain, so a text fallback never inherits another family's note. Roles unchanged (the 9B stays default on latency and VRAM; Gemma 12B is the accuracy option). Rows in `docs/BRAINS.md`. |
| D056 | 09-25 | **Tools are data: one registry, `harness/capabilities.py`, generates the local-brain schema, the cockpit's tool list, the MCP server's live list (`tools/list_changed`) and `docs/TOOLS.md` (CI-checked); zero behaviour change.** 19 `ToolSpec`s at D056, 23 with D057's place tools (`turn` is executor-only); a snapshot (`build()`) carries the live gesture and chord lists, the capabilities (`eye`, `memory`, `cockpit`, `places`) and the envelope from `WaveGait().max_command()`. | The tools lived in four files with 17 disagreements. Zero-change proof: the old surfaces were snapshotted and reproduced byte for byte, pinned by `GOLDEN` (`harness/test_capabilities.py`). Adding a tool: one `ToolSpec` + its handler, regenerate `docs/TOOLS.md`, update `GOLDEN`, `_BUILD_TOOLS_BEFORE` and `EXTRA_BEFORE_SHA` in the same commit (DESIGN_CHANGE_GUIDE §8). |
| D057 | 09-25 | **Places are recognised from what the robot senses, never from the world's name: `sim/place_memory.py` compares a lidar signature, a look-description embedding and (on the real robot) a Wi-Fi fingerprint with every stored place and answers known / new / ambiguous with a confidence; no single sense can say known (a lone sense caps at 0.725), and a change is declared only when two looks from different angles agree.** Off by default (`sim/cockpit.py --recognize`); four place tools only while it is on. | A world's name is ground truth a real robot never has. `sim/place_bench.py`, second run: 21/21 verdicts, 0 wrong "known", changes 3/6 (an added object is never confirmed, B38). Every sim number is an upper bound for a real camera and puck. `docs/PLACES.md`. |
| D058 | 09-26 | **The 2026-09-22 review's electronics calls, now one BOM (`bom/BOM.csv`): 16 × ST3215 12 V (15 joints + 1 spare, no STS3250); the Pi + Bus Servo Adapter (A) is the bus master (D003), the Waveshare ESP32 Servo Driver a bench tool; BNO085 on SPI; SCS0009 hands on their own 6 V UBEC (D016); 12 V fans out per leg at the coxa; XT60 loop key + LiPo alarm; one soft-case 3S 5200 ≤ 138 × 46 × 25; LDRobot D500 lidar.** | Supersedes D044's buy line (the worst knee load is 50 % of ST3215 stall) and D024's pull (190 g vs 45 g; the LD19 kit is discontinued). UART-RVC has no gyro rates and a Pi's I²C mishandles clock stretching; servo pins carry 2 A; hard cases (~37 mm) miss the 30 mm bay. Priced 2026-09-26: bench kit $279.94, core robot $1,257.91 (`bom/totals.py`). |
| D059 | 09-26 | **The D047 follow-up CAD fixes: the leg harness gets a channel and the star board a real seat.** An 11 × 11 mm channel through `coxa_yaw_base` from the frozen I1 cutout, under the gearbox plateau and beside the cup on the −Y side, to the yaw plugs (`part_coxa.harness_path()`; six `check_assembly` leg-harness checks, incl. clear of the leg over the whole yaw range); the star-board bracket v0.2 on existing deck grid holes (0,20)/(0,40), checked by `part_busboard.layout_audit()`; byte-stable exports; params `print.bed_mm` and `interfaces.battery_sled.xt60_panel_mm`; `run_all_checks` 28 modules (32 with `--derived`). | The 2026-09-26 audit found the D047 base covering the deck's cable cutout and the bracket bolted to a hole the deck does not have. −Y because the hip cup and plugs sweep +Y at yaw +40°. Torso 1448.9 → 1435.2 g, fingerprint `7d376178fe27`, `params_rev` D059 (B53). |
| D060 | 09-26 | **The repo goes generic and condensed.** Machine settings live in a git-ignored `rocky.env` (template `rocky.env.example`), read by `rocky.sh` and `sim/envfile.py`, the environment winning; the D055 model ids are the reference setup's defaults. One-off experiments move to `sim/experiments/`, rerun 2026-09-26 on `7d376178fe27` ([its README](../sim/experiments/README.md#the-current-record): the record and the verdicts that moved), shared helpers to `sim/scenes.py`; one BOM (D058); docs consolidated, history in `docs/archive/`. The driver decodes sign bits per register (VERIFY-ON-BENCH); the watchdog's `RetryPolicy` ladder is derived inside the D052 envelope. | A 209-finding audit (BUILD_LOG 9i): one machine's paths, keys and model ids were baked into code and docs; the old retry ladder had no speed envelope. The budgeted ladder crosses 40 and 45 mm rubble 2/4 (B54). |
| D061 | 09-27 | **FreeCAD joins the CAD loop as a checker and a viewer, never as a second source of geometry (build123d + `params.yaml` stay the only one).** (1) `cad/fem_check.py` (`rocky.sh cad-check --fem`): linear-static FEA of the five load-bearing leg parts (gmsh + CalculiX, which the FreeCAD Flatpak carries) under **servo-limited loads**: the foot force at the nominal stance that brings the first servo in the chain to stall (vertical 60.3 N, knee-limited; radial ±16.4 N, hip; lateral ±39.2 N, yaw) and stall torque on the horn coupler; judged against printed-PETG allowables (`params.fem`, VERIFY) as von Mises and as tension ACROSS the layers of the print plan's pose, 99.9th percentile outside the grips, SF ≥ 2 passes. (2) `rocky.sh cad-open` opens STEP files, and a result wrapped in a FreeCAD Analysis, in FreeCAD, where the MCP add-on lets Claude inspect it. (3) `cad/gen_drawings.py` (`rocky.sh cad-drawings`, part of `--derived`): an A4 TechDraw sheet per leg part (three views + iso, extents, a hole table read from the solid), redrawn only when the STEP changes. | A servo cannot push harder than its stall, so the stall-limited foot force is a real upper bound for every static case, and impacts past it back-drive a servo (the SF target covers them). The solver matches beam theory (4.26 vs 4.20 MPa, 2.655 vs 2.667 mm). First run: base 2.93, fork 3.03, knee carrier 3.92, coupler 7.81 PASS; **femur 1.22 FAIL** (1.16 on a 6× mesh) in the lateral cases, torsion of the open twin-plate section, and plate B's M3 holes break out of the rails (B74). FreeCAD 1.1 traps: a bare `.frd` will not open without an Analysis; the page exporters need the GUI (`QT_QPA_PLATFORM=minimal:enable_fonts`); TechDraw's PDF bytes change every run. `cad/out/fem/FEM_REPORT.md`, `cad/out/drawings/INDEX.md`. |
| D062 | 09-27 | **B74 and B72 applied: plate B gets a deck over the bridge and 8 mm rails, and the battery pack limit narrows to 44 mm.** Plate B's deck (x 21–52, \|z\| < 11) closes the femur into a box with plate A, the bridge walls and the two servos; the rails go 6 → 8 mm; the four M3 holes now sit in solid plastic (a new `part_femur` check: a 1.5 mm ring round each is material) and take M3 × 12 (BOM A-18). `interfaces.battery_sled.pack_w` 46 → 44, so the sled is 48.8 mm in the 50 mm bay, and `part_battery` now fails when sled + pack exceed the bay. `params_rev` D062, fingerprint `1f953c89f979`, robot 2694.6 g (+37.9). | `fem_check`: femur 1.22 → **2.18** (knee deflection 4.5 → 1.06 mm), all five leg parts pass. Re-run on the new model: walk 247 mm, turn 55.4°, standing shove floor 30 N (1.13 BW; was 29 N), walking 24 N (**corrected in D063**: the committed `shove_envelope.json` says min 20 N = 0.76 BW, mean 29 N); the knee self-right push 1.48 N·m, 50.3 % of stall (HOT by a point); `recover1` system 20/20 (11/20 without), hw 0/20, unchanged; gestures 20 rows, 0 FAIL. The BOM's soft pack (43 mm) already fitted 44. Bench kit $284.94 with A-18. |
| D063 | 09-28 | **The assembly guide's CAD faults are fixed where one part owner could fix them, and the motion stops snapping** (the owner: "fix the fork ... do everything you can on yours"). The coxa fork slides onto the yaw servo: the idler pocket, its head relief and a horn-head channel open out through the C's mouth (B80); the horn face bears on a flat hub top (B81 b); two 3 mm side cheeks carry the inward foot push the open mouth lost. The I1 knob takes an M3 × 16 hex head (B82); the I6 ring's male is an undercut dovetail clamped at its flank (B83); the I3 latch is a bayonet turned from under the deck (B87); the hatch magnets have seats (B88); the Pi standoffs are 58 × 49, 11 mm tall, and the IMU pad fits the BNO085 (B89, B90); `link_clip` fits the D062 femur (B94). Motion (B76 fixes 1, 2, 3, 8): a soft-landing swing (`pebble_gait.swing_profile`, a `KINK` verdict); a command slew (`CommandSlew`: 25 mm/s² on the fastest foot, then a 0.2 s lag) in the supervisor's normal and recover states, the playground, the harness sim and `gait_node`, never on a stop and not in the RL envs until a retrain; a per-tick goal speed on the bus (1.3 × the goal step, never 0); a minimum-jerk keyframe ease; `register_dump` reads addr 0–87 (B79). `cycle_time` stays 2.0. The body layout (B51, B84–B86, B92, B93) is a proposal, not built. `params_rev` D063, fingerprint `87215110e9c4`, robot 2727.7 g (+33.1). | B80 blocked the leg print, B87 left every panel on its magnets, and the servo notes (B76) found most of the jerkiness was software. The reviews caught three things: the open mouth left the inward push (R−) no wall, SF 0.49 on the horn face alone, and the cheeks (+27.5 g a robot) bring it to **2.47**, the fork's governing case (3.03 at D061); the slew's ramps crossed the loaded 3.0 rad/s budget (worst 3.036) until the lag (0 of 1440 ramps fail, worst 2.992); the new ease pushed `point_there` to 4.02 rad/s until its tail moved 4.5 → 4.7 s. **The cost:** the soft swing lifts fastest inside the 15 mm loaded band, so the envelope fell 45.5 → **34.2 mm/s** and 0.246 → **0.185 rad/s** (walk 247 → 189 mm, turn 55.4 → 41.8°). Lift-off / touchdown velocity step 3.05 → 0.003 rad/s; a start 28.4° → 3.38° per tick; shove floor 30 N = 1.12 BW standing and, shoved at a steady 34.2 mm/s, walking (D062's walking 20 N was a steady 45); knee self-right 1.496 N·m, 50.9 % (HOT; **corrected by B106**: the audit counted the hands twice, on the MJCF's 2727.7 g it is 1.397 N·m, 47.5 %, WARM); `recover1` system 20/20, hw 0/20; gestures 19 rows, 0 FAIL; lip band 8 of 364 (9–15°), none after a fired void guard: a late foot held by the touchdown gate now probes with a 7 mm lead (`PROBE_HOLD_LEAD_MM`; 11 with 3.5, three of them tipping while backing off); CAD 35/35, byte-stable. **Owner decisions pending:** `cycle_time` 2.2 (39.8 mm/s / 0.215 rad/s, B103); the body layout, option A recommended, 13 decisions in [the proposal's §8](archive/BODY_LAYOUT_PROPOSAL_2026-09-28.md#8-decisions-only-the-owner-can-make) (an I4 / I5 revision among them; **built as D064**). On the bench before trusting: the goal-speed sag (B98), the 0.2 mm cam bite (B99). BUILD_LOG 9m. |
| D064 | 10-07 | **The body layout is built from the owner's 15 picks (option A).** A keel tub 8 mm under the deck (`cad/part_bay.py`: tub, lid and door; the female XT60's carrier printed into its nose, the loop key over it, no strap, a 2 mm foam pad, the door held by one I3 latch in a south-wall boss and a north snap hook); a hub shelf under the deck (`part_busboard`: the 30.5 × 30.5 PDB and the star board face-up, the bus adapter, buck and UBEC face-down, the adapter on the Pi's UART); the tray at (0, 0) turned 180° with lugs, a glued latch boss and a slotted strike (`part_avionics`, `iface.latch_strike(frame, slide)`); deck v0.5's 21-hole table; the stand as a cradle for the tub; the I1 seats fix (decision 15) proved by `cad/check_dock.py`; in the sim the belly (tub box, shelf plate box, three post columns), the torso's `<inertial>` from a body-frame mass audit, and the righter's hip clamp at −51.05 on legs 1–4 in FALLEN. D020's I1, I4 and I5 values are revised. Retired: `sled_rail`, `dock_block`, `belly_door`, `belly_skid`, `busboard_bracket`. | Option A was the measured recommendation (D063, prep 9p); each part was built against the real neighbours, re-measured by the integration and reviewed twice. Two picks came out short: pick 4 saved 2.0 mm of tub, not ~10 (the XT60 mate needs the length; `bay_l` 192), so pick 10's chamfered nose still sits 7.76 outside the carapace skirt (B145). The reviews found the docked cup's back wall in every carapace sector (on main too, B124) and that the tray comes out only with the carapace off (B143). `params_rev` D064, fingerprint `87215110e9c4` → `deae868522cc` → `c3e82f13b671` (the shell relief, −0.2 g) → `965f4f70e5d1` (the deck's north tray-tab holes back to Ø2.8, +0.02 g, B155), torso 1439.8 → 1555.0 g at (−2.21, −4.63, −3.18) mm, robot 2727.7 → 2843.0 g. Re-run on `deae868522cc`: walk 189 mm and the envelope 34.2 mm/s / 0.185 rad/s unchanged, righting 197 → 198/200, no righter 87 → 104/200, standing shove 30 N = 1.08 BW, knee self-right 1.456 N·m (49.5 %, WARM); the lip band's 8 falls became tips onto the keel (0 falls, B140). CAD 30/30 + `check_sim_mirror`; every RL checkpoint legacy (B146). **Open:** `coxa_yaw_base` fails the FEM at servo stall on the real I1 support, SF 1.10 (B139): print one for the bench, not five, until the owner picks a fix. BUILD_LOG 9q. |
| D065 | 10-09 | **A body leveler, built and landing OFF (`params.yaml` `level.enabled: false`); flipping it is the terrain bench's verdict, and the verdict is fail.** `gait/pebble_level.py` `BodyLeveler` (numpy, the file the Pi runs) levels the body by RAISING feet: the IMU tilt error, low-passed 0.2 s with a 0.5° deadband, integrates (τ 0.6 s, ≤ 20 mm/s at R0) into a plane of foot offsets in a 0–30 mm raise-only window, evaluated at each foot's xy (`WaveGait.level_xy`), followed per leg at 20 / 40 mm/s, held while a foot feels for the floor and in BRACE, reset by FALLEN, RIGHTED, a gesture and a respawn (a gait change keeps it). The review fixes (wip 4, BUILD_LOG 9r): the law ticks on a schedule (one tick per call on a jittered 50 Hz loop), the copies move on every call (no 50 Hz staircase at 500 Hz), a swing foot is airborne only 2 mm past the band over the ground under its real xy, an enabled leveler primes its derated envelope up front, `apply_gait` no longer resets it. `ReflexSupervisor(leveler=)` opts in (`None` is the D064 supervisor bit for bit; only the Playground path builds one); the envelope derates with the plane (`WaveGait.budget(level_slope=)`: 34.20 → 32.48 mm/s at tan 5°); `pebble_feasibility.margins` honours a `normal` given alone. The sim: `SimIMU` mount error, the IMU read with the sim time (its latency now applies), `Playground(imu=, level=)` / `set_imu`, `level on|off`, `set level.*`, the HUD line, off while mirroring sim → robot, `ROCKY_LEVEL`; `sim/terrain_bench.py` (S0 / S1 / S2, S3 reserved × ideal / noisy / mount1.5 × 87 rows, the rules evaluated in the script) and `sim/experiments/run_lip_grid.py`. `params_rev` D064 and the fingerprint `965f4f70e5d1` stay: control, not physics. **AMENDED by B162 wip 1 (10-09, BUILD_LOG 9s): `level.filter_s` 0.2 → 1.0, a rough-ground sink cap (`level.rough_r0_mm` 12, `rough_r1_mm` 12, `sink_max_mm` 6, `rough_hold_s` 2), P1 / P4 / P6 restated; still off. AMENDED again by the B162 review round (10-09, BUILD_LOG 9t): the sink cap re-picked on train seeds (`rough_r0_mm` 8, `sink_max_mm` 3, `rough_hold_s` 4, a latch that lets go at the new `rough_off_mm` 4), failing closed (capped) while walking without a probe, 12 held-out rubble seeds per height in the gate, R1 restated for rubble; still off (P4 and P7 fail on the stairs).** | Nothing levelled the body: on 8° it sits at 8.06°, a 20 mm stone leaves 3.88° (S1). The bench (`sim/out/terrain_bench.json`, 1033 runs, `b2bf1b9` + the wip 4 code), S2 against S1, ideal IMU: 5° stand 0.07–0.24°, 8° 2.96–3.22 (saturated), the 20 mm stone 0.36 (the stone foot unloaded in S1 and S2 alike: a four-foot stance), slope walks' tilt RMS 7.59 → 2.91, ramps 5.49 → 2.20, stairs 4.72 → 1.87 (tips 2 → 0), rubble 2.20 → 1.60, the 8° shove's peak 12.08 → 5.15; a straight flat walk bit-identical, a turn, a walk + turn and its stop, a rim shove not (0.36–0.92 mm left, 11.65 against the probe's HOLD after the turning stop, B163); no fall, no belly contact, load ≤ 0.261 × stall; the cliff grid 10/10 and the 5° slope cliff 6/6 held (the void foot raised 30 mm walking uphill). The lip grid: see BUILD_LOG 9r. Rules (ideal + noisy gated): **pass** P2 (stone ≤ 1.0°), P3 (8° ≤ 3.5, 5° ≤ 0.6), P5 (no new falls), P8 (load, heat); **fail** P1 (the plane drifts 1.19–1.68 mm on a noisy flat walk against 0.5, and the new flat-motion rows are not bit-identical in ideal), P4 (27 row × IMU pairs under 95 % of S1's progress: 16 on the slopes, where the derate alone is 94.97 % on a saturated plane and MuJoCo's stance creep moves the rest, 8 on five rubble rows, 3 noisy stairs rows), P6 (two noisy false voids, 20 mm stairs and 30 mm rubble, ground deeper than the probe reaches with the void foot raised ≤ 0.3 mm: the probe's, B161), P7 (rubble belly clearance 23.5 mm ideal, 24.2 noisy, against 25), R1 (+0.42° on the noisy rubble row that false-voids); P9 is the sim suites with `ROCKY_LEVEL=1`, thin coverage (BUILD_LOG 9r). mount1.5, reported only: it levels to the sensor, 1.045° off on flat (B159). Next round B162; filed B156–B163. **B162 wip 1 (the amendment):** the record above is kept as `sim/out/terrain_bench_d065_off.json`; the new one (`sim/out/terrain_bench.json`, same arguments, every S0 / S1 run bit-identical) has filter 1.0, the only value measured that holds every noisy flat row at 0.00 mm (0.6: 0.33, 0.8: 0.03), at +0.4 s to settle a stone and +0.16–0.32 s a slope stand (the 20 mm stone's end tilt 0.36 → 0.42° ideal, 0.16–0.17 → 0.23–0.51 noisy, against P2's 1.0; the 5° / 8° stands' end tilts held), an underdamped loop (a 3° kinematic plant rests 0.24–0.28° past level, inside the deadband) and more tilt on rough ground; and the sink cap: walking, the probe's roughness (max − min `probe_dz` over the loaded feet, held 2 s, frozen in a planted stance) past 12 mm caps the body's sink at 6 mm (rubble clearance 21.1 / 16.0 → 25.3 / 25.8 mm ideal / noisy at filter 1.0; slopes and stones bit-identical to no cap; the 10° ramp 3.62 → 4.13°, the stairs 2.08 → 2.49°). Restated, each for a measurement that was not what the rule claims (the D065 wording is evaluated beside it, `d065` in the record): **P1** the turn, the walk + turn and the rim shoves tilt past the deadband for real, so they are gated on tilt RMS ≤ S1 + 0.05° and the walk's progress at `stop` within 1 % (the walk + turn is bit-identical to S1 until `stop`; its 14.71 mm after it is B163's), the straight walks and the stand keep every D065 clause; **P4** a walk is judged against S1 × its own derate (the deliberate 94.86–95.03 % of a saturated slope plane was counted as a loss), rubble by its family per IMU mode (chaotic per seed), stairs per row with the trade reported; **P6** a void with the ground deeper than `PROBE_MAX` under the un-probed target on a world with no drop is a `probe_reach` void (B161, a safe stop, S1 has the class), reported, not gated. R1 unchanged. Result: P1–P8 pass, **R1 fails** on two ideal rubble rows (`W4.rubble10.s0` 0.84 → 1.02°, the filter's; `W4.rubble20.s3` 2.12 → 2.25°, the cap's; the family 2.20 → 1.73°), so the verdict is fail and `level.enabled` stays false; under the D065 wording it fails P1, P4 (25 pairs) and R1, passes P6. **B162 review round (the second amendment, BUILD_LOG 9t; the wip 1 record is `sim/out/terrain_bench.json` at `83c0c76`):** a reviewer found wip 1's P7 pass in-sample (held-out rubble seeds 100–111: 21.7 mm ideal, 3 of 12 rows under 25; 24.6 noisy; S1 ≥ 30.1), the cap failing open without a probe (14.8 mm with `probe off`), the stairs cost under-reported (wip 1's noisy `stairs20.p2` tip was the cap's: 7.02° and no tip without it), half of D065's rubble gain given back out of sample, a cap that chattered (20 ms dwells) and an unsigned end tilt that hid the 1.0 s filter's overshoot. Fixed: the cap fails closed (walking with no probe it caps at `sink_max_mm`: 30.5 / 28.9 / 37.4 mm on the review's three rows); it latches (≤ 2 engages per row); it was re-picked on train seeds ≥ 1000 only (12 candidates, 1224 runs; the rule, fixed before the held-out run: the largest worst-case clearance over 30 mm rubble and stairs in both IMU modes, 26.6 mm), then checked once on held-out seeds: 25.1 / 25.7 mm, no row under 25; the held-out rubble rows are now in the bench (36 per IMU mode, P4 per height, P7 per row); the stand's tilt is signed (the 20 mm stone ends 0.43° past level after a 0.72° overshoot, noisy 0.96°). **R1 restated for rubble** (the D065 wording kept beside it): S1 against S1 with only the IMU's noise stream changed moves 23 of 51 rubble rows' tilt RMS past 0.1° (−1.01 to +0.72) while each height's family moves ≤ 0.04°, so rubble is judged by the family per height over both tiers. The record (`sim/out/terrain_bench.json`, 1465 runs, 1099 made, 968 s; S0 / S1 bit-identical to both earlier records): rubble tilt RMS (17 seeds per height) 1.29 / 2.51 / 2.53 → 1.20 / 2.10 / 2.33° ideal (held out 2.07 → 1.90, where D065's S2 had 1.60 and wip 1 1.82), clearance ≥ 25.1 held out; ramps 5.49 → 3.16 (wip 1 2.50); stairs 4.72 → 3.77, tips 2 → 2 (wip 1 2.49 and 0; no cap 2.08 and 0, but 23.0 mm noisy); slopes, stones, flat, shoves and cliffs as wip 1. **Verdict: fail**: P4 (`W6.stairs15.p1` ideal 92.2 % of S1 × derate; `W6.stairs20.p2` noisy 46.5 %, a `probe_reach` stop at 203 mm where S1 walked 440 and tipped) and P7 (`W6.stairs20.p1` noisy 24.4 mm; no cap 26.6 there); P1, P2, P3, P5, P6, P8, R1 pass. Under the D065 wording: P1, P4 (30 pairs), P6 (five new `probe_reach` voids) and R1 (15 rubble pairs) fail. `level.enabled` stays false. The held-out P7 margin is 0.1 mm and no setting measured keeps 2 mm on both 30 mm rubble and 20 mm stairs: a raise-only plane levels by sinking the body, and the probe's roughness cannot tell rubble from stairs or a ramp's kinks (B162 has what it would take). Flip costs beyond the bench, for whenever it passes: after a turning stop the plane's 14.71 mm against the probe's HOLD keeps sim → robot refused until `level off` (B163); the cockpit and the brain, place and vision benches have not run with it on; the level-on lip grid record carries D065's parameters. |
