2BitwiseBard/rocky/cad/out/drawings/INDEX.md

# Part drawings

Generated by `cad/gen_drawings.py` (`rocky.sh cad-drawings`; FreeCAD TechDraw, D061) from `cad/out/*.step`. Do not edit by hand. One A4 sheet per part: first-angle Front / Top / Right + an isometric, overall extents, a hole table and the open channels (half-circle pockets open to an edge; a slot's ends are not listed). For calipers and the print pack, not for manufacture.

| part | sheet | scale | extents W × H, depth (mm) | holes | open channels (Ø × depth) |
|---|---|---|---|---|---|
| blank_idler | [pdf](blank_idler.pdf) | 2 | 19.9 × 5.8, 19.9 | none | none |
| coxa_fork | [pdf](coxa_fork.pdf) | 0.5 | 44 × 75.4, 46.4 | Ø2.4 ×4 (Y) | Ø6.4 × 1.3 ×1 (Z), Ø7 × 0.6 ×1 (Z), Ø20.3 × 1.8 ×1 (Z) |
| coxa_yaw_base | [pdf](coxa_yaw_base.pdf) | 0.75 | 72.5 × 58.5, 44 | Ø2.4 ×2 (Z), Ø3.4 ×2 (Z), Ø3.7 ×2 (Z), Ø5 ×2 (Z), Ø6.4 ×1 (Z) | none |
| femur_link | [pdf](femur_link.pdf) | 0.75 | 125 × 31, 47.7 | Ø2.8 ×4 (Y), Ø3.4 ×4 (Y) | none |
| femur_plate_b | [pdf](femur_plate_b.pdf) | 1 | 121 × 38, 11.8 | Ø3.4 ×4 (Y), Ø7 ×2 (Y) | none |
| horn_coupler | [pdf](horn_coupler.pdf) | 2 | 26 × 5.6, 26 | Ø2.8 ×2 (Z), Ø6.4 ×1 (Z) | none |
| servo_blank | [pdf](servo_blank.pdf) | 1 | 45.4 × 35.6, 24.8 | Ø2.5 ×4 (Z), Ø3 ×3 (Y), Ø6.2 ×1 (Z) | none |
| tibia_knee_carrier | [pdf](tibia_knee_carrier.pdf) | 0.75 | 48 × 50.4, 38.4 | Ø2.4 ×4 (Y), Ø2.8 ×1 (X) | none |
| tibia_sea_outer | [pdf](tibia_sea_outer.pdf) | 1.5 | 19 × 28, 21.8 | Ø10.3 ×1 (Z), Ø13.2 ×1 (Z) | none |
| tibia_sea_slider | [pdf](tibia_sea_slider.pdf) | 2 | 16.3 × 24, 16.6 | none | none |
