2BitwiseBard/rocky/docs/archive/decisions_D036-D057_full.md

# Decisions D036–D057 — full text

*Archived 2026-09-26 from [`docs/decisions.md`](../decisions.md), where these rows are now
condensed to ADR-lite (context, decision, why). Word for word, except that the owner's first
name reads "the owner" and one machine path reads `$ROCKY_MODELS_DIR`. File paths and doc
names are as they were when each row was written ([the archive index](README.md) maps the
renamed ones); later decisions (D058–D060) and the AMENDED markers live in the current log.*

| # | Date | Decision | Why / consequence |
|---|---|---|---|
| D036 | 08-30 | **Single-solid connectivity audits are mandatory module checks for every printable part: assert the built Part is exactly ONE solid (`len(part.solids()) == 1`) plus a finite-volume attachment probe at each joined feature; module `__main__` now exits nonzero on any failed check so `run_all_checks.py` actually enforces it.** First applied in `part_hand.py` (hub/cam/finger). | The v0.2 hand hub SHIPPED (v0.7.3→v0.7.6, two releases) with all six hinge lugs FLOATING 4.3 mm above the hub top — six 146 mm³ islands in the slicer, found by the owner in session 7. Mechanism: v0.2 raised KNUCKLE_Z 4.2 mm to clear the cam disc (the v0.1 clash fix) but nobody re-attached the lugs, and v0.1's lugs were themselves 0.1 mm proud of the hub — they were NEVER attached. Interference checks are blind to this failure class by construction: they detect overlap, and a disconnection is the absence of overlap — "CLEAN" was the bug. Fix: knuckle collar (annular wall r 19.45–22, hub top → lug top, outboard of the cam's swept rim) with swept tab-envelope windows at the stations (the finger tab's upper corner arcs to r≈20.8 mid-open — same by-construction sweep trick as the finger scallops, in reverse); lugs widened to reach it; pin bores lengthened to pass through the collar so pins insert from outside and the far wall retains them. Hub = 1 watertight solid, cam×hub 0.00 mm³, worst finger clash over the 14-pose dense sweep 0.23 mm³, tree CI 20/20. |
| D037 | 08-30 | **The D036 single-solid gate lives in `common.export()` itself: every export raises unless the Part is exactly one solid, and only assemblies/posed previews may pass `multi=True` (explicit, at the call site).** Tree CI 20/20 with the gate live; mesh-level audit of all 66 STLs confirms zero printables with more than one body. | Session 8's first tree-wide audit found the hand hub was NOT a one-off: SIX printable parts were shipping as disconnected bodies — `tool_scoop` (bowl, neck and socket never touched, three pieces), `coxa_fork` (the −X high-collar wall attached to nothing, 0.3 mm from the back wall), `shell_sector` (both web feet + latch pad + magnet floating 13 mm inboard of the skirt), `stand_section` (skirt 0.3 mm from its own tube), `battery_sled` (finger scallop cut the floor through; tail lip severed, touching along one tangent line), `jig_column` (deck-proxy plate 6 mm short of the spine). Plus `fit_ladder`'s row-D index dots engraved inside the slots (non-manifold seam). Every one passed its own interference checks. Putting the gate at the single chokepoint all modules use means no module can forget it, and `multi=True` makes intent auditable by grep. Three of the bugs (fork, stand, scoop-scale gaps) were exactly one `clearance_fit`: a part placed against ANOTHER part's envelope instead of its own — that's the pattern to watch for. |
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
