2BitwiseBard/rocky/bom/BOM.csv

id | phase | category | item | spec_notes | qty | unit_usd_est | line_usd_est | source | price_checked | status | design_ref
A-01 | A bench kit | Actuators | Feetech ST3215 serial bus servo, 12 V 30 kg.cm (ST3215-C047) | Bench leg: yaw + hip + knee + 1 spare. 12 V variant ONLY: listings mix in the 7.4 V 19.5 kg.cm one (Waveshare labels it 'ST3215-7.4V'; order by suffix: C018/C047 are the 12 V 1:345, C001 is the 7.4 V, C044 (1:191) and C046 (1:147) are other gearings). Buy one that ships the ALUMINIUM horns: the couplers are cut for the 20 mm metal disc horn, and Feetech's own C018 sheet lists a POM horn (Waveshare's package shows 2 aluminium horns, a screw bag and a lead). Keep the accessory bag: it answers the horn-thread question (B23). | 4 | 20.63 | 82.52 | Waveshare 12 V SKU 22414 $21.99, $20.63 at 4+ (ships from China; duties on the buyer) https://www.waveshare.com/st3215-servo.htm?sku=22414 (the $16.99 SKU is the 7.4 V one); Waveshare on Amazon $31.99, ships from Amazon https://www.amazon.com/dp/B0B6HSBRGF; Seeed ST3215-C047 $23.99 from a US warehouse, horn material not stated | 2026-09-28 | to buy | actuators.st3215; bus.leg_ids; D002; D047
A-02 | A bench kit | Bus | Waveshare Bus Servo Adapter (A) | The robot's bus path. On the robot it runs over the Pi's UART (header H2, jumper H4 to A), face-down on the hub shelf (pick 14); on the bench over USB-C (/dev/ttyACM0) for rocky_driver, the bench/ scripts and the cockpit hardware bridge. Servo power in 9-12.6 V: in UART mode its logic runs only from that input. | 1 | 4.99 | 4.99 | Waveshare https://www.waveshare.com/bus-servo-adapter-a.htm (Amazon, sold by Waveshare: $12.99 https://www.amazon.com/dp/B0CJ6TP3TP) | 2026-09-28 | to buy | driver/rocky_driver; D003; interfaces.hub_shelf.boards
A-03 | A bench kit | Bus | Waveshare Servo Driver with ESP32 | Bench first-motion tool: its stock web UI (phone on the ESP32_DEV hotspot, 192.168.4.1) scans the bus, sets IDs and moves a servo with no code. NOT the robot's bus master: rocky_driver talks only through the Bus Servo Adapter (A). Input DC 6-12 V: run it from the bench supply at 12.0 V, not a full 3S pack (12.6 V). | 1 | 15.99 | 15.99 | Waveshare https://www.waveshare.com/servo-driver-with-esp32.htm (Amazon, sold by Waveshare: $24.99 https://www.amazon.com/dp/B09SZ41RJW). The General Driver for Robots ($27.99) adds an IMU and DC-motor ports this robot does not use | 2026-09-28 | to buy | D003; bench/BENCH_RUNBOOK.md
A-04 | A bench kit | Power | Adjustable bench supply 0-30 V / 0-10 A with a constant-current limit and an output switch | First contact at 12.0 V with a ~1.5 A limit, then the whole bench leg. Any CV/CC switching supply with an OUTPUT switch (set the limit with the output off; the original SPS-3010 has none). Can later feed the DC-input charger at 24 V. | 1 | 49.99 | 49.99 | Jesverty SPS-3010V (0-32 V 10 A, coarse + fine knobs, output button) https://www.amazon.com/dp/B0DDPVDWPZ; NICE-POWER 30 V 10 A with output switch $42.98 https://www.amazon.com/dp/B0CDW12H3X | 2026-09-28 | to buy | bench/BENCH_RUNBOOK.md section 0; bus.safety.volt_max_v
A-05 | A bench kit | Power | Budget alternative to the adjustable supply: Mean Well LRS-150-12 (fixed 12 V 12.5 A) + inline XT60 wattmeter | No current limit: a wiring fault on first contact sees up to 12.5 A. Use only with a fuse in the lead and the wattmeter watched. Replaces the adjustable supply; not counted in the totals. | 1 | 31.80 | 31.80 | Digi-Key LRS-150-12 $19.80 https://www.digikey.com/en/products/detail/mean-well-usa-inc/LRS-150-12/7705011 (search listing) + wattmeter est $12 | 2026-09-26 | alternative | bench/BENCH_RUNBOOK.md section 0
A-06 | A bench kit | Wiring | Feetech 3-pin servo leads 5264-3P, 300 mm (6-pack) | Per leg: the entry lead (XH-5 pins 1-2 -> yaw, 300 mm, one plug cut off), yaw -> hip (a servo's own 150 mm lead reaches: span <= 58 mm), hip -> knee (300 mm: span 82-105 mm over the joint sweeps), and optionally knee -> hand with its V+ pin pulled (D016). B-14's 12 V splices into the V+ of the lead entering each servo: each ST3215 has two ports, both on the daisy. 15-20 of 24 used; each servo also ships with one 150 mm lead. Whole-robot quantity. | 4 | 1.99 | 7.96 | Waveshare SR-Cable-5264-3PIN-300mm-6PCS https://www.waveshare.com/sr-cable-5264-3pin.htm (Amazon 6-pack $9.59 https://www.amazon.com/dp/B0GVF9G512) | 2026-09-28 | to buy | WIRING_HARNESS; interfaces.leg_port
A-07 | A bench kit | Wiring | 5.5 x 2.1 mm DC barrel pigtails, male (2) | Bench supply into the DC jacks of the adapter and the ESP32 board. Barrel jacks are ~5 A parts: the bench only. Listings mix 2.1 and 2.5 mm pins. | 1 | 7.99 | 7.99 | 14 AWG 2-pack https://www.amazon.com/dp/B0DXV58RDX | 2026-09-28 | to buy
A-08 | A bench kit | Fasteners | PA2.0 x 6 self-tapping pan head screws, pointed tip (100) | Servo rim screws: 4 per cup x 3 cups per leg = 60 for the robot, plus coupons. Same part as 'M2 x 6 self-tapping' (the SO-101 guide drives these into the 1.5 mm pilots). Order the POINTED (PA) tip, not flat (PB). Count the servo bag first. | 1 | 5.69 | 5.69 | METALLIXITY M2 x 6 304 stainless, 100 https://www.amazon.com/dp/B0FJDKDFL6 | 2026-09-28 | to buy | servo_st3215.case_screw; servo_mount.servo_cup; D047
A-09 | A bench kit | Fasteners | M3 x 6 pan/button head (100) | Horn screws: 4 per servo (yaw hub + hip and knee couplers) = 12 per leg, 60 for the robot; + 8 on the hub shelf (the star board 4 + the PDB 4, thread-forming into its standoffs): 68. The servo bag may cover some. Covers A-09/A-10/A-18 cheaper as one button-head kit (6/8/10/12/16 mm x 50, $9.99 https://www.amazon.com/dp/B0BJQ3JBS3) + this bag, since the kit's 50 x M3x6 is short of 68. | 1 | 7.69 | 7.69 | https://www.amazon.com/dp/B0GH6C7BK6 | 2026-09-28 | to buy | servo_st3215.horn_screw_m; part_coxa; part_coupler; part_busboard
A-10 | A bench kit | Fasteners | M3 x 8 pan/button head (100) | Coupler clamps 4 per leg (20). The deck-grid parts it also covered are gone since D064: the sled rails print into the keel tub, the dock block and the star-board bracket retired, the tray-rail tabs take ISO 7380 button heads (B-27). | 1 | 7.69 | 7.69 | https://www.amazon.com/dp/B0GH5RVWYT (or the kit in A-09) | 2026-09-28 | to buy | part_coupler; part_femur
A-11 | A bench kit | Fasteners | M3 x 10 socket head (50) | Tube pinch bolt 1 per leg (5), and the keel tub's 2 lid screws, up from below through the south pilasters into the lid's inserts (D064). NOT the I1 thumbscrews: an M3 x 10 in thumb_knob_m3 ends 0.5 mm above the deck insert (B82); those are A-19. The I6 set knob is the same thumb_knob_m3: it takes A-19 too (D063). | 1 | 6.69 | 6.69 | https://www.amazon.com/dp/B0GCT27WBP | 2026-09-28 | to buy | part_tibia; part_bay
A-18 | A bench kit | Fasteners | M3 x 12 pan/button head (50) | Plate B to the femur bridge bosses: 4 per leg (20). D062: plate B's rails are 8 mm, so an M3 x 12 reaches 4 mm into the 7.2 mm boss bore (an M3 x 8 would reach none). | 1 | 6.99 | 6.99 | https://www.amazon.com/dp/B0GGH1T3BQ (or the kit in A-09) | 2026-09-28 | to buy | part_femur
A-19 | A bench kit | Fasteners | M3 x 16 hex head, fully threaded, ISO 4017 / DIN 933 (25) | I1 leg-port thumbscrews: 2 per port = 10 (the port coupon and the bench jig borrow the bench leg's pair). HEX head: thumb_knob_m3's pocket is a 5.6 A/F hex, 2.1 deep (D063, B82), that keys a 5.5 A/F head and holds all of it; a round socket head spins in it. 16 is the length that reaches: the head sits on the pocket floor 6.5 above the plate, + the 4 mm plate = 10.5 to the deck top, so an M3 x 16 engages 5.5 of the insert's 5.7 mm and ends 0.5 mm inside the deck's underside. M3 x 10 reaches nothing; M3 x 18 pokes 1.5 mm out (under the port coupon it bottoms on the bench). Also the trim-cup screw, 1 per cup: lid + cup is 12.2 mm, so an M3 x 16 goes 3.8 mm into the deck grid. And the I6 set screw, 1 per dovetail_shoe or whisker_shoe (D063, B83): it wedges the undercut male with the knob 6.1 mm off its spot face, 6.0 mm of thread in the shoe (an M3 x 12 hex head, the shortest that reaches, would clamp at 2.1; the BOM keeps one bolt for every knob). 10 thumbscrews + the shoes + the trim cups fit in the 25. | 1 | 6.00 | 6.00 | est | est | to buy | interfaces.leg_port; interfaces.dovetail; part_panel.thumb_knob_m3; B82; B83
A-12 | A bench kit | Fasteners | M2 x 6 pan head + M2 washers (20 each) | Only if the real horn is M2-tapped: the first screw into the horn on coupon_yaw_hub settles it. | 1 | 4.00 | 4.00 | est | est | choice | servo_st3215.horn_screw_m; B23
A-13 | A bench kit | Fasteners | M3 brass heat-set inserts 4.6 x 5.7 (100) | I1 deck thumbscrew pockets (10), bench jig (8), the keel tub's lid: 6 hanger bosses + 2 pilaster bosses (8, D064), plate B bosses if it comes off often (20, B26): 46 of 100. The pocket size comes from the fit ladder (B28). | 1 | 9.99 | 9.99 | ruthex RX-M3x5.7 https://www.amazon.com/dp/B08BCRZZS3 (CNC Kitchen M3x5.7 from Germany EUR 9.40). An insert tip for your iron is $6-17 (Hakko T18, Pinecil/TS100 and T12 sets exist) | 2026-09-28 | to buy | print.heatset_m3_d; cad/iface.py; part_bench_jig; part_bay; B26
A-14 | A bench kit | Consumables | Blue threadlocker + CA glue | Horn screws into the metal horn (metal to metal ONLY: 243 crazes PETG and PC); CA for the blank idlers, the I3 latch housings in their pads (D063) and the magnets. | 1 | 13.43 | 13.43 | Loctite 243 6 ml $9.61 https://www.amazon.com/dp/B004L439FE + Loctite Gel Control CA $3.82 https://www.amazon.com/dp/B0006HUJCQ | 2026-09-28 | to buy
A-15 | A bench kit | Mechanical | Carbon fibre tube 10 mm OD x 8 mm ID x 500 mm, ROLL-WRAPPED (2) | Tibia, ~120 mm per leg: two tubes cover five legs + a spare. Roll-wrapped, not pultruded: pultruded is all 0 deg fibre and splits under the pinch bolt. The cut length is not computed in the repo yet (VERIFY at the tibia stack). | 1 | 21.95 | 21.95 | 3K roll-wrapped 2-pack https://www.amazon.com/dp/B0BWS25VCP (ArrisHobby direct 2 for $8.99 https://www.arrishobby.com/products/glossy-surface-3k-roll-wrapped-carbon-fiber-tube-8mm10mm500mm2-pcsab0003) | 2026-09-28 | to buy | leg.tibia_tube_od; leg.tibia_tube_id; part_tibia; mass_hw.tibia_tube
A-16 | A bench kit | Mechanical | Compression springs 11 mm OD, two wire sizes (0.6 and 0.8 mm) | SEA foot spring in the 13.2 mm bore, 7 mm travel. Assortments stop at ~9.5 mm OD, so buy two single sizes to bracket the unknown rate: 0.6 mm wire ~1 N over 7 mm, 0.8 mm ~3-4 N (stance is ~9 N a foot). Rate VERIFY (backlog: SEA spring spec); the foot-switch model assumes contact at ~2 N. | 1 | 16.38 | 16.38 | uxcell 11 OD x 0.6 x 25 FL (10) $6.69 https://www.amazon.com/dp/B0FHKQLMJN + 11 OD x 0.8 x 20 FL (25) $9.69 https://www.amazon.com/dp/B0FHKLDNJY | 2026-09-28 | to buy | leg.sea_travel; part_tibia; sensing.foot_switch; D010
A-17 | A bench kit | Sensors | KW10 sub-miniature microswitch (20) | SEA foot contact x5 (pocket 6.8 x 13.2 x 6.2) + whiskers x2 + spares; one goes in the bench leg. KW10 bodies are ~12.8-13 x 5.8-6 x 6-6.5 mm: caliper one before printing five tibias. KW11/KW12 are ~20 mm long and do not fit. | 1 | 10.09 | 10.09 | uxcell KW10 20-pack https://www.amazon.com/dp/B06XXW1ZT7 | 2026-09-28 | to buy | part_tibia; sensing.foot_switch; D010; B11
B-01 | B full robot | Actuators | Feetech ST3215 12 V 30 kg.cm, to 16 total | Legs 1-4. Same variant and horn checks as A-01; buy from the same source as the bench servos so the horns match. | 12 | 20.63 | 247.56 | Waveshare 12 V SKU 22414 $20.63 at 4+ https://www.waveshare.com/st3215-servo.htm?sku=22414 (alt: Seeed US warehouse $22.99 at 10+ https://www.seeedstudio.com/STS3215-30KG-Serial-Servo-p-6340.html; AliExpress Feetech store ~$25 each, not cheaper) | 2026-09-28 | to buy | actuators.st3215; bus.leg_ids; D002
B-02 | B full robot | Actuators | Feetech SCS0009 micro bus servo, 6 V | 5 claws + 1 spare. 6 V domain ONLY (the UBEC row), never the 12 V rail (D016); protocol 0 on the shared data line. Can wait if the plain foot walks first (B25). | 6 | 9.00 | 54.00 | Seeed https://www.seeedstudio.com/Feetech-SCS0009-Servo-p-6535.html ($8.00 at 10+, ships from China); Waveshare SC09 $8.31 at 4+ has the same specs (VERIFY it speaks SCS protocol 0 before choosing it) https://www.waveshare.com/sc09-servo.htm | 2026-09-28 | to buy | actuators.scs0009; bus.hand_ids; D016; B25
B-03 | B full robot | Compute | Raspberry Pi 5, 4 GB | The onboard loop (B35), SLAM, the camera, the Wi-Fi fingerprint (D057). The brains run on a separate GPU computer over Wi-Fi (D054, D055), so 4 GB is enough (loop + slam_toolbox + camera + audio stay under ~2 GB); 8 GB ($175) only buys room for on-robot builds and recording. Nothing needs the Pi before one leg walks. MSRP rose in April 2026; Amazon and Adafruit sell $20-45 above it. | 1 | 110.00 | 110.00 | PiShop.us https://www.pishop.us/product/raspberry-pi-5-4gb/ (CanaKit also at MSRP) | 2026-09-28 | wait until one leg walks | B35; D054; D057
B-04 | B full robot | Compute | Pi 5 Active Cooler + 64 GB A2 microSD | Buy with the Pi. Skip NVMe: the robot writes little, and the HAT adds height and mass. | 1 | 42.94 | 42.94 | PiShop.us cooler $10.95 https://www.pishop.us/product/raspberry-pi-active-cooler/ + SanDisk Extreme 64 GB A2 $31.99 https://www.amazon.com/dp/B0G8LX3JFM | 2026-09-28 | wait until one leg walks | part_avionics
B-05 | B full robot | Power | 3S LiPo 5200 mAh, SOFT case, XT60 | Must fit the sled: <= 138 x 44 x 25 mm (D062; in the keel tub's 33 mm the sled rests 2.10 over the floor, + sled 3 + pack 25 + the 2 mm foam pad = 32.10, D064). Hard-case 5200s are ~37 mm tall; most 50C soft 5200s (Ovonic, HOOVO, Helios) are 26.7-27 mm and do not fit either. The listed pack: 132 x 43 x 25 mm, 343 g, 50C, XT60 fitted when bought direct (the Amazon listing B07CWS1HC5, $31.49, ships a Deans plug + a loose XT60). One pack to start; the sim and the stand are sized for 380 g (pick 6). | 1 | 34.99 | 34.99 | Zeee https://zeeebattery.com/products/zeee-3s-lipo-battery-5200mah-50c-11-1v-xt60 | 2026-09-28 | to buy | interfaces.battery_sled; mass_hw.battery_3s_5200
B-06 | B full robot | Power | LiPo balance charger, DC 300 W + USB-C PD input (SkyRC B6neo2) | Runs from the bench supply at 24 V or a 100 W USB-C PD brick (20 V / 5 A + an e-marked cable). AC-input chargers in this class (ISDT 608AC) give only 50 W on AC. | 1 | 38.50 | 38.50 | https://www.amazon.com/dp/B0GDK65S7G (B6neo $37.50 https://www.amazon.com/dp/B0CCT2WGNS) | 2026-09-28 | to buy
B-07 | B full robot | Safety | LiPo charge bag + balance-lead voltage alarm x2 | Charge in the bag, never unattended. The alarm rides the balance lead whenever the robot runs: the driver's 9.9 V floor is software, this is not. | 1 | 23.48 | 23.48 | Zeee LiPo bag $13.49 https://www.amazon.com/dp/B07KZQZBN2 + Apex RC 1-8S checker/alarm 2-pack $9.99 https://www.amazon.com/dp/B00XQ91ECA | 2026-09-28 | to buy | bus.safety.volt_min_v
B-08 | B full robot | Power | XT60 loop key (arming plug) | Arms the robot and is the E-stop in the pack lead: a genuine XT60H female with a short 12-14 AWG loop, into an XT60E-M (B-12) in the keel tub's nose wall above the dock, facing +x, reachable with the carapace on (pick 3). A DC-rated >= 20 A rocker is the alternative. | 1 | 5.00 | 5.00 | DIY from B-12 (ready-made XT60 loops $8.69 for 2 https://www.amazon.com/dp/B0G6VDBDNB) | 2026-09-28 | to buy | WIRING_HARNESS; part_bay
B-09 | B full robot | Power | Inline blade-fuse holder (14 AWG) + 15 A fuses (5) | Main fuse right after the pack, in the keel tub's nose compartment over the XT60 carrier: 16.3 mm of height free there (13.85 over the carrier's stop window). VERIFY that the holder fits; if not, it goes on the 14 AWG run north of the tub. | 1 | 14.85 | 14.85 | MGI 14 AWG ATC holder + 15 A fuse 2-pack $9.99 https://www.amazon.com/dp/B08TH41GWN + Bussmann ATC-15 5-pack $4.86 https://www.amazon.com/dp/B00FX9AVN4 | 2026-09-28 | to buy | WIRING_HARNESS power budget; part_bay
B-10 | B full robot | Power | 5 V 5 A buck (Pololu D24V50F5) + 1000 uF 16 V capacitor | On the hub shelf, face-down under one 3.6 mm tie (pick 14); its 5 V reaches the Pi over the tray's bulkhead XT30. Pi 5 through the GPIO 5 V pins, which skips USB-C PD: tell the firmware it has 5 A (EEPROM PSU_MAX_CURRENT=5000, or usb_max_current_enable=1). Pololu lists stock as rationed. | 1 | 34.00 | 34.00 | Pololu $32.95 (rationed; 35 in stock 2026-09-28) https://www.pololu.com/product/2851 + capacitor; D36V50F5 ($39.95, 5.5 A, well stocked) is the drop-in alternative https://www.pololu.com/product/4091 | 2026-09-28 | to buy | interfaces.hub_shelf.boards; WIRING_HARNESS
B-11 | B full robot | Power | 6 V UBEC, 3 A (Hobbywing UBEC-3A) | Hand-servo rail (D016), face-down on the hub shelf under two 3.6 mm ties (pick 14), + a spare. Set the jumper to 6 V and measure before any claw is plugged in. Input 2-6S, 11 g. | 2 | 8.99 | 17.98 | Hobbywing https://www.hobbywingdirect.com/products/ubec-3a-2-6s-lipo-input | 2026-09-26 | to buy | D016; bus.hand_ids; interfaces.hub_shelf.boards
B-12 | B full robot | Connectors | XT60H pairs (10) + XT60E-M panel mounts (10), genuine Amass | Pack lead, the sled's nose (an XT60E-M glued 8.0 proud), the loop key's socket in the keel tub's nose wall (an XT60E-M), dock tower (B14), spares. The tub's floating carrier takes a FEMALE: B-25. Genuine = 'AMASS' moulded in the housing. XT60E1-M is a different flange from the XT60E-M the CAD is cut for. | 1 | 21.98 | 21.98 | Amass XT60H 10 pairs $9.99 https://www.amazon.com/dp/B074PN6N4K + XT60E-M 10 pcs $11.99 https://www.amazon.com/dp/B07YJMCDC3 (RaceDayQuads $0.99 each) | 2026-09-28 | to buy | interfaces.battery_sled.xt60_float; part_battery; part_bay; part_dock
B-13 | B full robot | Connectors | XT30U pairs, genuine Amass (10) | Five leg drops (I1), the avionics tray's bulkhead XT30 (5 V from the shelf's buck, I4), two spare taps off the PDB after the fuse, the bench-supply lead for the jig leg: 9 of 10. The bulkhead cutout is cut for a panel XT30 (part_avionics, VERIFY): check that an XT30U half seats there. | 1 | 8.58 | 8.58 | https://www.amazon.com/dp/B08P5HVMYT | 2026-09-28 | to buy | interfaces.leg_port.conn_power
B-14 | B full robot | Wiring | Per-leg 12 V splitter (DIY): the leg's XT30 -> three servo power leads | Fans the leg's 12 V out at the coxa, one lead per servo (spliced into the V+ of the daisy lead that enters that servo; each ST3215 has only two ports): never carry a leg's 12 V through the servos' 2 A connector pins. Data + GND still daisy-chain. Built from the XT30, servo-lead and wire rows. | 5 | 2.00 | 10.00 | est | est | to buy | WIRING_HARNESS; review 2026-09-22
B-15 | B full robot | Wiring | Silicone wire + heat-shrink lot | 14 AWG red/black 1 m each (the tub's carrier -> fuse -> loop key -> the PDB; the feed is ~145 mm from the nose chamfer's exit), 20 AWG red/black 3 m each (leg 12 V), 24-26 AWG colours (data, 6 V, sensors; per leg ~0.6 m each of the hand's 6 V, data and GND and the two foot-switch wires, ~15 m over five legs; the gauge table wants 24 AWG for the 6 V, the listed lot is 26 AWG), heat-shrink assortment. | 1 | 40.93 | 40.93 | BNTECHGO 14 AWG $11.98 https://www.amazon.com/dp/B017TFR6SM + 20 AWG $8.48 https://www.amazon.com/dp/B01AAX64EC + 26 AWG 10 colours $12.48 https://www.amazon.com/dp/B01M9800TG + Ginsco heat-shrink $7.99 https://www.amazon.com/dp/B01MFA3OFA | 2026-09-28 | to buy | WIRING_HARNESS gauge table
B-16 | B full robot | Wiring | JST-XH 2.54 mm PRE-CRIMPED kit (2-7 pin housings, sockets, 22 AWG leads) | I1 data drop XH-5 x5 and the star board. Pre-crimped leads skip the crimper: pick the nearest length and push the pins in. 22 AWG is the top of XH's range (fits, stiff). Custom-length looms need the X-15 crimper. | 1 | 7.99 | 7.99 | Shutao kit https://www.amazon.com/dp/B0CJ6JDMJH | 2026-09-28 | to buy | interfaces.leg_port.conn_data; docs/WIRING_HARNESS.md (star board)
B-17 | B full robot | Wiring | JST-SH 3-pin pre-crimped cable, 100 mm plug-plug | I2 tool socket ends (6 V, GND, TTL), one per leg + spares. Adafruit 6404 is board-to-board (a JST SH plug on BOTH ends): cut one in half for the leg-side pigtail; the hand side needs a mating SH-3 header (VERIFY part, B91). Its red wire is the middle pin: re-mark it. The leg run is B-15 wire, ~0.45 m (29 mm tube) to ~0.55 m (120 mm tube) per leg from XH-5 pin 3 at the cutout. | 10 | 1.50 | 15.00 | Adafruit 6404 https://www.adafruit.com/product/6404 | 2026-09-28 | to buy | interfaces.tool_socket.conn
B-18 | B full robot | Wiring | Star board: 2.54 mm perfboard, XH-5 right-angle x1, XH-5 vertical x5, XH-6 vertical x1 | The star-of-daisies hub, on the hub shelf's four star posts (34 x 24, M3 x 6 from A-09); the XH-6 takes the five foot-switch lines to the Pi (one GPIO per leg). | 1 | 20.98 | 20.98 | ELEGOO perfboard 32 pcs $9.99 https://www.amazon.com/dp/B072Z7Y19F + XH right-angle header kit $10.99 https://www.amazon.com/dp/B0F2MH1BRK (the vertical XH headers may come with B-16: check its photos) | 2026-09-28 | to buy | part_busboard; docs/WIRING_HARNESS.md (star board)
B-19 | B full robot | Mechanical | N35 disc magnets 6 x 3 mm (50) | I3: shell feet 5, hatch seats 5, cap plugs 5, the frame_coupon + demo pair 4 (the tub's door has none since D064). NORTH points away from the robot on every magnet, panel and frame alike (INTERFACES I3): the frame magnet shows N, the panel magnet S. Hatch: seat and cap magnets both N up, in walled pockets since D063 (B88). | 1 | 6.99 | 6.99 | https://www.amazon.com/dp/B0G1STX1V8 | 2026-09-28 | to buy | interfaces.panel_latch.magnet_d; part_shell; D030
B-20 | B full robot | Mechanical | M3 flat washers, zinc-plated STEEL, 7 mm OD (DIN125) | Deck magnet strikes x5 (glued into the 8 mm recesses) + trim-cup ballast (B3). STEEL, not 304 stainless: stainless is barely magnetic and the latch will not hold. 12 mm fender washers do not fit the recess. | 1 | 7.99 | 7.99 | 500-pack https://www.amazon.com/dp/B0B5GXMVRG | 2026-09-28 | to buy | part_deck; part_smallwins.trim_cup; B3
B-21 | B full robot | Fasteners | M2.5 x 6 / x 8 / x 10 screw assortment + M2.5 hex nuts | Pi 5: 4 x M2.5 x 6 or x 8 into the printed thread-forming standoffs (58 x 49, 11 tall since D063, B89/B90: the 2.05 mm bore runs the full height, so x 6 engages 4.4 mm and x 8 6.4). BNO085: 4 x M2.5 x 10 through the TPU grommets (B4), whose 2.7 mm bore does not thread, and a standard DIN 934 hex nut under each (the kit has them): the screw passes the nut by ~0.2 mm and its tail ends 0.9 mm above the deck, so x 10 only (x 12 reaches the deck). The bus adapter on the hub shelf: 4 x M2.5 x 8 pan head from below through its spacers (B-28) into the plate's thread-forming bores. | 1 | 10.97 | 10.97 | 304 M2.5 pan head kit, 4-30 mm https://www.amazon.com/dp/B096Z5CWGC | 2026-09-28 | to buy | part_avionics; part_busboard; part_smallwins.imu_grommet; B4; B89; B90
B-22 | B full robot | Materials | TPU 95A 1.75 mm, 1 kg | Foot pads and IMU grommets. | 1 | 21.99 | 21.99 | Sunlu $21.99 https://www.amazon.com/dp/B0BXNWK6NS; Overture $22.99 https://www.amazon.com/dp/B07VDP2S3P. Print it slowly (~20 mm/s) with minimal retraction | 2026-09-28 | to buy | part_footpad; leg.foot.pad_crown; B4; B25
B-23 | B full robot | Consumables | Cable ties 2.5 x 100 mm (100) + 3.6 x 150 mm (50) | 2.5 mm: the deck's (+-12, 50) zip anchors (3.4 mm holes: the tray trunk and the leg 0 loom) and the B14 dock's charge-lead anchors. 3.6 mm: the hub shelf's 7 (buck 1, UBEC 2, the lead anchors 2, the leg 1 / 4 looms at the posts 2) and the tub lid's 2 tie bars for the leg 2 / 3 looms: 9 of 50. | 1 | 8.00 | 8.00 | est | est | to buy | part_deck; part_busboard; part_bay; part_dock
B-24 | B full robot | Power | 12 V power node: a 30.5 x 30.5 FPV-style PDB, >= 6 pad pairs, >= 15 A, no BEC | Pick 9: on the hub shelf's four standoffs (30.5 square, M3 x 6), a 36 x 36 board. After the fuse and the loop key: the 14 AWG feed in; out, the five XT30 leg drops, the 5 V buck, the 6 V UBEC, the bus adapter's 12 V and two XT30 spare taps (ten loads: double up leads on a pad if the board bought has fewer pairs). Its parts and flat-soldered leads must stay <= 6.0 over the board (leg 1's loom passes 1.20 over that): VERIFY. | 1 | 10.00 | 10.00 | est | est | to buy | interfaces.hub_shelf.node_pattern; part_busboard; WIRING_HARNESS; B92
B-25 | B full robot | Connectors | Amass XT60E-F female panel mount: the keel tub's XT60 carrier | The female half of the I5 dock: it sits in the floating carrier printed into the tub's nose (pick 4) and mates the sled's glued XT60E-M (B-12 has only male panel mounts). An XT60H female from B-12's pairs may serve if it seats in the carrier's 16.5 x 8.9 pocket: VERIFY on the printed tub. One + a spare. | 2 | 1.00 | 2.00 | est (D064, 2026-10-08: price not checked) | est | to buy | interfaces.battery_sled.xt60_float; part_bay; D064
B-26 | B full robot | Fasteners | M3 x 30 socket head, ISO 4762 (10) | The hub shelf's three posts, driven from BELOW: the head flush in the plate's 6.4 mm counterbore, through 26.3 of post, 3.7 into the deck's blind 2.8 x 5 thread-forming hole (1.3 short of its end). From the deck top a head would sit under the docked coxa plate at (+-50, 34). | 1 | 4.00 | 4.00 | est (D064, 2026-10-08: price not checked) | est | to buy | interfaces.hub_shelf.post_screw; part_busboard; part_deck
B-27 | B full robot | Fasteners | M3 ISO 7380 button head socket screws: x 16 (6) + x 10 (2) | The tray-rail tabs and the tub's hangers. Four M3 x 16 through the rail tabs at (+-40, -20 / 0) and the deck into the bay_lid bosses' inserts (one screw holds rail and tub); two M3 x 16 from the deck top at (+-58, -18) into the other two hangers. The rail tabs sit under the tray plate: a button head (1.65 tall) leaves 1.75 of the 3.40, a socket head (3.0) does not fit. The two tabs at (+-40, 20) hold only the rails: an M3 x 10 each, thread-forming into the deck's Ø2.8 hole (tab 2 + deck 6), no nut (B155): nothing hangs under them, and the tip comes out 2.0 under the deck, 1.90 over the star board at (40, 20) (part_busboard measures it). A-09's button-head kit may cover these if its heads are ISO 7380. | 1 | 6.00 | 6.00 | est (D064, 2026-10-08: price not checked) | est | to buy | interfaces.avionics_tray; part_avionics.tray_rail; part_deck; part_bay
B-28 | B full robot | Fasteners | Round nylon spacers 5 mm OD x 2.5 long, ID >= 2.6 (M2.5) (pack) | The bus adapter's four standoffs under the hub shelf (face-down, pick 14), M2.5 x 8 (B-21) through them into the plate. 2.5 may not be a stock length: a DIN 934 M2.5 nut (2.0) + a DIN 125 washer (0.5) is the same stack. A 3.0 spacer puts the adapter 0.5 under the shelf's bottom_z, 0.5 over the tub's bottom. | 1 | 4.00 | 4.00 | est (D064, 2026-10-08: price not checked) | est | to buy | interfaces.hub_shelf.boards; part_busboard
B-29 | B full robot | Materials | Closed-cell foam sheet, 2 mm (EVA or neoprene): one 138 x 44 pad | Pick 8 (b): under the keel tub's roof, over the pack; it takes the pack's play (0.90 to spare in the 33 mm stack). Nothing straps the pack inside the robot, so there is no strap row. | 1 | 5.00 | 5.00 | est (D064, 2026-10-08: price not checked) | est | to buy | interfaces.battery_sled.foam_pad_t; part_bay
B-30 | B full robot | Wiring | UART lead, 3 wires: Dupont female housings at the Pi's header, the adapter's H2 at the other end | The Pi to the bus adapter through the tray bulkhead's XH-5 trunk (pick 14; XH parts B-16): H2 RXD -> Pi pin 10, H2 TXD -> pin 8 (crossed: a straight 1:1 lead swaps them), GND from pin 9 or 14 (pin 6 is the buck's). At H2 solder the leads, or use a right-angle housing inside the board's 11.0 parts envelope (a straight Dupont on a vertical H2 hangs to z -59.9 face-down). Jumper H4 to A. Made from a Dupont jumper set + B-15 wire. | 1 | 5.00 | 5.00 | est (D064, 2026-10-08: price not checked) | est | to buy | interfaces.hub_shelf.boards; docs/WIRING_HARNESS.md (the UART link); B128
C-01 | C senses | Sensors | Adafruit BNO085 9-DOF IMU (4754) | Run it on SPI: a Pi's I2C mishandles its clock stretching, and UART-RVC sends angles + acceleration only, no gyro rates, which the brace trip and the odometry EKF need. SPI uses 4 lines + INT + RST (and the PS1 bridge). sim/sim_imu.py is its model. Clone boards ($18-23) save ~$10 and often ship the older BNO080. Mounting holes 20.32 x 17.78 (2.5 mm, Adafruit board file): the tray's IMU grommet seats match them since D063 (B90). Solder SPI wires directly; no header pins fit under the Pi. | 1 | 29.50 | 29.50 | Adafruit https://www.adafruit.com/product/4754 | 2026-09-28 | to buy | reflex.gyro_trip; sim/sim_imu.py; B35
C-02 | C senses | Sensors | LDRobot D500 lidar kit (STL-19P) | 360 deg, 0.03-12 m, 10 Hz, <= 0.72 deg, UART 230400, 5 V 290 mA, 45 g, 54.0 x 46.3 x 35.0 mm (STL-19P datasheet; VERIFY with calipers); kit includes a USB adapter; ROS 2 SDK. Unblocks the hatch-cap mount (B12) and a params lidar block (B40). The LD19 / D300 kit is discontinued. | 1 | 62.10 | 62.10 | LDROBOT store on AliExpress https://www.aliexpress.us/item/3256802826366269.html (Amazon, LDROBOT $79 https://www.amazon.com/dp/B0DDKXQ23R; Waveshare $95.99 https://www.waveshare.com/D500-LiDAR-Kit.htm) | 2026-09-28 | to buy | sim/sim_lidar.py; sim/laserscan_spec.json; B12; B40; D024; D057
C-03 | C senses | Sensors | Alternative to the D500: used Xiaomi/Roborock LDS02RR vacuum lidar | ~$17-30 but ~190 g against 45 g: eats most of the payload margin, and a used part is a gamble. Not counted in the totals. | 1 | 25.00 | 25.00 | est (eBay / AliExpress, July prices) | est | alternative | D024; mass_hw.electronics_pod
C-04 | C senses | Sensors | Raspberry Pi Camera Module 3 Wide + Pi 5 camera cable (22-pin to 15-pin) | Fixed, forward, behind a shell gill (B16); no pan turret. 120 deg diagonal (~102 x 67 deg). The sim eye is fovy 70 at 4:3 (~86 deg wide): match it when the camera is in hand. Cable length follows the B16 bracket (200-300 mm). | 1 | 42.45 | 42.45 | PiShop camera $38.50 https://www.pishop.us/product/raspberry-pi-camera-module-3-wide/ + Pi 5 CAMERA cable 300 mm $3.95 https://www.pishop.us/product/camera-cable-for-raspberry-pi-5/ (the display cable is a different part) | 2026-09-28 | to buy | sim/world_builder.py EYE_CAM; B16; D054
C-05 | C senses | Wiring | Right-angle USB-A cable for the lidar's USB adapter | The Pi's one usable USB-A port (the lower middle USB 3 port next to the RJ45, the USB end toward leg 4; B128): plug body <= 20 mm long from the port face, overmold <= 14 x 7 mm, the cable leaving down or south (21.59 of room at the worst float). Measure the plug before buying; the other three ports have 8.4-11.8 of room. | 1 | 8.00 | 8.00 | est (D064, 2026-10-08: price not checked) | est | to buy | interfaces.avionics_tray.pi_usb_end; part_avionics; B128
D-01 | D voice/brain | Audio | MAX98357A I2S amplifier (Adafruit 3006) + 40 mm 4 ohm 3 W speaker | Chord-speak from the robot itself (today it plays in the browser, D051). Uses the Pi's only I2S (GPIO 18/19/21). | 1 | 14.94 | 14.94 | Adafruit 3006 $5.95 https://www.adafruit.com/product/3006 + Gikfun 40 mm 4 ohm 3 W speaker 2-pack $8.99 https://www.amazon.com/dp/B01LN8ONG4 (Adafruit's 40 mm speaker is out of stock) | 2026-09-28 | optional | audio/chordspeak2.py; D051
D-02 | D voice/brain | Audio | USB mini microphone | Onboard ears for hands-free talk; today the cockpit takes the phone or laptop mic to a desk speech server (D054). USB keeps the header free. | 1 | 5.95 | 5.95 | Adafruit 3367 https://www.adafruit.com/product/3367 | 2026-09-28 | optional | D054
D-03 | D voice/brain | Audio | Alternative to the amplifier + USB mic: Seeed ReSpeaker 2-Mics Pi HAT v2.0 | Two mics and a codec on one HAT, but it takes the I2S pins, SPI0 MOSI/SCLK (its APA102 LEDs, which an SPI0 IMU would also clock), GPIO17 and the whole header. Replaces the amplifier + USB mic rows; not counted in the totals. | 1 | 13.99 | 13.99 | Seeed https://www.seeedstudio.com/ReSpeaker-2-Mics-Pi-HAT.html | 2026-09-26 | alternative | backlog: Pi pin map
X-01 | X optional/tools | Sensors | INA228 power monitor (Adafruit 5832) | One on the 12 V servo feed after the fuse: pack voltage under load, a charge/energy accumulator for a real battery gauge, and ground truth for the servos' own PRESENT_CURRENT (6.5 mA/count) that the thermal model rests on. The onboard 15 mOhm shunt reads to ~10.9 A (walking 4-6 A, peaks 8-10). I2C 0x40. Design change (mount + I2C pins): backlog. | 1 | 14.95 | 14.95 | Adafruit https://www.adafruit.com/product/5832 | 2026-09-26 | optional | bus.safety.volt_min_v; D052a; B35
X-02 | X optional/tools | Sensors | Downward ToF: Pololu VL53L4CD carrier | One per leg looking down ahead of the foot: sees a drop before a foot probes into it (the probe guard's lip band, D050 / B33c). 1-1200 mm, 18 deg FoV, 0.5 g. All five share I2C address 0x29: an XSHUT GPIO each or a TCA9548A. Grid option: VL53L8CX (B40). Design change (mounts, harness, driver, sim model): backlog. | 5 | 12.83 | 64.15 | Pololu, $12.83 each at 5 https://www.pololu.com/product/3692 (clones are dearer) | 2026-09-28 | optional | D050; B33; B40
X-03 | X optional/tools | Safety | Remote kill relay: 12 V 40 A relay + 433 MHz fob, latching mode | Cuts the 12 V servo feed from across the room with no Pi, Wi-Fi or brain in the path (the model-independent stop of D055 is still software). 'Latching' here is a toggle mode: the coil stays powered while on, the fob code is fixed, and contact ratings are optimistic (VERIFY the DC rating). Losing the radio does not trip it. Normally-open contact in series after the fuse. ~25 g, needs a mount: backlog. | 1 | 14.03 | 14.03 | https://www.amazon.com/dp/B0852G3KFJ | 2026-09-28 | optional | D055; WIRING_HARNESS
X-04 | X optional/tools | Compute | USB Wi-Fi adapter with an external antenna (MT7921AU class, in-kernel mt7921u driver) | Only if the Pi 5's PCB antenna (no u.FL) reads poorly inside the closed carapace: the host heartbeat (B35), the brains on the desk (D054) and the radio fingerprint of D057 all ride Wi-Fi. Measure RSSI in and out of the shell first. | 1 | 26.99 | 26.99 | EDUP AX3000M https://www.amazon.com/dp/B0CZ82RM5L (ALFA AWUS036AXML $72 is the larger known-good option) | 2026-09-28 | optional | B35; D054; D057
X-05 | X optional/tools | Tools | USB logic analyzer, 8 ch 24 MHz (sigrok / PulseView) | Decodes the 1 Mbps half-duplex servo bus (the runbook's 'checksum errors under load' row), SPI to the IMU and I2C. | 1 | 12.69 | 12.69 | HiLetgo https://www.amazon.com/dp/B077LSG5P2 | 2026-09-28 | optional | bench/BENCH_RUNBOOK.md troubleshooting
X-06 | X optional/tools | Power | Second 3S 5200 mAh soft-case pack | When walking time matters; same size limit as the main pack. | 1 | 34.99 | 34.99 | Zeee, same page as the main pack | 2026-09-26 | optional | interfaces.battery_sled
X-07 | X optional/tools | Mechanical | 2 mm stainless rod, 300 mm | Hand hinge pins (15, cut to length) in the 2.1 mm bores; 1.75 mm filament is the zero-cost default. | 1 | 5.99 | 5.99 | 304 rod 2 x 300 mm, 12 pcs https://www.amazon.com/dp/B0GSVY4X3Y | 2026-09-28 | optional | part_hand
X-08 | X optional/tools | Sensors | 0.8-1.2 mm piano wire | Whiskers in the printed whisker_shoe (1.3 mm bores), switched by two of the KW10 microswitches. | 1 | 3.99 | 3.99 | K&S music wire 1.0 mm https://www.amazon.com/dp/B002WXPNA0 | 2026-09-28 | optional | part_smallwins.whisker_shoe; B11
X-09 | X optional/tools | Sensors | Sensor pod set: US-100 x5, TCA9548A, BME688, AM312 PIR x3 | The sensor pods (docs/SIM_GUIDE.md §9), later: no pod CAD, driver or sim model yet, and trig/echo sonar costs 10 GPIO. | 1 | 64.00 | 64.00 | Adafruit 4019 / 2717 + Pimoroni BME688 (July prices) | est | optional | docs/archive/PERCEPTION_PLAN_2026-09-30.md; interfaces.dovetail
X-10 | X optional/tools | Sensors | Depth camera with onboard compute (OAK-D Lite class) | Later or on a bigger platform: B40 puts it after the lidar and the ToF. | 1 | 150.00 | 150.00 | est (July price $128) | est | optional | B40
X-11 | X optional/tools | Tools | Digital calipers, 150 mm | Fit ladder, servo and pack measurements: every VERIFY in params. | 1 | 25.00 | 25.00 | est | est | have | cad/params.yaml; B28
X-12 | X optional/tools | Tools | Multimeter | Supply check before first contact, 6 V check before any claw, continuity on every drop. | 1 | 25.00 | 25.00 | est | est | have | D016
X-13 | X optional/tools | Tools | Digital scales: 0.1 g pocket + 1 g kitchen | Every mass_hw number is VERIFY on a scale (sim/mass_budget.json, the torque audit). | 1 | 20.00 | 20.00 | est | est | have | mass_hw
X-14 | X optional/tools | Tools | Soldering iron with a heat-set insert tip | Inserts, the star board, the splitters. | 1 | 45.00 | 45.00 | est | est | have | print.heatset_m3_d
X-15 | X optional/tools | Tools | JST-XH crimper (PA-09 class) | Only for custom-length XH looms: B-16's pre-crimped leads avoid it. A generic wire crimper will not do XH pins. | 1 | 38.99 | 38.99 | Engineer PA-09 $38.99 https://www.amazon.com/dp/B002AVVO7K (IWISS SN-28B ratchet $22.29 https://www.amazon.com/dp/B00OMM4YUY) | 2026-09-28 | have | docs/WIRING_HARNESS.md (star board)
X-16 | X optional/tools | Materials | PETG 1.75 mm, 1 kg | Structural leg parts and the shell. Plain PETG over PETG-CF for the legs: CF is stiffer but weaker across layers and more brittle, needs a hardened nozzle, and would need a new FEM run. | 2 | 20.00 | 40.00 | Prusament direct $25.49 (tuned profiles); Polymaker $15.74 https://www.amazon.com/dp/B0FG3HMCVY | est | have | PRINT_PLAN
X-17 | X optional/tools | Materials | PLA 1.75 mm, 1 kg | Coupons, servo blanks, jigs, the hub shelf. | 1 | 18.00 | 18.00 | est | est | have | PRINT_PLAN
X-19 | X optional/tools | Tools | Filament dryer, >= 65 C (Sunlu S2 class) | PETG must be dry for the one-piece deck and the leg parts. Dryers that top out at 55 C (eSun eBOX Lite) are too cool for PETG. | 1 | 38.24 | 38.24 | Sunlu S2 https://www.amazon.com/dp/B0FDGKM7S1 | 2026-09-28 | optional | docs/PRINT_PLAN.md
X-20 | X optional/tools | Tools | Long flat screwdriver: blade <= 5 mm, shaft >= 183 mm (200 recommended) | Turns the keel tub door's I3 latch from +x along the tub's south wall: its slot faces +x at x -85.7 and the shaft must pass the carapace skirt at x 87.3. Works with the robot on the stand. | 1 | 6.00 | 6.00 | est (D064, 2026-10-08: price not checked) | est | have | part_bay.bay_door; interfaces.panel_latch
