2BitwiseBard/rocky/(list of files, cad)

Other CAD files:
cad/out/leg_skeleton_assembly.step
cad/out/hand_assembly_closed.step
cad/out/hand_assembly_open.step
cad/out/port_coupon_plate_fit10.step
cad/ref/STS3215_03a.step
cad/out/tray_rail.step
cad/out/shell_sector.step
cad/out/fit_ladder.step
cad/out/preview_leg_skeleton.stl
cad/out/port_coupon_plate_relief46.step
cad/out/body_deck.step
cad/out/tray_latch_boss.step
cad/out/coxa_yaw_base.step
cad/out/bay_tub.step
cad/out/dock_tower.step
cad/out/port_coupon_plate_relief42.step
cad/out/jig_column.step
cad/out/bay_door.step
cad/out/preview_shells.stl
cad/out/preview_shell_sector.stl
cad/out/stand_crown.step
cad/out/dock_base.step
cad/out/hub_shelf.step
cad/out/port_coupon_deck.step
cad/out/port_coupon_plate_fit20.step
cad/out/avionics_tray.step
cad/out/preview_skeleton.stl
cad/out/battery_sled.step
cad/out/bay_lid.step
cad/out/shell_sector_demo.step
cad/out/latch_housing.step
cad/out/whisker_shoe.step
cad/out/coxa_fork.step
cad/out/latch_rotor.step
cad/out/coupon_yaw_hub.step
cad/out/preview_shell_cap.stl
cad/out/link_clip.step
cad/out/dovetail_shoe.step
cad/out/frame_coupon.step
cad/out/thumb_knob_m3.step
cad/out/dovetail_male_coupon.step
cad/out/shell_cap.step
cad/out/coupon_idler.step
cad/out/femur_plate_b_posed.step
cad/out/femur_plate_b.step
cad/out/femur_link_posed.step
cad/out/preview_leg_shell.stl
cad/out/dryfit_blanks_posed.step
cad/out/servo_blank.step
cad/out/trim_cup.step
cad/out/tool_scoop.step
cad/out/horn_coupler.step
cad/out/jig_base.step
cad/out/servo_st3215_dummy.step
cad/out/tool_hook.step
cad/out/foot_pad_tpu.step
cad/out/trim_cup_lid.step
cad/out/coupler_recess_demo.step
cad/out/tibia_sea_slider.step
cad/out/tibia_knee_carrier.step
cad/out/hand_finger.step
cad/out/stand_base.step
cad/out/coupon_hip_hub.step
cad/out/calib_gauge_knee.step
cad/out/imu_grommet.step
cad/out/servo_cup.step
cad/out/blank_idler.step
cad/out/femur_link.step
cad/out/dryfit_couplers_posed.step
cad/out/calib_gauge_hip.step
cad/out/hand_hub.step
cad/out/stand_section.step
cad/out/hand_cam.step
cad/out/tibia_sea_outer.step
cad/out/tube_clip.step
cad/out/coupon_cup.step
cad/out/preview_body.stl
cad/out/avionics_tray.stl
cad/out/battery_sled.stl
cad/out/bay_door.stl
cad/out/bay_lid.stl
cad/out/bay_tub.stl
cad/out/blank_idler.stl
cad/out/body_deck.stl
cad/out/calib_gauge_hip.stl
cad/out/calib_gauge_knee.stl
cad/out/coupler_recess_demo.stl
cad/out/coupon_cup.stl
cad/out/coupon_hip_hub.stl
cad/out/coupon_idler.stl
cad/out/coupon_yaw_hub.stl
cad/out/coxa_fork.stl
cad/out/coxa_yaw_base.stl
cad/out/dock_base.stl
cad/out/dock_tower.stl
cad/out/dovetail_male_coupon.stl
cad/out/dovetail_shoe.stl
cad/out/dryfit_blanks_posed.stl
cad/out/dryfit_couplers_posed.stl
cad/out/femur_link.stl
cad/out/femur_link_posed.stl
cad/out/femur_plate_b.stl
cad/out/femur_plate_b_posed.stl
cad/out/fit_ladder.stl
cad/out/foot_pad_tpu.stl
cad/out/frame_coupon.stl
cad/out/hand_assembly_closed.stl
cad/out/hand_assembly_open.stl
cad/out/hand_cam.stl
cad/out/hand_finger.stl
cad/out/hand_hub.stl
cad/out/horn_coupler.stl
cad/out/hub_shelf.stl
cad/out/imu_grommet.stl
cad/out/jig_base.stl
cad/out/jig_column.stl
cad/out/latch_housing.stl
cad/out/latch_rotor.stl
cad/out/leg_skeleton_assembly.stl
cad/out/link_clip.stl
cad/out/port_coupon_deck.stl
cad/out/port_coupon_plate_fit10.stl
cad/out/port_coupon_plate_fit20.stl
cad/out/port_coupon_plate_relief42.stl
cad/out/port_coupon_plate_relief46.stl
cad/out/servo_blank.stl
cad/out/servo_cup.stl
cad/out/servo_st3215_dummy.stl
cad/out/shell_cap.stl
cad/out/shell_sector.stl
cad/out/shell_sector_demo.stl
cad/out/stand_base.stl
cad/out/stand_crown.stl
cad/out/stand_section.stl
cad/out/thumb_knob_m3.stl
cad/out/tibia_knee_carrier.stl
cad/out/tibia_sea_outer.stl
cad/out/tibia_sea_slider.stl
cad/out/tool_hook.stl
cad/out/tool_scoop.stl
cad/out/tray_latch_boss.stl
cad/out/tray_rail.stl
cad/out/trim_cup.stl
cad/out/trim_cup_lid.stl
cad/out/tube_clip.stl
cad/out/whisker_shoe.stl
