2BitwiseBard/rocky/ros2/rocky_description/urdf/pebble.urdf

<?xml version="1.0"?>
<!-- AUTO-GENERATED from cad/params.yaml by generate_urdf.py — edit THAT, not this -->
<robot name="pebble">
  <material name="pebble"><color rgba="0.55 0.42 0.75 1"/></material>

  <link name="base_link">
    <inertial><origin xyz="-0.002210 -0.004630 -0.003180"/><mass value="1.5550"/><inertia ixx="4.726687e-03" ixy="-9.472300e-05" ixz="-1.576910e-04" iyy="5.545358e-03" iyz="-2.392510e-04" izz="6.800901e-03"/></inertial>
    <visual><origin xyz="0 0 0.018"/>
      <geometry><cylinder radius="0.1100" length="0.024"/></geometry>
      <material name="pebble"/></visual>
    <visual><origin xyz="0 0 0.044"/>
      <geometry><cylinder radius="0.0770" length="0.028"/></geometry>
      <material name="pebble"/></visual>
    <collision><origin xyz="0 0 0.018"/>
      <geometry><cylinder radius="0.1100" length="0.024"/></geometry></collision>
    <collision><origin xyz="0 0 0.044"/>
      <geometry><cylinder radius="0.0770" length="0.028"/></geometry></collision>
    <visual name="belly_tub"><origin xyz="0.001200 -0.020000 -0.036700"/>
      <geometry><box size="0.197400 0.054800 0.037400"/></geometry>
      <material name="pebble"/></visual>
    <collision name="belly_tub"><origin xyz="0.001200 -0.020000 -0.036700"/>
      <geometry><box size="0.197400 0.054800 0.037400"/></geometry></collision>
    <visual name="belly_shelf"><origin xyz="-0.001125 0.038250 -0.032200"/>
      <geometry><box size="0.110150 0.052100 0.044400"/></geometry>
      <material name="pebble"/></visual>
    <collision name="belly_shelf"><origin xyz="-0.001125 0.038250 -0.032200"/>
      <geometry><box size="0.110150 0.052100 0.044400"/></geometry></collision>
    <visual name="belly_shelf_post0"><origin xyz="-0.050000 0.034000 -0.024650"/>
      <geometry><cylinder radius="0.007000" length="0.029300"/></geometry>
      <material name="pebble"/></visual>
    <collision name="belly_shelf_post0"><origin xyz="-0.050000 0.034000 -0.024650"/>
      <geometry><cylinder radius="0.007000" length="0.029300"/></geometry></collision>
    <visual name="belly_shelf_post1"><origin xyz="0.050000 0.034000 -0.024650"/>
      <geometry><cylinder radius="0.007000" length="0.029300"/></geometry>
      <material name="pebble"/></visual>
    <collision name="belly_shelf_post1"><origin xyz="0.050000 0.034000 -0.024650"/>
      <geometry><cylinder radius="0.007000" length="0.029300"/></geometry></collision>
    <visual name="belly_shelf_post2"><origin xyz="0.026000 0.064000 -0.024650"/>
      <geometry><cylinder radius="0.007000" length="0.029300"/></geometry>
      <material name="pebble"/></visual>
    <collision name="belly_shelf_post2"><origin xyz="0.026000 0.064000 -0.024650"/>
      <geometry><cylinder radius="0.007000" length="0.029300"/></geometry></collision>
  </link>

  
    <link name="coxa0">
      <inertial><origin xyz="0.020000 0.000000 0.030000"/><mass value="0.0839"/><inertia ixx="3.233e-05" ixy="0" ixz="0" iyy="5.034e-05" iyz="0" izz="3.233e-05"/></inertial>
      <visual><origin xyz="0.020 0 0.030"/>
        <geometry><box size="0.060 0.032 0.060"/></geometry>
        <material name="pebble"/></visual>
      <collision><origin xyz="0.020 0 0.030"/>
        <geometry><box size="0.060 0.032 0.060"/></geometry></collision>
    </link>
    <joint name="yaw0" type="revolute">
      <parent link="base_link"/><child link="coxa0"/>
      <origin xyz="6.735557395310442e-18 0.11 0" rpy="0 0 1.5707963267948966"/>
      <axis xyz="0 0 1"/>
      <limit lower="-0.698132" upper="0.698132" effort="2.9400" velocity="4.7"/>
      <dynamics damping="0.6255"/>
    </joint>

    <link name="femur0">
      <inertial><origin xyz="0.047500 0.000000 0.000000"/><mass value="0.0427"/><inertia ixx="3.074e-06" ixy="0" ixz="0" iyy="3.365e-05" iyz="0" izz="3.365e-05"/></inertial>
      <visual><origin xyz="0.0475 0 0" rpy="0 1.570796 0"/>
        <geometry><cylinder radius="0.012" length="0.0950"/></geometry>
        <material name="pebble"/></visual>
      <collision><origin xyz="0.0475 0 0" rpy="0 1.570796 0"/>
        <geometry><cylinder radius="0.012" length="0.0950"/></geometry></collision>
    </link>
    <joint name="hip0" type="revolute">
      <parent link="coxa0"/><child link="femur0"/>
      <origin xyz="0.0450 0 0.0610"/>
      <axis xyz="0 -1 0"/>
      <limit lower="-1.221730" upper="1.570796" effort="2.9400" velocity="4.7"/>
      <dynamics damping="0.6255"/>
    </joint>

    <link name="tibia0">
      <inertial><origin xyz="0.062100 0.000000 0.000000"/><mass value="0.0837"/><inertia ixx="4.185e-06" ixy="0" ixz="0" iyy="1.097e-04" iyz="0" izz="1.097e-04"/></inertial>
      <visual><origin xyz="0.0621 0 0" rpy="0 1.570796 0"/>
        <geometry><cylinder radius="0.010" length="0.1242"/></geometry>
        <material name="pebble"/></visual>
      <collision><origin xyz="0.0621 0 0" rpy="0 1.570796 0"/>
        <geometry><cylinder radius="0.010" length="0.1242"/></geometry></collision>
    </link>
    <joint name="knee0" type="revolute">
      <parent link="femur0"/><child link="tibia0"/>
      <origin xyz="0.0950 0 0"/>
      <axis xyz="0 -1 0"/>
      <limit lower="-2.617994" upper="-0.349066" effort="2.9400" velocity="4.7"/>
      <dynamics damping="0.6255"/>
    </joint>

    <link name="foot0">
      <inertial><origin xyz="-0.006500 0.000000 0.000000"/><mass value="0.043300000000000005"/><inertia ixx="6.642e-07" ixy="0" ixz="0" iyy="6.642e-07" iyz="0" izz="6.642e-07"/></inertial>  <!-- + fixed claw prong (MJCF parity) -->
      <visual><origin xyz="-0.0065 0 0"/><geometry><sphere radius="0.0065"/></geometry>
        <material name="pebble"/></visual>
      <visual><origin xyz="0.012 0.0075 0" rpy="0 0 0.28"/>
        <geometry><cylinder radius="0.0035" length="0.028"/></geometry>
        <material name="pebble"/></visual>
      <collision><origin xyz="-0.0065 0 0"/><geometry><sphere radius="0.0065"/></geometry></collision>
    </link>
    <joint name="foot_fix0" type="fixed">
      <parent link="tibia0"/><child link="foot0"/>
      <origin xyz="0.1350 0 0"/>
    </joint>

    <link name="claw0_link">
      <inertial><origin xyz="0.000000 0.000000 0.000000"/><mass value="0.004"/><inertia ixx="1.000e-07" ixy="0" ixz="0" iyy="1.000e-07" iyz="0" izz="1.000e-07"/></inertial>
      <visual><origin xyz="0.012 -0.0075 0" rpy="0 0 -0.28"/>
        <geometry><cylinder radius="0.0035" length="0.028"/></geometry>
        <material name="pebble"/></visual>
    </link>
    <joint name="claw0" type="revolute">
      <parent link="foot0"/><child link="claw0_link"/>
      <origin xyz="0 0 0"/>
      <axis xyz="0 0 1"/>
      <limit lower="0.000000" upper="0.959931" effort="0.2300" velocity="9.5"/>
      <dynamics damping="0.0242"/>
    </joint>
  
    <link name="coxa1">
      <inertial><origin xyz="0.020000 0.000000 0.030000"/><mass value="0.0839"/><inertia ixx="3.233e-05" ixy="0" ixz="0" iyy="5.034e-05" iyz="0" izz="3.233e-05"/></inertial>
      <visual><origin xyz="0.020 0 0.030"/>
        <geometry><box size="0.060 0.032 0.060"/></geometry>
        <material name="pebble"/></visual>
      <collision><origin xyz="0.020 0 0.030"/>
        <geometry><box size="0.060 0.032 0.060"/></geometry></collision>
    </link>
    <joint name="yaw1" type="revolute">
      <parent link="base_link"/><child link="coxa1"/>
      <origin xyz="-0.1046162167924669 0.033991869381244225 0" rpy="0 0 2.827433388230814"/>
      <axis xyz="0 0 1"/>
      <limit lower="-0.698132" upper="0.698132" effort="2.9400" velocity="4.7"/>
      <dynamics damping="0.6255"/>
    </joint>

    <link name="femur1">
      <inertial><origin xyz="0.047500 0.000000 0.000000"/><mass value="0.0427"/><inertia ixx="3.074e-06" ixy="0" ixz="0" iyy="3.365e-05" iyz="0" izz="3.365e-05"/></inertial>
      <visual><origin xyz="0.0475 0 0" rpy="0 1.570796 0"/>
        <geometry><cylinder radius="0.012" length="0.0950"/></geometry>
        <material name="pebble"/></visual>
      <collision><origin xyz="0.0475 0 0" rpy="0 1.570796 0"/>
        <geometry><cylinder radius="0.012" length="0.0950"/></geometry></collision>
    </link>
    <joint name="hip1" type="revolute">
      <parent link="coxa1"/><child link="femur1"/>
      <origin xyz="0.0450 0 0.0610"/>
      <axis xyz="0 -1 0"/>
      <limit lower="-1.221730" upper="1.570796" effort="2.9400" velocity="4.7"/>
      <dynamics damping="0.6255"/>
    </joint>

    <link name="tibia1">
      <inertial><origin xyz="0.062100 0.000000 0.000000"/><mass value="0.0837"/><inertia ixx="4.185e-06" ixy="0" ixz="0" iyy="1.097e-04" iyz="0" izz="1.097e-04"/></inertial>
      <visual><origin xyz="0.0621 0 0" rpy="0 1.570796 0"/>
        <geometry><cylinder radius="0.010" length="0.1242"/></geometry>
        <material name="pebble"/></visual>
      <collision><origin xyz="0.0621 0 0" rpy="0 1.570796 0"/>
        <geometry><cylinder radius="0.010" length="0.1242"/></geometry></collision>
    </link>
    <joint name="knee1" type="revolute">
      <parent link="femur1"/><child link="tibia1"/>
      <origin xyz="0.0950 0 0"/>
      <axis xyz="0 -1 0"/>
      <limit lower="-2.617994" upper="-0.349066" effort="2.9400" velocity="4.7"/>
      <dynamics damping="0.6255"/>
    </joint>

    <link name="foot1">
      <inertial><origin xyz="-0.006500 0.000000 0.000000"/><mass value="0.043300000000000005"/><inertia ixx="6.642e-07" ixy="0" ixz="0" iyy="6.642e-07" iyz="0" izz="6.642e-07"/></inertial>  <!-- + fixed claw prong (MJCF parity) -->
      <visual><origin xyz="-0.0065 0 0"/><geometry><sphere radius="0.0065"/></geometry>
        <material name="pebble"/></visual>
      <visual><origin xyz="0.012 0.0075 0" rpy="0 0 0.28"/>
        <geometry><cylinder radius="0.0035" length="0.028"/></geometry>
        <material name="pebble"/></visual>
      <collision><origin xyz="-0.0065 0 0"/><geometry><sphere radius="0.0065"/></geometry></collision>
    </link>
    <joint name="foot_fix1" type="fixed">
      <parent link="tibia1"/><child link="foot1"/>
      <origin xyz="0.1350 0 0"/>
    </joint>

    <link name="claw1_link">
      <inertial><origin xyz="0.000000 0.000000 0.000000"/><mass value="0.004"/><inertia ixx="1.000e-07" ixy="0" ixz="0" iyy="1.000e-07" iyz="0" izz="1.000e-07"/></inertial>
      <visual><origin xyz="0.012 -0.0075 0" rpy="0 0 -0.28"/>
        <geometry><cylinder radius="0.0035" length="0.028"/></geometry>
        <material name="pebble"/></visual>
    </link>
    <joint name="claw1" type="revolute">
      <parent link="foot1"/><child link="claw1_link"/>
      <origin xyz="0 0 0"/>
      <axis xyz="0 0 1"/>
      <limit lower="0.000000" upper="0.959931" effort="0.2300" velocity="9.5"/>
      <dynamics damping="0.0242"/>
    </joint>
  
    <link name="coxa2">
      <inertial><origin xyz="0.020000 0.000000 0.030000"/><mass value="0.0839"/><inertia ixx="3.233e-05" ixy="0" ixz="0" iyy="5.034e-05" iyz="0" izz="3.233e-05"/></inertial>
      <visual><origin xyz="0.020 0 0.030"/>
        <geometry><box size="0.060 0.032 0.060"/></geometry>
        <material name="pebble"/></visual>
      <collision><origin xyz="0.020 0 0.030"/>
        <geometry><box size="0.060 0.032 0.060"/></geometry></collision>
    </link>
    <joint name="yaw2" type="revolute">
      <parent link="base_link"/><child link="coxa2"/>
      <origin xyz="-0.06465637775217206 -0.0889918693812442 0" rpy="0 0 4.084070449666731"/>
      <axis xyz="0 0 1"/>
      <limit lower="-0.698132" upper="0.698132" effort="2.9400" velocity="4.7"/>
      <dynamics damping="0.6255"/>
    </joint>

    <link name="femur2">
      <inertial><origin xyz="0.047500 0.000000 0.000000"/><mass value="0.0427"/><inertia ixx="3.074e-06" ixy="0" ixz="0" iyy="3.365e-05" iyz="0" izz="3.365e-05"/></inertial>
      <visual><origin xyz="0.0475 0 0" rpy="0 1.570796 0"/>
        <geometry><cylinder radius="0.012" length="0.0950"/></geometry>
        <material name="pebble"/></visual>
      <collision><origin xyz="0.0475 0 0" rpy="0 1.570796 0"/>
        <geometry><cylinder radius="0.012" length="0.0950"/></geometry></collision>
    </link>
    <joint name="hip2" type="revolute">
      <parent link="coxa2"/><child link="femur2"/>
      <origin xyz="0.0450 0 0.0610"/>
      <axis xyz="0 -1 0"/>
      <limit lower="-1.221730" upper="1.570796" effort="2.9400" velocity="4.7"/>
      <dynamics damping="0.6255"/>
    </joint>

    <link name="tibia2">
      <inertial><origin xyz="0.062100 0.000000 0.000000"/><mass value="0.0837"/><inertia ixx="4.185e-06" ixy="0" ixz="0" iyy="1.097e-04" iyz="0" izz="1.097e-04"/></inertial>
      <visual><origin xyz="0.0621 0 0" rpy="0 1.570796 0"/>
        <geometry><cylinder radius="0.010" length="0.1242"/></geometry>
        <material name="pebble"/></visual>
      <collision><origin xyz="0.0621 0 0" rpy="0 1.570796 0"/>
        <geometry><cylinder radius="0.010" length="0.1242"/></geometry></collision>
    </link>
    <joint name="knee2" type="revolute">
      <parent link="femur2"/><child link="tibia2"/>
      <origin xyz="0.0950 0 0"/>
      <axis xyz="0 -1 0"/>
      <limit lower="-2.617994" upper="-0.349066" effort="2.9400" velocity="4.7"/>
      <dynamics damping="0.6255"/>
    </joint>

    <link name="foot2">
      <inertial><origin xyz="-0.006500 0.000000 0.000000"/><mass value="0.043300000000000005"/><inertia ixx="6.642e-07" ixy="0" ixz="0" iyy="6.642e-07" iyz="0" izz="6.642e-07"/></inertial>  <!-- + fixed claw prong (MJCF parity) -->
      <visual><origin xyz="-0.0065 0 0"/><geometry><sphere radius="0.0065"/></geometry>
        <material name="pebble"/></visual>
      <visual><origin xyz="0.012 0.0075 0" rpy="0 0 0.28"/>
        <geometry><cylinder radius="0.0035" length="0.028"/></geometry>
        <material name="pebble"/></visual>
      <collision><origin xyz="-0.0065 0 0"/><geometry><sphere radius="0.0065"/></geometry></collision>
    </link>
    <joint name="foot_fix2" type="fixed">
      <parent link="tibia2"/><child link="foot2"/>
      <origin xyz="0.1350 0 0"/>
    </joint>

    <link name="claw2_link">
      <inertial><origin xyz="0.000000 0.000000 0.000000"/><mass value="0.004"/><inertia ixx="1.000e-07" ixy="0" ixz="0" iyy="1.000e-07" iyz="0" izz="1.000e-07"/></inertial>
      <visual><origin xyz="0.012 -0.0075 0" rpy="0 0 -0.28"/>
        <geometry><cylinder radius="0.0035" length="0.028"/></geometry>
        <material name="pebble"/></visual>
    </link>
    <joint name="claw2" type="revolute">
      <parent link="foot2"/><child link="claw2_link"/>
      <origin xyz="0 0 0"/>
      <axis xyz="0 0 1"/>
      <limit lower="0.000000" upper="0.959931" effort="0.2300" velocity="9.5"/>
      <dynamics damping="0.0242"/>
    </joint>
  
    <link name="coxa3">
      <inertial><origin xyz="0.020000 0.000000 0.030000"/><mass value="0.0839"/><inertia ixx="3.233e-05" ixy="0" ixz="0" iyy="5.034e-05" iyz="0" izz="3.233e-05"/></inertial>
      <visual><origin xyz="0.020 0 0.030"/>
        <geometry><box size="0.060 0.032 0.060"/></geometry>
        <material name="pebble"/></visual>
      <collision><origin xyz="0.020 0 0.030"/>
        <geometry><box size="0.060 0.032 0.060"/></geometry></collision>
    </link>
    <joint name="yaw3" type="revolute">
      <parent link="base_link"/><child link="coxa3"/>
      <origin xyz="0.06465637775217202 -0.08899186938124423 0" rpy="0 0 5.340707511102648"/>
      <axis xyz="0 0 1"/>
      <limit lower="-0.698132" upper="0.698132" effort="2.9400" velocity="4.7"/>
      <dynamics damping="0.6255"/>
    </joint>

    <link name="femur3">
      <inertial><origin xyz="0.047500 0.000000 0.000000"/><mass value="0.0427"/><inertia ixx="3.074e-06" ixy="0" ixz="0" iyy="3.365e-05" iyz="0" izz="3.365e-05"/></inertial>
      <visual><origin xyz="0.0475 0 0" rpy="0 1.570796 0"/>
        <geometry><cylinder radius="0.012" length="0.0950"/></geometry>
        <material name="pebble"/></visual>
      <collision><origin xyz="0.0475 0 0" rpy="0 1.570796 0"/>
        <geometry><cylinder radius="0.012" length="0.0950"/></geometry></collision>
    </link>
    <joint name="hip3" type="revolute">
      <parent link="coxa3"/><child link="femur3"/>
      <origin xyz="0.0450 0 0.0610"/>
      <axis xyz="0 -1 0"/>
      <limit lower="-1.221730" upper="1.570796" effort="2.9400" velocity="4.7"/>
      <dynamics damping="0.6255"/>
    </joint>

    <link name="tibia3">
      <inertial><origin xyz="0.062100 0.000000 0.000000"/><mass value="0.0837"/><inertia ixx="4.185e-06" ixy="0" ixz="0" iyy="1.097e-04" iyz="0" izz="1.097e-04"/></inertial>
      <visual><origin xyz="0.0621 0 0" rpy="0 1.570796 0"/>
        <geometry><cylinder radius="0.010" length="0.1242"/></geometry>
        <material name="pebble"/></visual>
      <collision><origin xyz="0.0621 0 0" rpy="0 1.570796 0"/>
        <geometry><cylinder radius="0.010" length="0.1242"/></geometry></collision>
    </link>
    <joint name="knee3" type="revolute">
      <parent link="femur3"/><child link="tibia3"/>
      <origin xyz="0.0950 0 0"/>
      <axis xyz="0 -1 0"/>
      <limit lower="-2.617994" upper="-0.349066" effort="2.9400" velocity="4.7"/>
      <dynamics damping="0.6255"/>
    </joint>

    <link name="foot3">
      <inertial><origin xyz="-0.006500 0.000000 0.000000"/><mass value="0.043300000000000005"/><inertia ixx="6.642e-07" ixy="0" ixz="0" iyy="6.642e-07" iyz="0" izz="6.642e-07"/></inertial>  <!-- + fixed claw prong (MJCF parity) -->
      <visual><origin xyz="-0.0065 0 0"/><geometry><sphere radius="0.0065"/></geometry>
        <material name="pebble"/></visual>
      <visual><origin xyz="0.012 0.0075 0" rpy="0 0 0.28"/>
        <geometry><cylinder radius="0.0035" length="0.028"/></geometry>
        <material name="pebble"/></visual>
      <collision><origin xyz="-0.0065 0 0"/><geometry><sphere radius="0.0065"/></geometry></collision>
    </link>
    <joint name="foot_fix3" type="fixed">
      <parent link="tibia3"/><child link="foot3"/>
      <origin xyz="0.1350 0 0"/>
    </joint>

    <link name="claw3_link">
      <inertial><origin xyz="0.000000 0.000000 0.000000"/><mass value="0.004"/><inertia ixx="1.000e-07" ixy="0" ixz="0" iyy="1.000e-07" iyz="0" izz="1.000e-07"/></inertial>
      <visual><origin xyz="0.012 -0.0075 0" rpy="0 0 -0.28"/>
        <geometry><cylinder radius="0.0035" length="0.028"/></geometry>
        <material name="pebble"/></visual>
    </link>
    <joint name="claw3" type="revolute">
      <parent link="foot3"/><child link="claw3_link"/>
      <origin xyz="0 0 0"/>
      <axis xyz="0 0 1"/>
      <limit lower="0.000000" upper="0.959931" effort="0.2300" velocity="9.5"/>
      <dynamics damping="0.0242"/>
    </joint>
  
    <link name="coxa4">
      <inertial><origin xyz="0.020000 0.000000 0.030000"/><mass value="0.0839"/><inertia ixx="3.233e-05" ixy="0" ixz="0" iyy="5.034e-05" iyz="0" izz="3.233e-05"/></inertial>
      <visual><origin xyz="0.020 0 0.030"/>
        <geometry><box size="0.060 0.032 0.060"/></geometry>
        <material name="pebble"/></visual>
      <collision><origin xyz="0.020 0 0.030"/>
        <geometry><box size="0.060 0.032 0.060"/></geometry></collision>
    </link>
    <joint name="yaw4" type="revolute">
      <parent link="base_link"/><child link="coxa4"/>
      <origin xyz="0.1046162167924669 0.03399186938124419 0" rpy="0 0 6.5973445725385655"/>
      <axis xyz="0 0 1"/>
      <limit lower="-0.698132" upper="0.698132" effort="2.9400" velocity="4.7"/>
      <dynamics damping="0.6255"/>
    </joint>

    <link name="femur4">
      <inertial><origin xyz="0.047500 0.000000 0.000000"/><mass value="0.0427"/><inertia ixx="3.074e-06" ixy="0" ixz="0" iyy="3.365e-05" iyz="0" izz="3.365e-05"/></inertial>
      <visual><origin xyz="0.0475 0 0" rpy="0 1.570796 0"/>
        <geometry><cylinder radius="0.012" length="0.0950"/></geometry>
        <material name="pebble"/></visual>
      <collision><origin xyz="0.0475 0 0" rpy="0 1.570796 0"/>
        <geometry><cylinder radius="0.012" length="0.0950"/></geometry></collision>
    </link>
    <joint name="hip4" type="revolute">
      <parent link="coxa4"/><child link="femur4"/>
      <origin xyz="0.0450 0 0.0610"/>
      <axis xyz="0 -1 0"/>
      <limit lower="-1.221730" upper="1.570796" effort="2.9400" velocity="4.7"/>
      <dynamics damping="0.6255"/>
    </joint>

    <link name="tibia4">
      <inertial><origin xyz="0.062100 0.000000 0.000000"/><mass value="0.0837"/><inertia ixx="4.185e-06" ixy="0" ixz="0" iyy="1.097e-04" iyz="0" izz="1.097e-04"/></inertial>
      <visual><origin xyz="0.0621 0 0" rpy="0 1.570796 0"/>
        <geometry><cylinder radius="0.010" length="0.1242"/></geometry>
        <material name="pebble"/></visual>
      <collision><origin xyz="0.0621 0 0" rpy="0 1.570796 0"/>
        <geometry><cylinder radius="0.010" length="0.1242"/></geometry></collision>
    </link>
    <joint name="knee4" type="revolute">
      <parent link="femur4"/><child link="tibia4"/>
      <origin xyz="0.0950 0 0"/>
      <axis xyz="0 -1 0"/>
      <limit lower="-2.617994" upper="-0.349066" effort="2.9400" velocity="4.7"/>
      <dynamics damping="0.6255"/>
    </joint>

    <link name="foot4">
      <inertial><origin xyz="-0.006500 0.000000 0.000000"/><mass value="0.043300000000000005"/><inertia ixx="6.642e-07" ixy="0" ixz="0" iyy="6.642e-07" iyz="0" izz="6.642e-07"/></inertial>  <!-- + fixed claw prong (MJCF parity) -->
      <visual><origin xyz="-0.0065 0 0"/><geometry><sphere radius="0.0065"/></geometry>
        <material name="pebble"/></visual>
      <visual><origin xyz="0.012 0.0075 0" rpy="0 0 0.28"/>
        <geometry><cylinder radius="0.0035" length="0.028"/></geometry>
        <material name="pebble"/></visual>
      <collision><origin xyz="-0.0065 0 0"/><geometry><sphere radius="0.0065"/></geometry></collision>
    </link>
    <joint name="foot_fix4" type="fixed">
      <parent link="tibia4"/><child link="foot4"/>
      <origin xyz="0.1350 0 0"/>
    </joint>

    <link name="claw4_link">
      <inertial><origin xyz="0.000000 0.000000 0.000000"/><mass value="0.004"/><inertia ixx="1.000e-07" ixy="0" ixz="0" iyy="1.000e-07" iyz="0" izz="1.000e-07"/></inertial>
      <visual><origin xyz="0.012 -0.0075 0" rpy="0 0 -0.28"/>
        <geometry><cylinder radius="0.0035" length="0.028"/></geometry>
        <material name="pebble"/></visual>
    </link>
    <joint name="claw4" type="revolute">
      <parent link="foot4"/><child link="claw4_link"/>
      <origin xyz="0 0 0"/>
      <axis xyz="0 0 1"/>
      <limit lower="0.000000" upper="0.959931" effort="0.2300" velocity="9.5"/>
      <dynamics damping="0.0242"/>
    </joint>
  

          
</robot>
