2BitwiseBard/rocky/cad/part_busboard.py

"""Hub shelf (I4/I5 body layout, option A): the harness hub UNDER the deck — picks 1, 9, 14
(2026-10-07), B92, B108, B128, B133, B134. The module keeps its name (run_all_checks and
check_printability call it); the part is `hub_shelf`. It retires `busboard_bracket`, the 46 x 36
star-board bracket on the deck grid (0, 20) / (0, 40): the leg drops meet the body under the deck
(BODY_LAYOUT_PROPOSAL fact 1), so the hub hangs there and the deck top carries the tray alone.

One printed part, printed as it is built (the plate's underside on the bed, the posts up):
  plate   params hub_shelf: the measured packing's outline (x / y: the union of the five boards'
          footprints + their plug / lead halos, PREP_REPORT_2 s3 'offtray' = case iii at bay_w 50,
          G3 b4b_pack + g3_verify), plate_t thick, its top at plate_top_z; Ø14 pads round the
          posts (a 10-wide arm only if a post were off the outline: none is); notches narrower
          than 6 closed with r 3 fillets (the packing left a 4.1 x 12 notch and a 2 mm slit)
  posts   three Ø8 at hub_shelf.posts from the plate top to the deck bottom, Ø3.4 bore, a
          Ø6.4 x plate_t counterbore in the underside: an M3 socket head from BELOW (post_screw
          below), flush, into the deck's blind Ø2.8 x 5 thread-forming hole (part_deck.DECK_HOLES
          shelf_post_*). From the top a head would sit under the docked coxa plate (params)
  top     the 12 V node (pick 9: a 30.5 x 30.5 FPV PDB, 36 x 36) on four Ø6.4 standoffs, the 40 x 30
          star on four Ø6.4 posts (34 x 24), standoff_h tall, blind Ø2.8 x 6 M3 thread-forming. The
          node's parts and its flat-soldered leads are taken as <= 6.0 over its board (NODE_LEADS,
          VERIFY with the PDB bought): leg 1's loom passes 1.20 over that, the tray cable 0.25
  under   pick 14: the bus adapter face-down (driven over the Pi's UART) on four bought Ø5 x 2.5
          round spacers, M2.5 x 8 from below into Ø2.05 thread-forming bores through the plate (a
          printed 2.5 standoff under the plate would float the whole plate 2.5 off the bed); the
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
