2BitwiseBard/rocky/(commit log)

2026-09-16 chore: put PROJECT ROCKY under version control (v0.8.0 drop + laptop sessions 1-2)
    First commit of the Pebble 1:3 pentapod robot project. Contents are the
    three v0.8.0 drops as extracted, plus the local laptop work done on
    2026-09-01 and 2026-09-08:
    rocky_v0.8.0_code/rocky live code: cad, sim, gait, driver, harness,
    perception, ros2, bench, bom, audio, docs
    rocky_v0.8.0_assets_cad CAD exports (cad/out is symlinked here)
    rocky_v0.8.0_assets_av_s8d audio/video drop
    patches/ the drop-vs-local record: the 2026-09-08
    harness diff and the pristine copies it
    applies to
    rocky.sh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
    [ROCKY_BOM.xlsx, avionics_tray.step, avionics_tray.stl, battery_sled.step, battery_sled.stl, belly_door.step, belly_door.stl, belly_skid.step]
2026-09-16 docs(repo): root README — layout, how to drive it, ground rules, current state
    Claude-Session: https://claude.ai/code/session_018w76xwBKj6h5GhpnqME3FM
2026-09-23 cad: D046 leg-chain joint rework (2026-09-17/18) — checkpoint before the servo-model rebuild
    Crown cap split off the coxa base, M3 axle + 683ZZ, femur hubs take the horn
    coupler, lips + straps replace zip ties (servo_mount.py), blank v0.2, joint
    coupons, check_assembly.py joint suite and the printability cantilever rule.
    CAD CI 23/23 tree clean (150 s on this machine). Regenerated cad/out, viewer
    and print pack. Local diff vs the v0.8.0 drop kept in patches/.
    Claude-Session: https://claude.ai/code/session_0147dyVvKxLRmCvJjDwaBeif
    [avionics_tray.step, battery_sled.step, belly_door.step, belly_skid.step, body_deck.step, busboard_bracket.step, calib_gauge_hip.step, calib_gauge_hip.stl]
2026-09-23 cad: D047 — leg chain rebuilt around the real ST3215 (STEP-measured); review, print plan, shopping list; repo hygiene
    Review (docs/REVIEW_2026-09-22.md): the v0.1 servo model was a guessed box
    wrong in five ways (28.8 not 32 tall, horn top 33.1 not 38, axis 10.2 not
    11.25 from the front, 45-degree hole pattern, no rear idler/rims/connectors),
    so every D046 leg part was designed for a servo that does not exist and the
    D046 yaw bearing stage would have failed. Servo v2 is derived from
    cad/ref/STS3215_03a.step (SO-ARM100, Apache-2.0) with a self-check against
    it; every number is in params.yaml marked "from STEP".
    D047 leg: yaw servo shaft-down in a cup on the I1 base; one C-shaped fork
    ridin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
    [avionics_tray.step, avionics_tray.stl, battery_sled.step, battery_sled.stl, belly_door.step, belly_door.stl, belly_skid.step, belly_skid.stl]
2026-09-23 media: the 2026-09-22 photo of the pre-D047 leg prints (the 'before')
    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
2026-09-23 repo: flatten to the code root, pyproject + CI + guides; sim/RL workflows verified; train_ppo resume guard
    The live tree is the repository root now: cad/out is a real git-lfs
    directory (the D047 exports the previous commit had dropped from the index
    are back, with cad/ref and leg_frame.py), media/ holds renders, the photo
    and the demo GIFs, rocky.sh lives at the root and defaults to its own
    directory, the drop directories and patches/ are gone. setup.py is replaced
    by pyproject.toml (extras: sim, rl, harness, hw, cad, dev; all six gait
    modules installable). .github/workflows/ci.yml runs the fast suites, the
    sim smoke, URDF parity and the slow harness test on every push and the CAD
    tree on ma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
    [ROCKY_BOM.xlsx, STS3215_03a.step, avionics_tray.step, avionics_tray.stl, battery_sled.step, battery_sled.stl, belly_door.step, belly_door.stl]
2026-09-23 ci: no GL on the runner — run_sim degrades to physics-only without a renderer; cad extra needs networkx; steps fail on their own exit codes
    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
    [run_sim.py]
2026-09-23 sim: shoves are shoves (rim half-sine, N·s/BW), BRACE holds when airborne, righter stall rule; v3 righter retrain recorded negative (D048)
    The "push flies and jitters" report, root-caused and fixed where it was a
    model problem, recorded where it was a policy problem:
    - sim/shove.py: half-sine force at the carapace's top rim (force + torque
    about the CoM) instead of a rectangular CoM pulse. The old demo strike
    (120 N x 0.25 s = 30 N·s, 4.6 BW·s) launched the robot at 9-11 m/s for
    11-15 m. Playground `push`, run_reflex_fallen (40 N peak x 0.4 s) and the
    new shove_envelope.py use it; standing tips at ~1 BW peak, walking
    20-30 N by direction. Push-envelope experiment scripts untouc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
    [audit_righter.py, eval_recover.py, pebble_reflex.py, playground.py, righter.py, rocky_recover_env.py, run_reflex_fallen.py, shove.py]
2026-09-24 playground: teleop in the terminal (viewer letters are MuJoCo's toggles), help, RL table, righter hot-swap, HUD; rl_dashboard.py
    - WASD in the viewer window toggled wireframe/shadows/auto-connect/static
    bodies (and SPACE paused the viewer): the MuJoCo viewer's own bindings
    fire alongside key_callback. Teleop now reads single keys at an empty
    terminal prompt (arrows, Shift+WASD/QE, SPACE, Shift+G) with line editing
    for commands; the window keeps arrows only. Docs say why.
    - help / help rl; rl (checkpoint table: env, reward, rate limit, steps,
    last return/len/entropy, recorded eval); righter NAME|off hot-swap; set
    reflex.stall_s / reflex.fallen_max_s; HUD marker + command arrow in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
    [playground.py, rl_dashboard.py]
2026-09-24 cockpit: browser playground on one running sim — cameras, switchable brains, vision, world editor, RL panel (D049)
    - sim/cockpit.py + sim/cockpit_ui.html (`./rocky.sh cockpit`, :8765): a sim
    thread runs the Playground loop with the harness goto controller + cliff
    detector folded in (real-time paced, speed/pause), renders a chase camera
    and a torso eye camera to MJPEG, serves an SSE state feed and a JSON API;
    a job queue keeps every MjData access on the sim thread.
    - Brains switch at runtime: Talk (regex intent), Local model (llama-swap,
    tool calling over the six tools + look), Claude (Anthropic API if keyed;
    else ./rocky.sh chat drives the same sim over MCP).
    - look: the eye fr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
    [cockpit.py, playground.py, test_world_builder.py, world_builder.py]
2026-09-24 cockpit: show geom group 3 (world objects were built but invisible), top-down map with click-to-goto, camera views, HUD in the chase stream, respawn keeps world bodies
    - Renderers/viewers hide geom group 3 by default and every obstacle is
    group 3 for the lidar: cockpit renderers + the playground and sim_backend
    viewer windows now enable it.
    - Map canvas (objects from the spec, lidar hits via /api/scan, robot,
    goto target; click sends a goto), follow/wide/top/low views, default
    azimuth behind the robot, HUD marker + goto flag drawn into the chase
    frame, eye camera raised above the coxa blocks.
    - _respawn uses mj_resetData so free world bodies (the ball) keep their
    spawn instead of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
2026-09-24 world_builder: world bodies go after the torso — the pushable ball had taken qpos[0:7] and every respawn dropped it onto the robot
    Every sim entry point addresses the robot's free joint as qpos[0:7]; a
    free world body inserted before the torso shifted that. Objects now go
    at the end of worldbody; test pins the qpos layout.
    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
2026-09-24 cockpit round two: feet feel for the floor (probe = void signal), recordings + replay, saved/random worlds, residual walker, voice, quit (D050)
    - Playground._probe: a planted foot without contact is lowered up to 30 mm
    at 120 mm/s; CliffDetector.update(..., probed_out=) makes a void "ran out
    of probe, still nothing". Cliff world still stops at the edge; rough
    terrain, rubble and 4x15 mm stairs are crossed; a 6 cm box ends as
    `stuck` (goto: stuck after 6 s without progress, timeout at 40 s).
    - Recordings: chase frames + every command -> mp4/gif/run.json; replay
    reloads the world and re-runs the commands on the live sim.
    - Worlds on disk (sim/worlds/*.json) + seeded random courses; R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
    [cockpit.py, playground.py, test_cliff_terrain.py, world_builder.py]
2026-09-24 cockpit ui: reconnect the MJPEG camera streams after a server restart or dropped connection (frame-counter watchdog)
    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
2026-09-24 cockpit: exit immediately on SIGTERM/SIGINT (uvicorn's graceful shutdown hangs on the endless camera/SSE streams and left stale instances behind)
    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
2026-09-24 cockpit round three (D051): gesture studio (keyframe JSON), chord designer + browser audio, gait lab + servo realism model, hardware bridge to the real bus (mock-verified), rocky.sh tailnet; fix rock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
    - gait/pebble_keyframes.py: gestures as keyframe data in gait/gestures/*.json, same
    (q, claw) contract as the code gestures; they join every gesture list (teleop,
    console, brains, MCP via the cockpit backend)
    - audio: chord words designed in the cockpit over chordspeak2's syllable model,
    saved to audio/custom/*.json + audio/samples_custom/*.wav; canon words read-only;
    chord audio plays in the browser (phone too), server speakers optional
    - sim/servo_model.py: bus-rate hol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
    [cockpit.py, hw_bridge.py, pebble_keyframes.py, playground.py, servo_model.py, test_d051.py]
2026-09-24 cockpit: the immediate exit on SIGTERM/SIGINT must be uvicorn's own handle_exit — uvicorn replaces handlers set before run(), so 9c0416f never took and stale instances survived cockpit-stop
    Verified: SIGTERM with an MJPEG stream open ends the process within a second.
    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
    [cockpit.py]
2026-09-24 D052: the sim stops flattering the servo; the studio cannot author what the robot cannot do; the bus gets a safe first move
    Full review round (4 expert reviewers + 29 adversarially verified findings + a
    three-lens review of the diff), then eight implementation packages:
    - one servo identity: params.yaml actuators/joints/gait/reflex/sensing blocks
    read by gait/rocky_model.py; MJCF, URDF, servo_model, shove, driver clamp,
    playground and cockpit all read it (old keys are YAML aliases, not copies)
    - physics: joint damping = stall/no-load (the DC torque-speed line, 0.626),
    leg forcerange = 0.65 x stall (continuous), foot mu 0.8 + torsional, foot
    sphere surface = IK foot point, claw doubl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
    [pebble.urdf, pebble.urdf.xacro]
2026-09-24 D052a: peak torque with a thermal budget, the shallow-angle cliff miss, spawn-pose bug, leftovers
    - physics: leg forcerange = stall (2.94 N.m, instantaneous) — the 0.65 x stall
    clip was wrong as an instantaneous cap: it held an unloaded joint at 3.06
    rad/s, below the servo's 4.7 no-load speed and the 4.0 free-leg budget.
    Damping unchanged (the DC line: 4.7 at zero load, 3.05 at continuous torque).
    The continuous budget is now a THERMAL model over time: rl_common.ThermalProxy
    in both RL envs (electrical torque, integrator matched to the driver mock's
    thermal curve: trips after 180 s at 0.85 x stall, 94 s at stall; derate ramps
    to continuous + a reward penalty), a THERMAL_LOAD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
    [pebble.urdf, pebble.urdf.xacro]
2026-09-24 cockpit voice: hold OR tap-to-toggle with pointer capture, a live timer, and explicit "too short" / whisper errors instead of "nothing heard"
    On the phone the hold-to-talk button lost its long press (callout, scroll,
    synthetic mouse events) and sent an empty container; the page then said
    "nothing heard" because the server treated any empty transcript the same.
    Now: pointer events with capture, tap starts / tap stops, hold releases to
    send, a recording timer on the button, a 48 px target on phones; the server
    refuses recordings under 1200 bytes or 0.4 s with the measured size/length,
    reports whisper HTTP errors, logs every voice request. Verified: a real
    speech clip through the phone path (we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
    [cockpit_brains.py]
2026-09-24 voice: fast whisper service (:8086, base.en, ~1 s), hands-free listening, fuzzy wake word, vocabulary prompt; B34 first retrain is negative
    - the whole voice path was 18-20 s per command: whisper-server :8082 runs
    large-v3-turbo on 6 CPU threads with beam search. New user unit
    whisper-fast.service (base.en, CPU, 8 threads, greedy, ~1 s per command);
    rocky.sh cockpit prefers it when up (ROCKY_WHISPER_URL overrides). GPU
    whisper rejected: the CUDA build would hold VRAM the llama-swap resident
    group needs.
    - cockpit: hands-free checkbox = open mic + level meter, utterances sent as
    trusted (no wake word) and straight to the brain; wake word tolerant of
    the small model's misspelling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
    [cockpit.py, cockpit_brains.py, test_cockpit_brains.py]
2026-09-25 vision: find_object behaviour (look -> box -> floor geometry -> goto, repeat), a vision bench on the cockpit worlds, and the small-brain model research
    - find_object(name): the vision model draws a box; bearing and distance come
    from where the box's bottom sits in the image through the eye camera's
    measured height and tilt (pixel_to_floor). Median bearing error 0.7 deg
    (lfm2.5-vl) / 0.75 deg (gemma-4-26b-a4b); the "estimate the numbers"
    prompt the spec asked for was 10-15 deg off because the small model copies
    the prompt's example numbers, kept as method=estimate for comparison.
    Gemma answers boxes y-first (box_order handles it). Walks only on
    confidence >= 0.4, scans 30 deg ot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
    [cockpit.py, cockpit_brains.py, test_find_object.py]
2026-09-25 D053 step 1: the robot as data — a RobotSpec built from params.yaml (legs, stations, joints, servos, links, ids) that the gait, the MJCF and the URDF read; design doc + design-change guide
    - cad/params.yaml: a `robot:` block whose every number is a YAML alias of an
    existing key (no second copy); the file parses to the same dict elsewhere
    - gait/rocky_model.py: RobotSpec / LegSpec / JointSpec, validate(), robot(),
    n_legs, stations_deg, leg_joint_names, actuator_order, id_table, topology
    hash, description digest; joint limits / id maps now read through the spec
    - gait/pebble_gait.py N_LEGS + STATION_DEG, sim/build_mjcf.py stations, leg
    count and actuator order, generate_urdf.py stati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
2026-09-25 scene memory + situational awareness: pose-tagged observations and located objects (persistent per world), brain/MCP tools remember / where_is / recall / go_back_to / forget, a situation line every c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
    - sim/scene_memory.py: observations {t, pose, kind, text, objects, world};
    objects merge within 0.25 m (confidence-weighted), up to 4 per name, names
    normalised; recall = name match, recency, closeness; 500-entry cap prunes
    low-value entries first; atomic off-thread saves to sim/out/memory/<world>.json
    (gitignored; opt-in in main(), RAM-only headless); corrupt files moved aside
    - find_object records every located sighting (box floor point pushed back by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
2026-09-25 cockpit: mount the shared-view + guide routes (/api/ui, /api/ui/events, /api/guide); the server honours the operator-set robot name as a wake word (has_wake_word extra names)
    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
2026-09-25 cockpit front end for phones: bottom tab bar, floating STOP, remote mode, lead/follow shared view, in-app guide, wake-word flow, memory map + panel + situation ticker
    - phone (<= 900 px): Drive / Talk / Make / World / Robot tabs, one group at a
    time, one-line swipeable header, a red STOP on every tab (space key + the
    stop tool), a 3-line console ticker, video streams only while Drive shows;
    desktop: the sidebar groups become tabs with a 'pin' that restores the
    accordion; every original element id kept
    - remote mode drops both MJPEG sources and enlarges the pad; lead/follow
    mirrors tab and panel between devices through sim/cockpit_shared.py
    (/api/ui, /api/ui/events 4 Hz SSE that s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
2026-09-25 brain-install + brain-bench: install downloaded brain GGUFs and measure them on the robot's jobs
    sim/brain_install.py: pure-Python GGUF header reader (qwen35 / gemma4 / lfm2, mmproj, split shards,
    partial-download markers), one folder per model id under /mnt/models, projector pairing (folder,
    Downloads, hard link from a sibling id, or hf download), manifest entries, an UNMEASURED llama-swap
    stanza from the family template inserted before the retrieval stack (groups/selectors/macros checked
    unchanged, YAML validated in memory before the write), dated config backup, restart + /v1/models poll.
    Copy-verify-fsync before the source is unlinked; --dry-run, --copy, --no-restart, --no-fetch, --json.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
    [brain_bench.py, brain_install.py, test_brain_bench.py, test_brain_install.py]
2026-09-25 brain prompt turn discipline, bench scorer + scratch gesture library, CI fix; first measured rows
    harness/local_brain.py: two standing rules for every brain — no second motion after the asked one has
    ended (find X / go back to X are complete when their tool returns), and say is one chord per turn
    (the 9B looped say() four times on 'how are you feeling' and gave up). Measured on qwen3.5-9b:
    16/20 -> 17/20 commands, p95 latency 16 s -> 7.3 s, describe 3/6 -> 5/6, no missed stop.
    sim/brain_bench.py: the describe side comes from the clause that names the ball ('the ball on my
    right and a purple structure on the left' is right; 'ahead and to the left' stays one clause;
    '..., slightly to the le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
    [brain_bench.py, pebble_keyframes.py, test_brain_bench.py]
2026-09-25 brain_bench --help smoke test: run the child with MUJOCO_GL=disable
    The pytest process carries MUJOCO_GL=egl (sim/cockpit.py sets it as a default at import, after
    mujoco is already loaded in-process), so a child inherits it; the CI runner has no libEGL and
    'import mujoco' dies there. --help never renders. Fixes CI on 4191811 and 59a6e98.
    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
    [test_brain_bench.py]
2026-09-25 D055: stop never waits for a model, move(forward_m, left_m), three brains measured, per-model box order
    Stop gate (sim/cockpit_brains.py): every operator line in the local / multimodal / claude modes goes through
    intent's stop words before any model, before the mode lock and without the wake word; a stop refuses the
    interrupted turn's later motion (operator_stopped) and any line queued behind it; a failed model chain
    after a stop does not fall back to the regex brain; ROCKY_STOP_FIRST=0 only for the bench.
    move(forward_m, left_m) in the robot frame (harness/local_brain.py move_target, the cockpit executor, the
    MCP server): the goto path unchanged, so every guard and result value is goto's;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
    [brain_bench.py, cockpit.py, cockpit_brains.py, test_brain_bench.py, test_cockpit_api.py, test_cockpit_brains.py]
2026-09-25 D055a: per-family prompt notes (B41) — Gemma 12B 20/20, Qwen 9B 19/20; thinking stays off
    sim/cockpit_brains.py: FAMILY_NOTES (prefix-matched on the model id; gemma and qwen3.5 by default,
    ROCKY_FAMILY_NOTES=0 off) appends explicit numbered rules to the system message, rebuilt per model in the
    fallback chain; thinking_for(model) sends enable_thinking only for ids in ROCKY_THINKING_MODELS. Measured
    with brain_bench (stop gate off in the bench): gemma-4-12b 17/20 -> 20/20 with no missed stop, qwen3.5-9b
    17/20 -> 19/20 with median latency 3.6 -> 2.9 s; the 12B with thinking on 16/20 at 13 s median. Roles
    unchanged. Rows + addendum in docs/BRAIN_MODELS_2026-09-24.md, decision D055a, backlog B4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
    [cockpit_brains.py, test_cockpit_brains.py]
2026-09-25 brain-install --uninstall ID [--delete-files]: cut one stanza + its manifest entries (+ the folder), restart and wait for the id to go
    Refuses folders holding files it does not know, keeps a hard-linked sibling projector, dated backups,
    --dry-run touches nothing; verified against the real config (the Q6 9B stanza, lines 419-437, is the
    one it would cut). Five tests.
    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
2026-09-26 D057: place recognition from senses — known / new / changed, off by default, with a three-verdict bench
    sim/place_memory.py: a place is a lidar signature (map-heading bins + a heading-invariant histogram,
    yaw-aligned), up to eight look-description embeddings (the always-warm llama-swap embedding model) and,
    on the real robot, a Wi-Fi fingerprint; recognize -> known | new | ambiguous | unknown with a confidence,
    a one-sense cap so a lone scan never says "known", thresholds set from the first measured run and pinned
    by a test that replays its rows; checked_objects from per-name eye presence, confirm_diff = two looks must
    agree, verdict_text <= 90 chars; places.json beside the scene memory.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
    [cockpit.py, cockpit_brains.py, place_bench.py, place_memory.py]
2026-09-27 bom: one current BOM (bom/BOM.csv + README + totals.py) replaces the xlsx and five order sheets
    Prices re-checked 2026-09-26; 16 x ST3215, D500 lidar, soft-case pack, ESP32 board as a bench tool,
    BNO085 on SPI, optional lines researched (INA228, VL53L4CD, remote kill, Wi-Fi).
    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
    [BOM.csv, ROCKY_BOM.xlsx]
2026-09-27 cad: leg harness channel through coxa_yaw_base, star-board bracket on real deck holes, deterministic exports, 28 checks
    - HWDOCS-01: the D047 base covered the deck's I1 pass-through; an 11 x 11 route now reaches the yaw plugs (6 checks)
    - HWDOCS-02: bracket v0.2 bolts to grid holes (0,20)/(0,40) with a layout audit
    - STEP write-if-changed + invariant PDF: regeneration no longer churns 57 STEPs
    - run_all_checks 28 modules (+servo STEP comparison), --derived regenerates previews/estimate/print pack/viewer
    - params: dead 683ZZ blocks out, bed_mm + xt60_panel_mm in; derived outputs regenerated (pre-D047 previews gone)
    - torso 1448.9 -> 1435.2 g, robot fingerprint ceb63a1254c3 -> 7d376178fe27; 60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
    [battery_sled.step, battery_sled.stl, busboard_bracket.step, busboard_bracket.stl, coxa_yaw_base.step, coxa_yaw_base.stl, dock_block.step, dock_block.stl]
2026-09-27 generic setup: machine knobs move to a git-ignored rocky.env (template rocky.env.example)
    rocky.sh and sim/envfile.py read it; code defaults are generic (models dir, quarantine list, whisper,
    key file optional, tailnet host from tailscale). CI pins MuJoCo 3.12 / build123d 0.11.1, fetches only
    the LFS file the CAD job needs; test fixtures lose the owner's tailnet host and scratchpad paths.
    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
    [brain_bench.py, brain_install.py, cockpit_brains.py, envfile.py, place_bench.py, place_memory.py, test_brain_bench.py, test_brain_install.py]
2026-09-27 core: driver sign bits per register, ROS 2 ids by joint name, watchdog ladder inside the D052 envelope
    - STS PRESENT_LOAD bit 10 / POSITION_OFFSET bit 11 (VERIFY-ON-BENCH), offsets past +-2047 refused
    - RockySystem derives servo ids from joint names (claws were interleaved), soft-enable order
    - demo_walk budgeted (coxa 27.9 deg, was 49.8 past the 40 deg limit); gait gif + joint plot regenerated
    - RetryPolicy stages derived from the gait budget; chord-speak v0 + audition removed
    - harness drops pre-D056 compatibility paths; D056 snapshot fixtures vendored so CI runs them
    Claude-Session: https://claude.ai/code/session_0147dy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
    [bus.py, demo_walk.py]
2026-09-27 sim: experiments move to sim/experiments/, shared helpers to sim/scenes.py, dead artifacts out
    - 20 one-off experiments + their pre-D052 records (results/pre_d052/) leave the sim root
    - scenes.py holds what live code imported from experiment scripts (harness, playground, lidar)
    - flaky two-look test fixed (the combiner's real invariant); run_sim / RL panel no longer rewrite tracked media
    - negative-result checkpoints, smoke outputs, stale logs with home paths removed
    - run_fairing used a different rubble field from its baseline: fixed
    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
    [audit_righter.py, cockpit.py, cockpit_shared.py, diag_brace_phase.py, eval_recover.py, exp_paths.py, hw_bridge.py, playground.py]
2026-09-27 rerun: every experiment + record on fingerprint 7d376178fe27, demo media regenerated
    Results in sim/experiments/results/ (pre-D052 records untouched in results/pre_d052/). Moved verdicts:
    stuck at 40 mm 0/4 -> 2/4 with the budgeted watchdog (D023), gestures2 turn 48 deg / sidestep 140 mm
    (D040), reflex_fallen fell 4/5 (D042/D048), knee self-right 49.6 % WARM (D044), rubble reliable <= 25 mm
    (D017); held: system righting 20/20 vs 11/20, shove floor 29 N standing, run_sim 246 of ~261 mm.
    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
    [rl_dashboard.py]
2026-09-27 docs: condensed, current and generic; history archived under docs/archive/
    - README status + setup (LAPTOP_SETUP merged), BUILD_LOG 1375 -> ~720 lines (sessions 1a-8d archived verbatim)
    - decisions D036-D057 condensed to ADR-lite (full rows archived), AMENDED markers, D058-D060 added
    - SIM_GUIDE 1375 -> 825 lines; new PLACES.md (D057), BRAINS.md (D055), PERCEPTION_PLAN.md (vision + sensing)
    - RL_TOUR folded into RL_GUIDE; MCP_CONTRACT_v0, PLAYGROUND, print-night sheets, BUS_STARBOARD folded + removed
    - hardware docs corrected against CAD/BOM: harness route, bracket v0.2, Pi 5 pin map draft, bench runbook
    - master plan v1.1 archived with a superseded table and the D016 correction up front
    Co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
    [brain_bench.py, bus.py, check_assembly.py, cockpit_brains.py, gen_print_pack.py]
2026-09-27 final pass: ruff in CI, tests ignore rocky.env, bench mock runs out of the tree, CAD checks fail loudly, reviews applied
    - conftest.py pins ROCKY_ENV_FILE=/dev/null (tests run on the reference setup, as CI does)
    - ruff F + E9 clean tree-wide, CI step added; ruff pinned in constraints.txt
    - bench: --mock writes bench/out/mock/, pose_check works on a partial (one-leg) bus
    - six part modules + part_shell bed fit now fail the exit code; params_rev D059
    - benches force their own cockpit conf/memory/gesture dirs; MCP server follows ROCKY_COCKPIT_PORT
    - gesture audit record committed (sim/out/audit_gestures.json); bench loads from the torque audit
    - two-lens review (docs truth + info loss, code + C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
    [BOM.csv]
2026-09-28 D061: FreeCAD in the CAD loop — leg stress check, cad-open, part drawings
    - cad/fem_check.py (rocky.sh cad-check --fem): linear-static FEA of the five
    load-bearing leg parts with gmsh + CalculiX (the FreeCAD Flatpak carries
    both; SKIPPED without them) under servo-limited foot loads (V 60.3 N knee,
    R +/-16.4 N hip, L +/-39.2 N yaw) and stall torque on the horn coupler,
    judged as von Mises and across-layer tension vs params.fem (PETG, VERIFY).
    Validated against beam theory (cad/test_fem.py, also in CI's cad job).
    First run: base 2.93, fork 3.03, knee carrier 3.92, coupler 7.81 PASS;
    femur 1.22 FAIL in the lateral cases (B74, fix proposed, not applied).
    - rocky.sh cad-open: STEP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
    [fem_check.py, fem_tools.py, gen_drawings.py, params.yaml, run_all_checks.py, td_sheet.py, test_fem.py]
2026-09-28 ci: the cad job installs the dev extra (pytest) for cad/test_fem.py
    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
2026-09-28 D062: femur closed box (B74), sled fits its bay (B72), print pack rebuilt
    - part_femur: plate B deck over the bridge + 8 mm rails; fem_check femur
    1.22 -> 2.18 (all five leg parts pass), knee deflection 4.5 -> 1.06 mm;
    the plate-B M3 holes no longer break out of the rails (new check), and
    take M3 x 12 (BOM A-18).
    - battery sled: pack_w 46 -> 44 (sled 48.8 mm in the 50 mm bay); part_battery
    fails when sled + pack exceed the bay.
    - params_rev D062, fingerprint 1f953c89f979, robot 2694.6 g; MJCF, URDF,
    mass budget, TOOLS.md regenerated; walk 247 mm, standing shove floor 30 N,
    knee self-right 50.3 %, recover1 system 20/20 unchanged; records updated.
    - gen_print_pack: 44-page pack per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
    [BOM.csv, battery_sled.step, battery_sled.stl, coupon_idler.step, coupon_idler.stl, femur_plate_b.step, femur_plate_b.stl, femur_plate_b_posed.step]
2026-09-28 bom: prices re-checked 2026-09-28, picks and traps from a fresh research pass
    - Servos from a source that ships the aluminium horn the couplers are cut
    for (Waveshare 12 V SKU; Feetech's own sheet lists a POM horn); the
    $16.99 Waveshare SKU is the 7.4 V one.
    - Pi 5 4 GB (the brains run on the desk GPU), microSD at its real price.
    - D500 lidar size corrected to the datasheet's 54.0 x 46.3 x 35.0 mm
    (the old 38.6 x 38.6 x 33.5 was wrong); AliExpress LDROBOT store $62.
    - Magnet strikes must be steel washers (304 is barely magnetic); roll-
    wrapped tube; 11 mm OD springs in two wire sizes; pre-crimped JST-XH
    instead of a crimper; KW11 does not fit; optional filament dryer (X-19).
    - Tota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
    [BOM.csv]
2026-09-28 docs: SERVO_NOTES — is the ST3215 good enough, what limits fluid motion (B76-B79)
    A research pass (repo demands, the servo, alternatives, fluid-motion
    techniques; every claim checked against primary sources by a second
    reader). Verdict: the right servo to start with; it walks at ~12 % of stall,
    but it is a stiff position servo with no current loop, and most of the
    jerkiness Pebble would show today is software: the swing lands at
    188 mm/s, command changes snap a joint up to 28° in one tick, the bridge
    streams ACC 0 / speed 0 with no interpolation, keyframes stop at every key.
    Backlog: B76 fluid-motion fixes (ranked), B77 the sustained budget is a
    guess twice the datasheet's rated torque (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
    [BOM.csv]
2026-09-28 docs: ASSEMBLY_GUIDE — the build, step by step, from the CAD; it found B80-B96
    docs/ASSEMBLY_GUIDE.md takes the printed parts and the BOM to a robot
    powered up on its stand, in build order: prep and the servo desk bring-up,
    the leg (with its bench power lead and jig calibration), the foot, the body
    frame, wiring, docking + power-up, the carapace, and one open list.
    cad/gen_assembly_views.py draws its 13 pictures from the CAD (byte-stable,
    now in cad-check --derived: 34/34).
    Five sections were written from the code and each checked by a second
    reader; a critic found contradictions and suspected CAD faults, and every
    fault was settled by building the parts and measuring. Seventeen are real: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
    [BOM.csv]
2026-09-29 tests: never collect cad/test_viewer.py (a browser script, not a pytest module)
    With the viewer extra installed, pytest would import it and launch Chromium
    at collection time; without it, collection errored. Run it directly:
    python3 cad/test_viewer.py (8 modes, 0 console errors on 2026-09-28).
    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
2026-09-29 D063: the leg is buildable, the shell latch works, smoother motion
    CAD (the faults the assembly guide found, each implemented then
    adversarially reviewed):
    - B80/B81: the coxa fork slides onto the yaw servo and the blank (0 mm³ on
    the whole path; new check_assembly J1 path + seat checks). Opening the
    idler pocket lost the wall an inward foot push bears on (R- SF 0.49), so
    the fork gets side cheeks: SF 2.47 (governs), +5.5 g per fork. The horn
    face bears on a flat hub top.
    - B82 knob keys an M3 x 16 hex head; B83 the I6 set screw clamps; B87 the I3
    latch assembles and bites (turned from below with a flat screwdriver);
    B88 hatch magnets seated; B89 Pi standoffs 58 x 49; B90 IMU pa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
    [BOM.csv, avionics_tray.step, avionics_tray.stl, body_deck.step, body_deck.stl, coupon_yaw_hub.step, coupon_yaw_hub.stl, coxa_fork.step]
2026-09-30 cockpit: the chat box and mic sit on the Drive tab; console sentences go to the brain
    On a phone the page opens on Drive, where the only text box was the console:
    sentences typed there ("go forward and then wave") came back "unknown command",
    and the 🎤 was out of sight on the Talk tab. The chat row (box, send, 🎤,
    hands-free) is now one wrapper that placeTalkbar() moves to wherever the operator
    is (Drive: above the pad, with the brain's last answer under it; Talk and the
    pinned desktop accordion: under the conversation). A console line the parser
    calls an unknown command or word is sent to the brain as typed chat. One mic,
    moved with its handlers; the guide says where the controls are.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
2026-09-30 9n: D063 follow-ups (B111-B115), the recover7 curriculum retrain, B103 and B116 measured
    - B111: experiment time limits follow the envelope (run_stuck, run_fairing, run_stuck_voiced,
    sim_lidar's demo); rubble ladder and lidar lap re-recorded (SLAM-lite ATE 59.2 -> 9.2 mm).
    - B112: run_cliff_safestop judges the safe-stop without the march; passes (margin 228.8 mm),
    and its --retreat-cycles 0 control fails.
    - B113: ArmedGait's envelope was 44.6 mm/s against WaveGait's 34.2; now 33.2 mm/s / 0.174 rad/s.
    - B114: sim_backend's goto cap derives from capabilities.goto_cap_s() (55 s, was 20 s); a
    timeout ends in safe_stop.
    - B115: fem_check formats SF / stress / deflection with fixed decimals;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
    [eval_ppo.py, fem_check.py, pebble_gait.py, pebble_reflex.py, rl_common.py, rl_dashboard.py, rocky_env.py, rocky_recover_env.py]
2026-10-01 9o: the 87 s detour goto cap (B116), torque audit counts the hands once (B106), CAD tidy (B105, B107, B108, B110)
    - B116 (owner: "yes, apply the 87 s goto cap"): a goto that has entered a detour gets
    goto_cap_s with the reach grown by two detours (87 s at the 34.2 mm/s envelope) and ends at
    it even mid-detour (answers <= 88.5 s); a goto that never detoured keeps 55 s. go_back_to's
    proxy timeout is derived: 4 x (87 + 1.5) + 12 = 366 s. Verify on the shipped rule: 214/214
    as derived; around an obstacle 16/78/80/15 arrive at 1.0/1.2/1.5/2.0 m (55 s: 15/38/0/0).
    - B106: the hands are inside the tibia link; the audit weighs the robot at 2727.8 g = the MJCF.
    Self-right knee 1.496 -> 1.39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
    [avionics_tray.step, avionics_tray.stl, belly_door.step, belly_door.stl, latch_housing.step, latch_housing.stl, pebble.urdf, pebble.urdf.xacro]
2026-10-05 9p: the body-layout prep rounds recorded (B117-B138): the keel tub is safe in the sim, the I1 leg port cannot dock as drawn, decisions 13/14 measured
    Docs only; nothing in cad/, sim/ or gait/ changes (fingerprint 87215110e9c4).
    - BUILD_LOG 9p: two read-only rounds (39 agents), what they measured and what they refuted.
    - DESIGN_BACKLOG B117-B138: the I1 dock fault and its three verified fixes (seats recommended,
    owner sign-off), the stance load path (thumbscrews, not the hook; plate SF 0.74), the leg-plug
    pass-through, the Ø10 grommet, coxa base x carapace 42.8 mm3, three turn points inside the tub,
    the Pi part height, one usable USB port (adapter on UART), the cliff-guard ceiling on a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
2026-10-07 9q wip 1: the I1 seats fix (decision 15) + the body-layout foundation (params, keep-outs, deck hole table)
    The owner's 15 body-layout picks came in on 2026-10-07 (desk page, layout v10). This is the first
    step of the build, on a branch until the whole tree is green and every published number is re-run.
    I1 leg port, "seats" (B117, I1_DOCK_OPTIONS.md section 4, graft seat_relief_x0 -46):
    - params leg_port: dowel_xy -> seat_xy [(-32, +-17.3)], hook_slot_x -47.0, hook_slot_w 6.2 (outboard),
    seat_* / hook_stem_gap / hook_foot_gap / plate_ext_half_w new, dowel_d / dowel_engage gone; print.seat_fit.
    - iface: _seat_frustum, leg_port_seats, leg_port_sockets(fit), hook_geometry, seat_posts_symdiff,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
    [body_deck.step, body_deck.stl, coxa_yaw_base.step, coxa_yaw_base.stl, fit_ladder.step, fit_ladder.stl, jig_column.step, jig_column.stl]
2026-10-07 deck v0.5 (D064): cut the body-layout hole table; iface keep-out loose ends
    part_deck (v0.4 -> v0.5, the owner's picks 1, 2, 7, 8, 14):
    - body_deck() cuts DECK_HOLES (21 entries): six grid holes opened to 3.4 for the tray tabs (four also
    hang the tub), the tub hangers (+-58, -18), the three hub-shelf posts BLIND 2.8 from the underside
    (5 deep, 1.0 skin: an M3 head on top at (+-50, 34) meets the docked coxa plate extension, 5.41 mm^3),
    the (0, 50) 12.5 x 7.5 r1 trunk slot + zip anchors (+-12, 50), the tray's I3 strike at (0, -43)
    (frame turned 180 = tray_rot_deg), six unused 2.8 grid holes.
    - Removed: STRAP_SLOTS/STRAP_SLOT_WH (B50), GROMMET_XY/GROMMET_D + ZIP_ANCHORS (power comes fro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
    [check_dock.py, iface.py, part_deck.py]
2026-10-07 part_stand: the crown becomes the U-cradle that holds the robot by its keel tub (B85, pick 1)
    stand_crown loses its three deck-edge arms (at az 54 / 126 they would run
    through the hub shelf) and becomes a cradle on today's skirt: a 6 mm floor
    x +-45 under the tub's bottom (z -55.4, iface.bay_tub_extent), two 25 mm
    walls 0.5 outside the tub's y faces (-47.4 / 7.4), open at both x ends so
    the sled swaps on the stand, and a Ø5.4 x 1.2 x-stop pin at body (0, -20)
    into the tub floor's Ø6 x 1.5 blind hole (params stand). It touches only
    the tub: 0 mm^3 with the shelf box, deck, docked bases, hook envelopes
    'any', drops +0 / +5, lanes, carapace (it can stay on), sled path and both
    tub ends.
    Meas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
    [part_stand.py, print_estimate.py]
2026-10-07 part_avionics: the tray at its measured home (B51, I4 revised by decision 11)
    The tray now reads its pose from params (tray_xy (0, 0), tray_rot_deg 180, bulkhead north,
    tongue south). The rails' tabs turn inboard, with their holes exactly on DECK_HOLES'
    (+-40, -20/0/20); a ray test against the table passes. The channel sits tray_lift 2.0 higher,
    which leaves 3.4 / 3.1 mm over the M3 button heads. The wings become three 10 mm lugs under a
    windowed lip (pick 7): they lift free from slide 8.0 to 17.0, so lug_release 16 sits inside
    8.3..16.7. The release path (slid +-16, then lifted 5..45) is 0 mm^3 against the rails, the
    coxa bases, the yaw servos and the yawing fork + hip servo. The plate stan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
2026-10-07 9q shelf: part_busboard becomes option A's hub shelf under the deck (picks 1, 9, 14; B92, B108, B128, B133, B134)
    The star-board bracket on the deck grid retires (busboard_bracket and its two
    tracked exports): the leg drops meet the body under the deck, so the harness
    hub hangs there. hub_shelf is one printed part built to params hub_shelf, the
    measured case iii at bay_w 50: a 3 mm plate (the five boards' footprints +
    halos, top z -36.3) on three Ø8 posts at (-50, 34), (50, 34), (26, 64), each
    hung by an M3 x 30 from BELOW (head flush in a Ø6.4 x 3 counterbore) into the
    deck's blind Ø2.8 x 5 shelf_post_* hole (tip 1.3 short); the PDB (30.5 x 30.5)
    and the star (34 x 24) on Ø6.4 x 5 threa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
    [busboard_bracket.step, busboard_bracket.stl]
2026-10-07 D064 sim: the belly, the torso's real mass distribution, the righter's hip clamp (pick 13)
    The sim never had a belly: its lowest torso surface was the cylinder at z +6
    (124 mm over the ground) while option A's keel tub hangs to -55.4 (62.1 mm
    settled), and the torso's mass sat on two cylinders at z 24.5. Pick 13 asks for
    the belly in the sim plus a FALLEN/RIGHTED-only hip clamp on legs 1-4 (B97,
    B130, B138, decision 13).
    - gait/rocky_model.py: bay_tub_extent_mm() (the same sums as
    cad/iface.bay_tub_extent: x -97.5..101.9, y -47.4..7.4, z -55.4..-18.0 at
    bay_l 194), hub_shelf_extent_mm() (params x/y grown to the hull of the three
    Ø14 post pads: x -57..57, y 12.2..71, z -54.4..-10), be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
    [pebble.urdf, pebble.urdf.xacro]
2026-10-07 bay: the keel tub as parts (B84) - bay_tub, bay_lid, bay_door (part_bay)
    Option A's battery bay, built to params battery_sled / iface.bay_tub_extent and the
    owner's picks 1-12. part_bay draws and proves it (every check prints, exits non-zero):
    - bay_tub: open-top U, rails integral (sled rests 2.10 up: stack 32.10 of 33), nose
    chamfered 10 (pick 10); the dock's floating XT60 carrier printed into the nose (pick 4)
    on four 14 x 1.2 x 1.2 flexure webs inside a +-0.85 stop window (not dock_block's 2.2:
    42.9 MPa at the stop); the loop key's XT60 pocket above it (pick 3); the south-wall
    latch boss with the I3 strike (pick 12, latch_verdict clean); B126 driver columns
    through floor and ro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
    [belly_door.step, belly_door.stl, belly_skid.step, belly_skid.stl, dock_block.step, dock_block.stl, sled_rail.step, sled_rail.stl]
2026-10-08 9q latch: the tray's I3 strike slotted along the slide, the tray comes out (B51, pick 7)
    The rotor hangs 5.8 into the deck strike and rises only 3.8 at OPEN, so in a
    round strike 2.0 of shaft pinned the tray's 16 mm slide (2.20 / 12.15 / 36.18
    mm^3 at 0.5 / 1 / 2). Now, as the tray agent measured it:
    - iface.latch_strike(frame_t, slide=0.0): slide > 0 draws the bore out along
    the entry line into a through slot (slide + LUG_R long, LATCH_SHAFT_D + 2 FIT
    wide). slide 0 is byte-identical (BREP sha256 unchanged at 6.0 and 6.5; the
    five sector strikes 564.58 mm^3 as before). Docstrings: bay_l 192 (x
    -97.5..99.9), bay_tub_extent's left-out protrusions, leg_drop_keepout's false
    drops+5 c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
2026-10-08 9q wiring: close the bay / shelf / stand requests; retire the old parts everywhere
    part_bay: B133's 14 AWG exit (Ø5.5 on the feed's axis through the NE nose chamfer's middle,
    >= 1.2 of wall round it) and a snap clip for its riser on the north wall (45-deg wedge, no
    support); under leg 4's drop nothing can hold the feed (the 5.4 window), measured and printed.
    Loom tie bars (rod + post) beside the (+-40, 0) lid bosses for the leg 2/3 looms, 1.00 off lane
    A. The x-stop hole confirmed Ø6.3 x 1.5 at (0, -20), sharp mouth, now exactly 1.5 deep (was
    1.49). Checks against part_stand's REAL crown and part_busboard's REAL shelf (the params boxes
    are gone), the cradle's no-proud rule, and on the stan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
    [check_printability.py, gen_assembly_views.py, gen_print_pack.py, make_viewer.py, mass_audit.py, params.yaml, part_bay.py, part_busboard.py]
2026-10-08 9q wip 3: integration - latch + wiring merged, the CAD tree green, the sim on real masses
    Merges build/wf3-latch (cec4b15: the tray's I3 strike slotted along the slide, the
    tray comes out) and build/wf3-wiring (80cebbb: the bay / shelf / stand requests
    closed, the retired parts gone everywhere), then closes their requests to each
    other and runs the whole pipeline on one tree.
    CAD
    - part_busboard reads the adapter's holes and the buck's cap_l from
    part_avionics.BOARDS (the one copy, B108); its ADAPTER_HOLES / BUCK_CAP_L copies go.
    - part_deck: the grid-hole job text names the hub shelf, not the star-board bracket.
    - make_viewer: tray_latch_boss in the body row.
    - run_all_checks: 30/30 modu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
    [avionics_tray.step, avionics_tray.stl, battery_sled.step, battery_sled.stl, bay_door.step, bay_door.stl, bay_lid.step, bay_lid.stl]
2026-10-08 9q wip 4: review fixes - shell vs docked base, tray release with the carapace, sim mirrors checked, belly-free drops, resume contract
    Blockers
    - part_shell: every docked coxa_yaw_base cut 42.80 mm^3 into its sector (the cup's back
    wall, leg x -38.5 = body r 71.5, stood 0.5 inside the leg arch's x 72; on main too).
    cup_back_relief() takes the sector FIT off the wall's back, sides and top, over the
    wall's width only (x 71.2..73, |y| <= 9.8, z -0.3..45.5): moving the whole arch in to
    71.2 would also cut the latch pad and the feet (its |y| <= 40 profile). keepouts() now
    holds the real station-posed base + yaw servo, gated at 0 mm^3, and the sector-to-base
    gap is gated >= FIT: 0.00 /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
    [pebble.urdf, pebble.urdf.xacro, preview_shell_sector.stl, preview_shells.stl, shell_sector.step, shell_sector.stl]
2026-10-08 9q wip 5: every published sim record re-run on deae868522cc (the belly model)
    The numbers agent re-ran each experiment the docs quote, old model 87215110e9c4 vs new
    deae868522cc, with a third tree (belly contact off) to separate the belly from the mass:
    walk 189 mm (same), turn 41.7 (41.8), envelope 34.2 mm/s / 0.185 rad/s (kinematic, same),
    righting 198/200 (197), no-righter baseline 104/200 (87: the lower CoM), system 20/20,
    standing shove floor 30 N (1.08 BW), self-right knee 1.46 N.m (49.5 %, WARM), rubble 30 mm
    3/4 (2/4) / 35 mm 1/4 (2/4), cliff safe-stop PASS; the void guard's lip band no longer
    FALLS (0/364 by the D063 criterion): the keel tub catches the robot at 20-24 deg and it
    han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
2026-10-08 9q: the body layout built from the owner's 15 picks (D064) - the docs, the buy-and-print order, the code map, the tray tab holes
    Documentation for the D064 build, after the five build workflows (d99cdc2 the I1 seats fix and
    the foundation; a82f8ad the six parts; ef7c923 integration; 3ec6ab5 review fixes; c0947bf the
    re-run records):
    - INTERFACES I1 (seats as built, the stance load path, the FEM finding), I3 (the slide-slot
    strike), I4 and I5 revised (decision 11); WIRING_HARNESS under the deck (shelf, lanes, the
    14 AWG route, the (0, 50) slot, UART for the bus adapter, one USB-A); SERVO_NOTES numbers.
    - BOM: B-24 = the 30.5 x 30.5 PDB; new B-25..B-30, C-05, X-20 (the carrier's female XT6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
    [BOM.csv, body_deck.step, body_deck.stl, pebble.urdf, pebble.urdf.xacro]
2026-10-08 recover8_d064: the righter retrained on the D064 model, shipped (B146; B34 partly met)
    12 M steps of the recover7 recipe with the D064 defaults (belly, real torso inertial, hip floor
    -51.05 on legs 1-4, belly-free drops), unit rocky-train-recover8, 2026-10-08 08:26 -> 10:06.
    Nominal servo: raw 0/20 (stands up tilted ~19 deg), system 20/20 by the stall ramp, 0 belly
    contacts. Randomised servo (latency 10-40 ms) + DR + noise: raw 12/20, system 18/20 with 3
    hand-off exits of 12 falls - the first hand-offs under the supervisor on the D052 contract
    (recover1 on the same model and servo: 19/20, 0 hand-offs). Shove audit: 31 % pinned vs
    recover5_v3_warm's 55 %. righter.default_ckpt() now prefers re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
    [righter.py, rl_dashboard.py]
2026-10-09 D065 wip 1: BodyLeveler (gait/pebble_level.py), supervisor opt-in, level_xy, budget(level_slope), margins(normal=)
    - gait/pebble_level.py: BodyLeveler, numpy only. Integral law on the IMU tilt
    (filter 0.2 s, radial deadband 0.5 deg, tau 0.6 s, plane tilt capped at
    20 mm/s at R0), raise-only window 0..30 mm over the nominal footholds with
    anti-windup, per-leg rate-limited plane copies (stance 20 mm/s, airborne
    swing 40, held inside the 15 mm band), evaluated every call at
    WaveGait.level_xy; time-based 50 Hz tick; holds, release, reset, status.
    - ReflexSupervisor(leveler=None): opt-in; step(grav=, switches=, level_hold=).
    Offsets go on before last_feet_raw (probe_dz untouched), PLA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
    [params.yaml, pebble_feasibility.py, pebble_gait.py, pebble_level.py, pebble_reflex.py, rocky_model.py, test_level.py]
2026-10-09 D065 wip 2: sim wiring (IMU mount error, latency, level on|off, HUD) + terrain bench + tests
    - sim/sim_imu.py: SimIMU(mount_deg, mount_axis), a fixed rotation on grav and gyro (a
    constant tilt bias); mount_deg 0 keeps the ideal path and the noise draw order.
    - sim/playground.py: step() reads the IMU with t (a spec's latency now applies);
    Playground(imu=, level=) + set_imu(spec) kept across reset_guards; _make_sup builds the
    supervisor with its BodyLeveler (the cockpit's _respawn uses it); holds from the gate,
    the void, probe_out, a gesture and a late seek; `level on|off`, `set level.<key>`,
    guard_status level_* fields, show, motion_reason, sim2real forces it off and refuses a
    sta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
    [cockpit.py, playground.py, run_lip_grid.py, sim_imu.py, terrain_bench.py, test_playground_guards.py, test_terrain_bench.py]
2026-10-09 D065 wip 3: terrain bench results (S0/S1/S2 x 3 IMU modes), docs
    - sim/out/terrain_bench.json: 937 runs (79 rows x S0/S1/S2/S3 x ideal/noisy/mount1.5) in 945 s
    at --jobs 6 on e174f22, 965f4f70e5d1. Verdict FAIL: P2 P3 P5 P8 R1 pass, P9 pass (sim suites
    with ROCKY_LEVEL=1); P1 (noisy: 1.19-1.68 mm of drift on a flat walk), P4 (21 row x IMU pairs
    under 95 %: slopes = the 5 % derate + MuJoCo stance creep, 3 rubble seeds, noisy stairs), P6
    (one noisy false void on 20 mm stairs, S1's own, B161) and P7 (noisy 30 mm rubble: belly
    15.2 / 16.1 mm) fail. level.enabled stays false.
    - sim/experiments/results/lip_grid[_level]_results.json: 356 stop, 8 tip, 0 fall with the
    leveler off and on (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
    [pebble_level.py, pebble_reflex.py, rocky_model.py, test_level.py]
2026-10-09 D065 wip 4: review fixes (21 findings)
    The two-reviewer round on the body leveler, 21 verified findings; every major one fixed, the
    cheap minors too, the rest said why (BUILD_LOG 9r, "The review round").
    The law (gait/pebble_level.py): the tick is a schedule (one law tick per call on a jittered
    50 Hz loop; the sim's 500 Hz calls tick as before); the copies move on every call (no 50 Hz
    staircase); a swing foot is airborne only 2 mm past the 15 mm band over the ground under its
    real xy (WaveGait.level_xy(foot=True)); an enabled leveler primes its derated envelope up
    front (prime() -> WaveGait.prime_level), so budget(level_slope=) is a lookup in the step.
    The sim: apply_gait keeps the leveler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
    [cockpit.py, params.yaml, pebble_gait.py, pebble_level.py, pebble_reflex.py, playground.py, run_lip_grid.py, terrain_bench.py]
2026-10-09 B162 wip 1: filter_s 1.0, rough-ground sink cap (walking-gated probe-roughness step cap: r0 12 mm -> sink 6 mm), rules restated (P1/P4/P6), full re-bench
    - level.filter_s 0.2 -> 1.0: the only value measured that holds every noisy flat
    row at 0.00 mm (0.6: 0.33, 0.8: 0.03); costs +0.4 s to settle a stone,
    +0.16-0.32 s a slope stand, an underdamped loop (rests 0.24-0.28 deg past
    level inside the deadband), more tilt on rough ground.
    - BodyLeveler sink cap (step 3b): walking, max - min probe_dz over the loaded
    feet, held 2 s and frozen in a planted stance; past rough_r0_mm the plane is
    scaled until c <= sink_limit(). params level: rough_r0_mm 12, rough_r1_mm 12,
    sink_max_mm 6, rough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
2026-10-09 B162: stays OFF: the stairs fail P4 (92.2 %, 46.5 %) and P7 (24.4 mm); held-out rubble now clears 25.1 / 25.7 mm
    The review round of wip 1 (1 blocker, 3 majors, 5 minors):
    - Blocker, P7 in-sample: the cap re-picked on train seeds >= 1000 only (12
    candidates, 1224 runs; rule: largest worst-case clearance over train 30 mm
    rubble + stairs, both IMU modes): rough_r0_mm 8, sink_max_mm 3, rough_hold_s 4,
    new rough_off_mm 4. Checked once on held-out rubble 100-111: 25.1 / 25.7 mm
    (wip 1 21.7 / 24.6). The bench now adds 12 held-out rubble seeds per height
    (heldout_rows, --heldout), P4 judges rubble per height over both tiers.
    - The cap fails closed: walking with no probe it caps the sink a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
    [params.yaml, pebble_level.py, playground.py, terrain_bench.py, test_level.py, test_playground_guards.py, test_terrain_bench.py]
2026-10-16 Cockpit brains + Models panel: concrete roles, GPU check, model admin, any-family installs, one chat on every screen
    Why: every llama-swap spawn failed while an idle ComfyUI held 13.3 GB, and the
    cockpit's fallback chains loaded five models in one turn trying anyway; roles
    were selectors, so it was unclear which model a pick loaded.
    Brains (sim/cockpit_brains.py, sim/gpu_check.py)
    - roles are concrete ids (qwen3.6-35b-a3b / lfm2.5-vl), not tool-model / vision-model
    - a turn loads at most one model the operator did not pick (MAX_COLD_FALLBACKS)
    and none while another program fills the GPU; the holder is named
    - multimodal mode looks with its own model; the mode is saved in the conf
    - a run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
2026-10-16 Brain settings, turn(deg) for the models, measured motion results, estimated-pose odometry, camera on the video
    Brain & chat → settings (sim/cockpit_brains.py, POST /api/brain/settings; saved in the conf)
    - tool rounds (MAX_HOPS 6, 1..20), reply tokens (512, 128..4096), turns remembered (12, 0..40)
    - thinking per model, off by default; on adds THINK_EXTRA_TOKENS to that model's reply limit
    (ROCKY_THINKING_MODELS still works)
    - every model call's usage: the turn's largest prompt against the model's context (llama-swap's
    -c, now in /api/models), answer tokens, answers cut off at the limit
    Motion the model can reason about
    - turn(deg) is offered to the local brains and over MCP (it was e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
2026-10-16 Docs: CODE_MAP catches up — recover8_d064 is the shipped righter, today's cockpit pieces, odometry how-to
    - the hand-off names the shipped righter (recover8_d064, recover1 the fallback); the published-number
    rows for righting and jitter run it, with RL_GUIDE §4's numbers (the owner's fix, extended)
    - 2.11: brain settings + `moved`, the camera API, the shared chat feed, how a tool is offered
    - 2.12: the odometry drift bench row; 2.19: the GPU check and the tests' switch
    - new 2.20: drive on the estimated pose, or measure its drift
    Claude-Session: https://claude.ai/code/session_01K5iAqjxabUgNiWZnW9Uk8Z
